EdgerEquals/knob-hardware/cad/README.md

# Parts library

These are the parametric CAD parts for Ed's hardware. Each part has its own folder with the build123d script, a STEP file, a DXF and a drawing PNG.
Dimensions marked [A] are assumed and need checking with calipers. Status is either "listing" (dimensions from listings) or "measured".

| Part | Folder | Version | Status | Notes |
|---|---|---|---|---|
| 1220 coreless planetary gearmotor, 1:144 | motors/1220-coreless-planetary | v0.1 (2026-10-31) | listing | Chosen for knob v1. Ø12 × 38 mm, plus a 5.5 mm D-shaft. Mounting holes TBC. |
| N30 planetary gearmotor | motors/n30-planetary | v0.1 (2026-10-31) | listing | Made from motor_gearbox.py in the 1220 folder by swapping parameters. |
| Knob main PCB | pcbs/knob-main-pcb | v0.9 (2026-10-31) | layout v5 | **Source is KiCad** (kicad/knob-main-pcb.kicad_pcb, made by kicad/make_board.py, KiCad 9.0.2; DRC clean). Plain Edge.Cuts outline 49.00 × 107.50 × 1.6, at x 0.75–49.75, y 10.5–118.0 from the panel top-left. H1 = footprints:Shaft_Hole_NPTH_5.2mm on the dial axis (v0.3: was 6.2; sized for the Ø5.0 brass tube + 0.1 per side [A]). v0.5: H2 is flipped to the back (B side), so the F682ZZ presses in from the PCB back with its flange on the back face; DRC clean, STEP re-exported. v0.4 added H2 = footprints:Bearing_F682ZZ_Press_NPTH_5.0mm (Ø5.0 NPTH press fit for the encoder bearing [A]) at (25.25, 71.9), 19.0 below the dial axis (25.25, 52.9). M1 = footprints:Motor_1220_Tabs at the motor position (39.25, 52.9): 14.0 mm right of the dial axis [A, motor offset TBC, gear/belt drive TBC]. The STEP comes from kicad-cli; knob_main_pcb.py only reads and draws it. | **v0.6:** H2 back on the FRONT (no flip): encoder bearing 1 goes in from the front through the base cradle floor into H2 (locating dowel); hole Ø5.0 NPTH unchanged; DRC 0; STEP re-exported. **v0.7:** H2 rotated 3.0° [A] about the dial axis (idler pinion clearance to the motor). **v0.8:** H1 = TubeRodClamp_Main_M1.6: NPTH Ø1.8 for the M1.6 rod, F.Cu ring Ø3.4–Ø6.4 net GND (brass tube soldered), B.Cu ring Ø2.4–Ø4.4 net VBUS_DATA (rod washer/nut). DRC 0, STEP re-exported. **v0.9:** motor M1 offset 14.0 → 11.0 (32T hub gear), H2 16.0 below the axis on the centre line (ENC_SET_ROT 0), U2 Omron_EE-SX1131 on B.Cu 20.20 below H2; DRC 0, STEP re-exported; sheet v0.9. |
| Knob stack (PCB + 1220 motor) | assemblies/knob-stack-v0.1 | v0.1 (2026-10-31) | superseded by v0.2 | Snapshot: motor on the dial axis, no shaft. The files are kept as drawn; if re-run, the script would pick up the v0.2 board. |
| Knob stack v0.2 (PCB + offset 1220 motor + 6 mm shaft) | assemblies/knob-stack-v0.2 | v0.2 (2026-10-31) | SUPERSEDED by v0.3 | knob_stack.py places everything from the KiCad positions. The shaft base flange sits on the PCB back and the shaft passes through H1; it stands 43.5 above the PCB front (45.0 − the 1.51 STEP board). The motor is on the front at M1: 38.0 mm body, 43.5 mm to its shaft tip. **Clash: the 49 × 49 flange covers the motor tab slots, and the tabs reach about 1 mm into the flange. Flange needs relief for motor tabs [check].** |
| Knob stack v0.3 (PCB + offset 1220 motor + brass 5×3 shaft) | assemblies/knob-stack-v0.3 | v0.3 (2026-10-31) | SUPERSEDED by v0.4 | Contains only the PCB, the 1220 motor at its 14.0 [A] offset (M1), and the brass tube with the printed 17.5 × 17.5 × 4.0 flange. The flange is bonded to the PCB back face. The tube passes through H1 (Ø5.2 NPTH) and runs forward, its back end flush with the flange back. Tube top is 43.49 above the PCB front (45.0 − the 1.51 STEP board). Motor is 38.0, 43.5 to its shaft tip. Flange to the nearest tab pad: 1.50. Pairwise clash check (tube/PCB, tube/motor, flange/PCB, flange/motor): none. Files: knob_stack.py, knob-stack-v0.3.{step,dxf}, knob-stack-v0.3-drawing.png |
| Knob stack v0.4 (all current parts) | assemblies/knob-stack-v0.4 | v0.4 (2026-10-31) | SUPERSEDED by v0.5 | Every part is imported from the library, with no new geometry. Parts: PCB v0.3 (KiCad STEP); 1220 motor at the 14.0 [A] offset; brass shaft v0.2 (57.31 tube plus the 17.5 × 4.0 flange); knob v0.1 (cap + hub, internal ring, bottom ring, pinion, bronze bush); screen holder v0.1; 0.71" GC9D01 TFT; screen adapter board. Key dimensions: 57.00 overall above the PCB front (glass top), knob OD 38.25 (gear tip Ø40.5), holder OD 22.32, motor offset 14.0. Pairwise interference: 16 parts, 120 pairs, 27 with overlapping bounding boxes checked. **Clashes (red on the sheet):** PCB/motor 4.24 mm³ (the motor rear boss Ø3 × 0.6 [A] goes into the PCB front); holder vs. TFT backing 10.20, glass 13.76 and tail 7.43 mm³ (COG ledge and folded tail go through the holder wall). **Notes:** knob OD ≥ the Ø35 bezel; the supplied 100 mm tail needs a short-tail variant. Files: knob_stack.py, knob-stack-v0.4.{step,dxf}, knob-stack-v0.4-drawing.png |
| Knob stack v0.5 (all current parts) | assemblies/knob-stack-v0.5 | v0.5 rev B (2026-10-31) | superseded by v0.6 | **Rev B:** the front view is now full section A-A, cut on the plane through the dial and motor axes (world XZ at the dial y), drawn front-up like the plan. Every cut part has its own hatch: PCB, motor, brass tube, flange, cap+skirt, 68T ring, 90T bottom ring, pinion, bush, encoder big gear (chord), holder, TFT backing, TFT glass, adapter board. The encoder pinion, shaft and bearings are off the plane. The cutting line A-A with arrows is on the side view, because the plane is parallel to the plan view. Same parts as v0.4, but with knob v0.2 (skirt round the motor, 90T bottom internal ring), PCB v0.4 (H2) and encoder take-off v0.1; all imported from the library. The back panel is a dashed line only, 25 [A] behind the PCB back. 57.00 overall above the PCB front; skirt OD 48.00 (ring band Ø49.25); holder OD 22.32; motor offset 14.0; skirt 2.0 above the PCB. Pairwise check: 21 parts, 210 pairs, 33 with overlapping bounding boxes. **Clashes (red):** PCB/motor 4.24 mm³ (motor rear boss Ø3 × 0.6 [A]); holder vs. TFT backing 10.20, glass 13.76 and tail 7.43 mm³. The skirt and the encoder parts clash with nothing. **Notes (red):** the skirt OD is over the 49 PCB width and the Ø35 bezel; the big gear is behind the PCB [A], passing under the shaft flange and the tube's wire exit; the 100 mm tail needs a short-tail variant. Files: knob_stack.py, knob-stack-v0.5.{step,dxf}, knob-stack-v0.5-drawing.png |
| Knob stack v0.6 (all current parts) | assemblies/knob-stack-v0.6 | v0.6 rev A (2026-10-31) | superseded by v0.7 | v0.5 plus bezel v0.1, with knob v0.3 (PTFE 10x8 liner instead of the bronze bush), encoder take-off v0.2 (bearing 1 from the PCB back) and PCB v0.5. Front view = full section A-A through the dial and motor axes, each cut part hatched differently (bezel and PTFE liner now in the cut); the A-A line is on the side view. The screen holder (unchanged) now sits on the bezel face at 47.30, 1.50 higher, so the holder, screen and adapter move up 1.50; overall 58.50 above the PCB front. 22 parts, 231 pairs, 42 with overlapping bounding boxes. **Clashes (red):** PCB/motor 4.24 mm³ (motor rear boss); holder vs. TFT backing 10.20, glass 13.76, tail 7.43 mm³. Bezel, liner and encoder parts clash with nothing. **Notes (red):** tube v0.2 now engages the holder socket only 4.50 of 6.0 (tube +1.50 = 58.81 if wanted; not changed); skirt OD over the board and bezel; big gear behind the PCB; 100 mm tail. Also a shaded isometric half-section (iso_section.py → knob-stack-v0.6-iso-section.png, knob-stack-v0.6-half-section.step; pyvista offscreen, near half removed, cut faces lighter, clashes red). Files: knob_stack.py, iso_section.py, knob-stack-v0.6.{step,dxf}, knob-stack-v0.6-drawing.png |
| Knob stack v0.7 (all current parts) | assemblies/knob-stack-v0.7 | v0.7 rev B (2026-10-31) | superseded by v0.8 | **Rev B (Ed: top-left must be a top view; the right view rotated 90°):** sheet in the new z-up layout. Top-left = TOP view looking down the dial axis (board outline, knob, gears, A-A cutting line with arrows); bottom-left = FRONT = section A-A (Z up, board at the bottom, shaft up); right = RIGHT SIDE view with Z up, so the PCB faces, knob top and shaft tip line up with the section. Notes moved beside the top view. v0.6 with bezel v0.1 → bezel knob v0.2 (Ø48 ring on the big knob, top flush with the glass, ±10° [A]); holder/screen/adapter 1.80 above the holder v0.1 frame (base 47.60). Overall 58.80 above the PCB front. Sheet: section A-A front view, plan and side views. 22 parts, 231 pairs, 50 bbox-overlapping. **Clashes (red):** PCB/motor 4.24 mm³; bezel knob vs TFT backing 13.76, glass 16.53, tail 5.24 mm³ (COG ledge and folded tail into the pocket wall; new); holder vs TFT backing 10.20, glass 13.76, tail 7.43 mm³. **Notes (red):** tube engagement 4.20 of 6.0; skirt OD; big gear behind the PCB; 100 mm tail. Isometric half-section: knob-stack-v0.7-iso-section.png + knob-stack-v0.7-half-section.step (the screen clashes lie in the removed half and are shown whole). Files: knob_stack.py, iso_section.py, knob-stack-v0.7.{step,dxf}, knob-stack-v0.7-drawing.png |
| Knob stack v0.8 (all current parts) | assemblies/knob-stack-v0.8 | v0.8 rev A (2026-10-31) | superseded | knob_stack.py (z-up sheet, section A-A through dial + motor axes, 21 parts, pairwise clash check: PCB/motor 4.24 and the known TFT ledge/tail clashes vs holder and control dial; no tube, cradle or gear clash), iso_section.py (iso half-section PNG + STEP), export_mobile.py (GLB + USDZ full and half-section, m, Y up, coloured per part, re-import checked). Parts: PCB v0.6, base cradle v0.3, brass tube v0.2 (now 4.0 proud of the PCB back, flagged), control dial v0.3, big knob v0.4, encoder v0.3, screen holder v0.2, TFT, adapter. |
| Knob stack v0.9 (all current parts) | assemblies/knob-stack-v0.9 | v0.9 rev A (2026-10-31) | superseded by v0.10 | 32 parts; section A-A through the dial + motor axes, pairwise clash check, iso half-section, GLB + USDZ (whole + half). Big knob v0.5 + 688ZZ, control dial v0.4 + magnet placeholder, screen holder v0.4, brass tube v0.4 + M1.6 rod/sleeve/nuts, base cradle v0.4 (3.5 plate), encoder v0.4 + 2 idler pinions on Ø1.5 pins, PCB v0.8, adapter v0.2. Clashes left: PCB/motor rear boss 4.24 and the known TFT ledge/tail vs holder and control dial. |
| Knob stack v0.10 (all current parts) | assemblies/knob-stack-v0.10 | v0.10 rev A (2026-10-31) | superseded by v0.11 | v0.9 with big knob v0.6 (raised rim removed; top face 52.50, 4.30 below the glass; knob height 50.5) and control dial v0.5 (4.0 lip out to the full Ø48 on top of the knob, 0.3 [A] running gap; magnet placeholder Ø39.4×Ø43.4×2.0 [A] in a pocket in the lip underside, facing the knob top 0.3 below). Bearing 688ZZ → MR128ZZ 8×12×3.5 [A] (40.10–43.60) on the unchanged Ø8.12 dial tube; knob hub Ø19.0 → Ø15.0, outer race on a Ø10.6 bottom lip, dial bears on the inner race through a Ø9.2 collar. 32 parts; clashes unchanged from v0.9 (PCB/motor rear boss 4.24, TFT ledge/tail vs holder and control dial); no knob/dial/bearing clash. Files: knob_stack.py, iso_section.py, export_mobile.py, knob-stack-v0.10.{step,dxf,glb,usdz}, -half-section.{step,glb,usdz}, -drawing.png, -iso-section.png |
| Knob stack v0.11 (all current parts) | assemblies/knob-stack-v0.11 | v0.11 rev A (2026-10-31) | Ed spec | Ed: motor in to the axis, top 68T ring removed, motor drives the knob from its bearing hub: 12T pinion on a 32T m0.5 external hub gear, motor offset 14.0 → 11.0 (ratio 32:12 = 2.667, was 68:12 = 5.667). Knob Ø48 → Ø42 (big knob v0.7), dial lip Ø42 + magnet Ø33.4–37.4 (control dial v0.6, tube extended down to 8.60), 12 × Ø1 ball thrust bearing on the cradle tube collar (bearings/dial-thrust-v0.1), bottom ring 78T, pinions at r 16.0 (encoder 90° from the motor; idlers 41°/150°, flagged), base cradle v0.5 (Ø37), 94T big gear + 119-window slotted rim through an Omron EE-SX1131 (U2, PCB back): 476 counts/gear turn, 2652/knob turn. PCB v0.9 (DRC 0). 34 parts; clashes unchanged (PCB/motor 4.24, TFT ledge/tail vs holder and dial). Ed: no GLB/USDZ any more; deliverable = knob-stack-v0.11-sections.png (A-A straight on + iso, colour). Also: knob_stack.py (sheet + STEP + DXF), iso_section.py (iso sheet, half STEP, sections PNG), encoder_closeup.py (section B-B through the sensor, stack behind the PCB). |
| ~~Fixed hollow shaft, 4 mm~~ | shafts/fixed-hollow-shaft-4mm | v0.1 (2026-10-31) | **SUPERSEDED** | Superseded (now fixed-shaft-brass-5x3); was replaced by fixed-hollow-shaft-6mm (Ed's two-piece FDM redesign). Kept for reference only: stainless tube, Ø4.0 OD × Ø2.0 bore, 45 mm long. |
| ~~Fixed hollow shaft 6 mm (two-piece: base + top)~~ | shafts/fixed-hollow-shaft-6mm | v0.1 (2026-10-31) | **SUPERSEDED** | Superseded by fixed-shaft-brass-5x3. The two-piece printed shaft is kept for reference only. |
| ~~Fixed hollow shaft 4 mm, one piece (printed, splined)~~ | shafts/fixed-hollow-shaft-4mm-onepiece | v0.1 (2026-10-31) | **SUPERSEDED** | Superseded by fixed-shaft-brass-5x3 before it was finished: a splined top isn't practical, so the shaft went to metal. Kept for reference only. |
| Fixed shaft: brass tube 5 × 3 | shafts/fixed-shaft-brass-5x3 | v0.1 (2026-10-31) | SUPERSEDED by v0.2 | Brass tube 5 OD × 3 ID stock, cut to length, knurl dial end only. 49.0 long: 45 [A] above the flange front face plus the 4.0 flange. The back end sits flush with the flange back. Top 8 mm [A]: straight knurl for the epoxy bond, or 2 opposed 0.3 flats [A]; drawn hatched, not modelled. 0.3 deburr at both bore ends [A]. Carries 4 × 36 AWG. The PCB hole must change to 5.2 mm (not yet done). Files: brass-tube-5x3.* |
| Fixed shaft: printed flange | shafts/fixed-shaft-brass-5x3 | v0.1 (2026-10-31) | SUPERSEDED by v0.2 | CF-ASA or PETG. Custom square: the 20.0 target [A] shrinks automatically to 17.5 × 17.5 so it stays ≥ 1.5 [A] from the motor tab pads (read from KiCad M1, motor 14.0 offset [A]). Actual clearance 1.50. 4.0 thick [A], Ø5.0 bore, centred on H1. The tube is epoxy-bonded in, and the flange is bonded to the PCB back. Files: shaft-flange-printed.* |
| Fixed shaft: brass + flange together | shafts/fixed-shaft-brass-5x3 | v0.1 (2026-10-31) | SUPERSEDED by v0.2 | Tube bonded into the flange. All three sheets come from fixed_shaft_brass.py. Files: fixed-shaft-brass-5x3-assembled.* |
| Knob cap + hub | knob/knob-v0.1 | v0.1 (2026-10-31) | SUPERSEDED by knob v0.2 (pinion, 68T ring, hub and bush still used from here) | Printed CF-ASA or PETG, one piece with both ring gears [A]. Cap Ø38.25 × 1.5 [A], top 45.5 above the PCB front. Hub Ø11 [A] × 6.0 with an Ø8.0 bore for a bronze bush 5x8x6 [A] that runs on the Ø5 brass tube. **Flag:** knob OD 38.25 (bottom-gear tip Ø40.5) is ≥ the Ø35 bezel. The tube flags are cleared since shaft v0.2: the tube top is at 51.8, so the bush is fully engaged (6.0 of 6.0) and the knurl zone starts at 45.8, above the bush. The bush is a bought part, modelled by build_bush() in knob_gears.py. Files: knob-cap-hub.* |
| Motor pinion | knob/knob-v0.1 | v0.1 (2026-10-31) | SUPERSEDED by knob v0.2 (pinion, 68T ring, hub and bush still used from here) | 12T, m 0.5, 20° involute (generated in knob_gears.py), backlash 0.10 [A]. Tip Ø7.0, pitch Ø6.0, root Ø4.75. D-bore Ø3.05 / flat 2.55 [A] for the 1220 3 mm D-shaft. Face 3.0 [A], front flush with the shaft tip (40.5–43.5 above the PCB front). **Flag:** 0.88 wall to the shaft; undercut below 17T, no profile shift. Files: motor-pinion.* |
| Internal ring gear | knob/knob-v0.1 | v0.1 (2026-10-31) | SUPERSEDED by knob v0.2 (pinion, 68T ring, hub and bush still used from here) | 68T internal, m 0.5, pitch Ø34.0, tip Ø33.0, root Ø35.25. The OD is Ø38.25, giving a 1.5 wall outside the root [A]. Band 40.0–44.0 above the PCB front (pinion ± 0.5 [A]). Centre distance (68 − 12) × 0.5 / 2 = 14.00, which equals the KiCad motor offset exactly. Files: internal-ring-gear.* |
| Bottom ring gear (encoder take-off) | knob/knob-v0.1 | v0.1 (2026-10-31) | SUPERSEDED by knob v0.2 (pinion, 68T ring, hub and bush still used from here) | 79T external, m 0.5 [A]. The tooth count is a parameter: by default, the smallest count whose root is ≥ the knob OD. Pitch Ø39.5, tip Ø40.5, root Ø38.25, bore Ø35.25. Face 1.5 [A] at the knob base (38.5 = motor front + 0.5 [A]). Encoder pinion TBC, not drawn. Files: bottom-ring-gear.* |
| Knob v0.1 together | knob/knob-v0.1 | v0.1 (2026-10-31) | SUPERSEDED by knob v0.2 (pinion, 68T ring, hub and bush still used from here) | Knob + pinion (at the 14.0 offset) + both rings, all from knob_gears.py. Knob height 7.0 (38.5–45.5 above the PCB front). Pairwise clash check (pinion vs. internal ring / cap+hub / bottom ring): none. Not in the assembly yet. Files: knob-v0.1-together.{step,dxf}, knob-v0.1-together-drawing.png |
| Knob v0.2 cap + skirt | knob/knob-v0.2 | v0.2 (2026-10-31) | superseded by knob v0.3 | The dial body now wraps around the outside of the offset motor and comes down to 2.0 above the PCB front [Ed]. Skirt ID Ø44.00 = 2 × (20.0 motor reach + 2.0 clearance [Ed]); OD Ø48.00 (2.0 wall [A]). The cap spans from the hub to the skirt at 44.0–45.5. The hub, bush bore, 68T ring, 12T pinion and bronze bush are unchanged and imported from knob v0.1. **Flag:** the skirt OD is over the 49 PCB width and the Ø35 bezel. Files: knob_v02.py, knob-cap-skirt.* |
| Knob v0.2 bottom internal ring (encoder) | knob/knob-v0.2 | v0.2 (2026-10-31) | superseded by knob v0.3 | 90T INTERNAL, m 0.5, 20° involute, replacing v0.1's external 79T. Tooth count = the smallest whose tip circle stays ≥ the skirt ID. Tip Ø44.00, pitch Ø45.00, root Ø46.25; band OD Ø49.25 (1.5 outside the root [A]), stepping out from the 48.0 skirt. Face 3.0 [A], 2.0–5.0 above the PCB front at the skirt's bottom inner edge. Driven part: encoder take-off v0.1 (its 14T pinion meshes inside; sheet notes updated, the stale 'TBC, not drawn' note is gone). Files: bottom-internal-ring.* |
| Knob v0.2 together | knob/knob-v0.2 | v0.2 (2026-10-31) | superseded by knob v0.3 | Cap/skirt + 68T ring + 90T bottom ring + 12T pinion + bush. Knob height 43.5 (2.0–45.5). No clash between the knob parts. Files: knob-v0.2-together.{step,dxf}, knob-v0.2-together-drawing.png |
| Control dial v0.1 (was "bezel", then "bezel knob") | control-dial/control-dial-v0.1 | v0.1 (2026-10-31) | superseded | Renamed CONTROL DIAL by Ed; folder moved from bezel-knob/bezel-knob-v0.1. Title re-rendered "superseded". |
| Control dial v0.2 (was "bezel knob v0.2") | control-dial/control-dial-v0.2 | v0.2 (2026-10-31) | superseded by control dial v0.3 | Folder moved from bezel-knob/bezel-knob-v0.2; geometry unchanged. |
| Knob v0.3 cap + skirt | knob/knob-v0.3 | v0.3 (2026-10-31) | superseded by knob v0.4 | v0.2 with the hub bore only changed: Ø8.0 → Ø10.0 for the PTFE 10x8x6 liner [S], hub OD 11 → 13 (1.5 wall kept [A]). The bronze bush is removed. Section A-A as the front view. Files: knob_v03.py, knob-cap-skirt.* |
| Knob v0.3 together | knob/knob-v0.3 | v0.3 (2026-10-31) | superseded by knob v0.4 | Cap/skirt + 68T ring + 90T bottom ring + 12T pinion + PTFE liner 10 × 8 × 6 [S] (pressed in the hub, turns with the knob, runs on the bezel journal). No clash between the knob parts. Files: knob-v0.3-together.{step,dxf}, knob-v0.3-together-drawing.png |
| Encoder take-off v0.1: bearings | encoder-takeoff/encoder-takeoff-v0.1 | v0.1 (2026-10-31) | superseded by encoder take-off v0.2 | 2 × F682ZZ flanged miniature ball bearing, 2 × 5 × 2.3, flange Ø6.1 × 0.6 [A] (envelope). Bearing 1 is pressed into PCB H2 (Ø5.0 NPTH [K]) with its flange on the front; bearing 2 sits in the back panel [A]. Files: encoder-bearing-f682zz.* |
| Encoder take-off v0.1: pinion | encoder-takeoff/encoder-takeoff-v0.1 | v0.1 (2026-10-31) | superseded by encoder take-off v0.2 | 14T [A], m 0.5, 20° involute, Ø2 bore [Ed], face 2.6 [A] at 2.2–4.8 above the PCB front, hub Ø3.5 on the bearing inner race. Meshes inside the dial's 90T bottom ring: (90 − 14) × 0.5 / 2 = 19.00 = the KiCad H2 offset. Placed below the dial axis, 90° from the motor [A]. Ratio 90:14 = 6.429. Files: encoder-pinion.* |
| Encoder take-off v0.1: shaft | encoder-takeoff/encoder-takeoff-v0.1 | v0.1 (2026-10-31) | superseded by encoder take-off v0.2 | Ø2 steel [Ed/A], 33.01 long: from the pinion top (4.8 above the PCB front) to the bottom of bearing 2. The back panel is 25 behind the PCB back [A] (unknown) and is drawn only as a dashed line. Files: encoder-shaft.* |
| Encoder take-off v0.1: big gear | encoder-takeoff/encoder-takeoff-v0.1 | v0.1 (2026-10-31) | superseded by encoder take-off v0.2 | 94T, m 0.5 [A], tip Ø48.0: the biggest that fits the 49.0 board width with a 0.5 margin [A]. Hub Ø5 × 2 [A]. It sits BEHIND the PCB [A] (only 2 mm under the skirt), with its top 6.01 behind the PCB front (board + 4 flange + 0.5). **Flag:** it passes under the shaft flange and the tube's wire exit. It drives the encoder (TBC, not drawn). Files: encoder-big-gear.* |
| Encoder take-off v0.1 together | encoder-takeoff/encoder-takeoff-v0.1 | v0.1 (2026-10-31) | superseded by encoder take-off v0.2 | encoder_takeoff.py: bearings, pinion, shaft and big gear; PCB faces and the back panel are dashed reference lines. No clash between these parts. Files: encoder-takeoff-together.{step,dxf}, encoder-takeoff-together-drawing.png |
| Encoder take-off v0.2 (all parts + together) | encoder-takeoff/encoder-takeoff-v0.2 | v0.2 (2026-10-31) | superseded by encoder take-off v0.3 | Ed: the PCB bearing comes in from the other way. Bearing 1 (F682ZZ 2 × 5 × 2.3, flange Ø6.1 × 0.6 [A]) now presses in from the PCB BACK with its flange on the back face (−2.11 to +0.19); KiCad H2 flipped to B (PCB v0.5). Only the pinion hub changes: it rests on the inner race at 0.19 (hub 2.0 long, was 1.6). Teeth 2.2–4.8, shaft 33.01, 94T big gear and bearing 2 are unchanged. Ratio 90:14 = 6.429. Files: encoder_takeoff_v02.py, encoder-{bearing-f682zz,pinion,shaft,big-gear,takeoff-together}.{step,dxf}, *-drawing.png |
| Fixed shaft v0.2: brass tube 5 × 3 + flange | shafts/fixed-shaft-brass-5x3-v0.2 | v0.2 (2026-10-31) | superseded (tube v0.4; flange replaced by the base cradle) | Brass tube 5 OD x 3 ID stock, cut to length, knurl dial end only. **Length derived** from the screen holder: the top ends at the holder socket's blind end, 51.8 above the PCB front (knob top 45.5 + 0.3 [A] + 6.0 socket [A]). That gives 53.31 above the flange front, 57.31 long (v0.1: 49.0). **Ed said shorten, but the derived length is longer [check].** Knurl zone = the 6.0 socket engagement. Flange unchanged: 17.5 × 17.5 × 4.0, 1.50 to the tab pads. Three sheets from fixed_shaft_brass_v02.py. Files: brass-tube-5x3.*, shaft-flange-printed.*, fixed-shaft-brass-5x3-assembled.* |
| 0.71" round TFT (GC9D01, centre-button screen) | displays/tft-0.71-round-gc9d01 | v0.1 (2026-10-31) | datasheet + [A] | 160x160 IPS, GC9D01N (the GC9A01 is the 1.28" 240x240 panel). Backing Ø20.12 [S] (the glass OD used for the holder), LCD Ø19.9 [S], 22.30 overall including the COG ledge [S], active Ø18 [S], 1.90 thick [S] (glass 1.1 / backing 0.8 [A]). Ledge width 12.0 [A]. Tail 14 pin, 7.50 wide, 0.30 thick, 2.5 stiffener, supplied 100 long [S], pitch 0.5 [A]; drawn folded behind. Source: Zhunyi spec Z07101-P14-G9DN-Y1 V1.0, mechanical drawing p.5, https://www.panelook.cn/upload/product/258253/202502242704.pdf; cross-checked with EastRising ER-TFT0.71-2 (buydisplay.com, 20.12 × 22.30 × 1.8) and SWICN LB071R-PF01 (1.86 thick, 10-pin ZIF 0.5 pitch). **Flag:** the 100 mm tail needs a short-tail variant. Files: tft_071_round.py, tft-0.71-round-gc9d01.* |
| Screen adapter board | pcbs/screen-adapter | v0.2 (2026-10-31) | Ed spec | **Source is KiCad** (kicad/screen-adapter.kicad_pcb, made by kicad/make_board.py; DRC clean, 0 violations). Round Ø15.5 [A] (≤ 18), 2 layers, 1.0 thick [A]. Placed, not routed: J1 FPC_14P_0.5mm_Top [A] at y +3.2; U1 QFN-20_3x3_P0.4_CH32V003 (CH32V003F4U6 [A]) at y −3.5; W1 WirePads_4x_0.7mm_Back (VCC GND D1 D2) on the back at the centre, over the Ø3.0 wire bore. The footprints are in the shared kicad/footprints.pretty. STEP = bare board (0.91 body); screen_adapter.py adds component envelopes [A] for drawings. Files: screen-adapter.step, screen_adapter.py, screen-adapter.dxf, screen-adapter-drawing.png | **v0.2:** W1 wire pads removed (data over power); C1 = TubeRodClamp_Adapter_M1.6: NPTH Ø1.8, B.Cu ring Ø3.2–Ø5.6 GND (tube top contact), F.Cu ring Ø2.4–Ø3.6 VBUS_DATA (thin nut). J1 moved to 3.7, U1 to 3.8 from the centre. DRC 0. kicad-cli drops the hole in the STEP for the circular outline, so screen_adapter.py cuts the NPTH holes from the KiCad data.
| Screen holder | holders/screen-holder-v0.1 | v0.1 (2026-10-31) | Ed spec | Printed CF-ASA or PETG cup, FIXED, epoxy-bonded on the knurled tube top. Socket Ø5.2 (0.1 glue gap per side [A]) × 6.0 [A]; Ø3.0 wire passage; 1.0 floor [A]; board pocket Ø15.9; screen pocket Ø20.32 × 1.90, glass flush with the rim [A]. OD 22.32 = 20.12 + 2 × 0.1 + 2 × 1.0 wall [A]. Spans 45.8–57.0 above the PCB front: bottom = knob top 45.5 + 0.3 running clearance [A]. Files: screen_holder.py, screen-holder.* |
| Screen stack together (holder + TFT + board + tube top) | holders/screen-holder-v0.1 | v0.1 (2026-10-31) | Ed spec | screen_stack_together.py; not in the main assembly yet. **Clash (red on the sheet):** the screen's COG ledge reaches 12.24 from the axis, and the folded tail also sits outside the 11.16 holder radius. Overlaps: ledge/backing 10.20 mm³, glass 13.76 mm³, tail 7.43 mm³; this needs a slot or a bigger OD. No other clash. Files: screen-stack-together.{step,dxf}, screen-stack-together-drawing.png |
| Control dial v0.3 | control-dial/control-dial-v0.3 | v0.3 (2026-10-31) | superseded | PETG, spring-centred Hall-sensed ±10° [A] (spring/magnet/Hall TBC, not drawn). Plain tube Ø5.12/Ø8.12 (1.5 wall) on the brass from 13.00 (above the reserved bearing zone over the base cradle boss) to the body 45.80–56.80, OD 48, top flush with the glass; 5.70 thick near the axis; bore Ø7.30 over the holder boss. |
| Big knob v0.4 (cap + skirt + tube, 68T, 90T, pinion) | knob/knob-v0.4 | v0.4 (2026-10-31) | superseded | No OD step: one Ø48 the whole height, 90T kept (local wall 0.875 outside the root, flagged red). Plain tube Ø8.24/Ø11.24 (1.5 wall) on the control-dial tube from 13.00 to the hub; motor clears the tube by 2.38. 8.0–13.0 above the PCB front reserved for future bearing [A] (not drawn). |
| Screen holder v0.2 | holders/screen-holder-v0.2 | v0.2 (2026-10-31) | superseded | Thinner: walls/floor 0.8 [A]; boss Ø7.0 on the tube top 51.80; socket engagement 5.70 (spec 6.0, flagged); glass top 56.80. |
| Base cradle v0.3 (was the shaft flange) | base-cradle/base-cradle-v0.3 | v0.3 (2026-10-31) | superseded | Printed CF-ASA/PETG [A], bonded to the PCB FRONT (nothing on the back now). Ø43.0 × 36.0 solid fill inside the skirt (0.5 [A] to skirt ID / 90T tips), Ø5.2 bonded tube bore 8.0 long, Ø12.2 bonded motor bore (tab pads inside, 2.16 margin), Ø12.24 clear bore round the dial tubes above 8.0, Ø9.0 encoder pinion pocket above a 1.0 [A] floor with a Ø5.0 press bore: encoder bearing 1 goes through it into PCB H2 = locating dowel. Base plate 3.0 [A] merges into the fill. |
| Encoder take-off v0.3 (pinion + together) | encoder-takeoff/encoder-takeoff-v0.3 | v0.3 (2026-10-31) | superseded | Bearing 1 pressed in from the FRONT: flange on the cradle floor (top 1.60), body 1.0 in the cradle + 0.70 in the PCB (dowel). Pinion hub 0.6 (was 2.0); teeth, shaft 33.01, 94T Ø48 big gear, bearing 2 and H2 position (90° from the motor, 19.0 along the board) unchanged. |
| Big knob v0.5 (body + 688ZZ + rings + pinion) | knob/knob-v0.5 | v0.5 (2026-10-31) | superseded by v0.6 | Big-knob tube removed. Short hub Ø19.0 houses a 688ZZ 8×16×5 [A] (38.60–43.60) whose inner race is pressed on the unchanged control-dial tube Ø8.12. Thick body (top 47.20 under the dial web, 52.50 under the lip), 2.0 [A] raised rim at the OD up to 56.80 round the dial lip + magnet. OD Ø48 no step, skirt, 68T, 90T, 12T pinion kept; height 54.8. |
| Big knob v0.6 (body + MR128ZZ + rings + pinion) | knob/knob-v0.6 | v0.6 (2026-10-31) | superseded by v0.7 | v0.5 with the raised rim removed: top face 52.50 (4.30 below the glass, under the Ø48 dial lip, 0.3 [A]); height 50.5 bottom ring to top. MR128ZZ 8×12×3.5 [A] at 40.10–43.60, inner race on the control-dial tube Ø8.12; hub Ø15.0 (1.5 wall [A]), 3.0 from the pinion tips, 1.6 above the motor front; outer race pressed in on a Ø10.6 × 0.5 bottom lip [A]. Files: knob_v06.py, knob-body / knob-v0.6-together .{step,dxf,png} |
| Big knob v0.7 (body + 32T hub gear + MR128ZZ + 78T ring + pinion) | knob/knob-v0.7 | v0.7 (2026-10-31) | Ed spec | 68T internal ring removed; 32T m0.5 external gear on the bearing hub (tip Ø17.0, root Ø14.75, 39.60–44.00; 1.375 root wall over the Ø12 bearing bore, flagged); 12T pinion at offset 11.0 [K]. 31T/10.75 rejected (1.125 wall), 30T/10.5 (motor 0.44 from the dial tube). OD Ø42.0 (skirt ID 38 = 2.0 to the motor), 78T bottom ring (0.875 wall, flagged). Height 50.5, top 52.50, MR128ZZ as v0.6. Files: knob_v07.py, knob-body / knob-v0.7-together .{step,dxf,png} |
| Control dial v0.4 + magnet placeholder | control-dial/control-dial-v0.4 | v0.4 (2026-10-31) | superseded by v0.5 | Tube Ø5.12/Ø8.12 from 13.00 unchanged [Ed]. Hub Ø11.30 (2.0 wall) round the holder boss, 1.5×45° gusset, 4.0 web under the screen cup, 4.0 lip (52.80–56.80) Ø39.4, flush with the glass. Brass runs inside the dial to 46.30 past the tube/hub junction; 688ZZ inner race directly under the hub (snap-off fix). Magnet [A] size TBC: Ø39.4 × Ø43.4 × 3.0 ring on the lip OD, 0.3 to the knob rim. |
| Control dial v0.5 + magnet placeholder | control-dial/control-dial-v0.5 | v0.5 (2026-10-31) | superseded by v0.6 | Lip 4.0 (52.80–56.80, flush with the glass) out to Ø48 = big knob OD [Ed], 0.3 [A] above the knob top. Magnet placeholder [A] (size TBC) Ø39.4×Ø43.4×2.0 in a pocket in the lip underside, 2.0 skin above. Hub face raised 0.3 with a Ø9.2 [A] collar onto the MR128ZZ inner race. Tube Ø5.12/Ø8.12 from 13.00 unchanged [Ed]; web, hub, gusset, fillet as v0.4. Files: control_dial_v05.py, control-dial .{step,dxf}, control-dial-drawing.png, magnet-placeholder.step |
| Control dial v0.6 + magnet placeholder | control-dial/control-dial-v0.6 | v0.6 (2026-10-31) | Ed spec | Lip 4.0 out to Ø42 = knob OD; magnet [A] Ø33.4–Ø37.4 × 2.0 in the lip underside. Tube Ø5.12/Ø8.12 unchanged but extended down from 13.00 to 8.60 onto the dial thrust bearing (groove race in its bottom face). Files: control_dial_v06.py, control-dial .{step,dxf}, control-dial-drawing.png, magnet-placeholder.step |
| Dial thrust bearing (ball carrier + 12 balls) | bearings/dial-thrust-v0.1 | v0.1 (2026-10-31) | Ed spec | 12 × Ø1.0 steel balls [Ed] on PCD Ø6.80 [A] between the cradle tube collar (8.00) and the dial tube bottom (8.60); grooves R0.55 × 0.25 [A] in both faces (0.11 from the tube OD, flagged); printed carrier Ø5.30 × Ø8.60 × 0.40 [A], 12 × Ø1.10 pockets, web 0.66. Option: thin steel washers [A]. Files: dial_thrust_v01.py, thrust-carrier(.step/.dxf/-drawing.png), thrust-carrier-with-balls(...) |
| Screen holder v0.3 | holders/screen-holder-v0.3 | v0.3 (2026-10-31) | superseded by v0.4 | Boss 0.3 longer: socket 6.00. |
| Screen holder v0.4 | holders/screen-holder-v0.4 | v0.4 (2026-10-31) | Ed spec | Brass tube now runs through the floor to the adapter board (tube top 52.60 = board seat; the rod clamps the board on the tube). Socket Ø5.2 through, 6.00 on the tube (boss 46.60). Glass 56.80 unchanged. |
| Fixed shaft v0.3: brass tube | shafts/fixed-shaft-brass-5x3-v0.3 | v0.3 (2026-10-31) | superseded by v0.4 | 53.31, flush with the PCB back. |
| Fixed shaft v0.4: brass tube (GND) | shafts/fixed-shaft-brass-5x3-v0.4 | v0.4 (2026-10-31) | Ed spec | 52.60 long; bottom soldered on the PCB F.Cu GND ring (no longer through the board), top bears on the adapter B.Cu GND ring. |
| Centre rod M1.6 + sleeve + nuts/washer (VBUS_DATA) | shafts/rod-m1.6-v0.1 | v0.1 (2026-10-31) | Ed spec | M1.6 rod [A] 58.21 (−3.61 to 54.60), sleeve Ø1.7/Ø2.6 × 52.6 [A] (PTFE or 3/32" 2:1 heatshrink; 0.70 radial room, 0.20 to the bore). Top DIN 439 thin nut s3.2×1.0 on the adapter (0.30 under the screen); bottom DIN 125 washer + DIN 934 nut under the PCB. |
| Base cradle v0.4 | base-cradle/base-cradle-v0.4 | v0.4 (2026-10-31) | superseded by v0.5 | 3.5 [A] plate Ø43.0 on the PCB front (was the 36 solid). Tube collar Ø9.2 to 8.0 (7.4 bonded above a Ø7.0×0.6 counterbore over the solder ring), motor collar Ø15.0 to 12.0 [A], encoder bearing seat (1.0 floor, Ø5.0, dowel into H2), 2 idler pockets (1.7 floor, Ø1.5 pin holes). |
| Base cradle v0.5 | base-cradle/base-cradle-v0.5 | v0.5 (2026-10-31) | Ed spec | Plate Ø37.0 × 3.5; motor collar Ø15 (at 11.0) merged with the Ø9.2 tube collar (2.3 web between bores); thrust groove race on the collar top (8.0); Ø9.12 clearance + window round the dial tube 8.0–12.0; encoder pocket at 16.0 on the centre line, idler pockets/pins at 41° and 150°. Files: base_cradle_v05.py, base-cradle.{step,dxf}, base-cradle-drawing.png |
| Encoder take-off v0.4 (idler pinion + pin, together) | encoder-takeoff/encoder-takeoff-v0.4 | v0.4 (2026-10-31) | superseded by v0.5 | 3 × 14T pinions 120° apart in the 90T ring; set rotated 3.0° [A] (encoder 273°, idlers 33°/153°, motor 0°) so the nearest idler clears the motor by 0.53. Idlers: plain Ø1.6 bore on Ø1.5 steel pins [A] (5.4 long, Ø3.5 head), pin engagement 1.7 [check]. Big gear now 90T Ø46.0 (was 94T) to stay on the board [check]. |
| Encoder take-off v0.5 (sensor, big gear + slotted rim, idler, together) | encoder-takeoff/encoder-takeoff-v0.5 | v0.5 (2026-10-31) | Ed spec | 78T ring, three 14T pinions at r 16.0: encoder 270° (90° from the motor), idlers 41° (min 40.73° to clear the motor) and 150°, gaps 131/109/120° (flagged; the alternative was rotating the whole set 11° and dropping the big gear to 81T). Big gear 94T Ø48 on the centre line + slotted rim r 19.60–20.80, 119 windows pitch 1.0667 (0.8 channel spacing = 3/4 pitch, quadrature), resin print flagged. Encoder Omron EE-SX1131 [Ed] modelled from the datasheet (5 × 4 × 4, slot 2.0 × 2.8, axis 1.0 from the open face; tabs [A]). Behind-PCB stack: PCB back −1.51, sensor to −5.51, rim top −3.31, gear −6.01/−8.01, hub −10.01, bearing 2 −25.91/−28.21 (shaft end); back panel 25 [A], minimum 9.6. Files: encoder_takeoff_v05.py, encoder-sensor-ee-sx1131.*, encoder-big-gear-slotted-rim.*, idler-pinion-pin.*, encoder-takeoff-together.* |
| Shared footprints: tube/rod clamp | kicad/footprints.pretty (make_rodclamp_footprints.py) | v0.1 (2026-10-31) | Ed spec | TubeRodClamp_Main_M1.6 and TubeRodClamp_Adapter_M1.6: NPTH Ø1.8 + custom SMD ring pads (sizes in the board rows). |
| Footprint: Omron EE-SX1131 | kicad/footprints.pretty (make_eesx1131_footprint.py) | v0.1 (2026-10-31) | datasheet | 6 SMD pads 2.0 × 1.0 at ±2.5, pitch 1.4 (datasheet recommended pattern), pads 1–6 = A, NC, K, C, E1, E2 [A]; slot along Y; placed on B.Cu as U2. |

KiCad footprint library: kicad/footprints.pretty (Motor_1220_Tabs and Shaft_Hole_NPTH_5.2mm (current; the 6.2 file is kept for v0.2), plus FPC_14P_0.5mm_Top, QFN-20_3x3_P0.4_CH32V003 and WirePads_4x_0.7mm_Back for the screen adapter, Bearing_F682ZZ_Press_NPTH_5.0mm for the encoder bearing; generated by kicad/make_footprints.py from the motor parameters). Shared drawing code: tools/sheet.py (set_front_section() swaps the front view for a hatched section; cut_line() draws an A-A cutting line with arrows).
Sheet layout (tools/sheet.py): DEFAULT is now layout "z-up" (Ed, assembly v0.7 rev B): every elevation has the dial axis up the sheet; TOP view (down the dial axis) above the front, RIGHT SIDE (x = Y, y = Z) to its right, strict third angle. All existing part scripts pass layout="panel" explicitly and render as before (not re-rendered). Earlier convention (Ed 2026-10-31): plan views are drawn front-up (toward the panel = up the sheet; shaft tip at top). Set PLAN_FRONT_UP = False for a strict third-angle plan.
