EdgerEquals/knob-hardware/cad/knob-param/knobparam/electronics/kicad/knob-main-pcb/fab/README.txt

knob-main-pcb v0.11 PCBWay pack, generated 2026-11-01 17:33 AWST by fab_export.py
READY TO QUOTE

{
  "board": "knob-main-pcb",
  "rev": "v0.11",
  "erc_messages": 0,
  "erc_errors": 0,
  "erc_warnings": 0,
  "drc_violations": 0,
  "drc_unconnected": 0,
  "drc_parity": 0,
  "bom_rows": 10,
  "cpl_parts": 22,
  "gerber_files": 14,
  "bom_rows_without_lcsc": []
}

Board: 2 layers, FR-4; thickness per the .kicad_pcb (main 1.6 mm, adapter 1.0 mm); HASL or ENIG; green mask, white silk [A].
Hand-fit parts (excluded from BOM/CPL): main H1 rod pad, M1 1220 motor, M2 716 motor leads, J10 MCU-link pads; adapter C1 rod clamp.
