EdgerEquals/knob-hardware/cad/knob-param/knobparam/electronics/kicad/screen-adapter/fab/README.txt

screen-adapter v0.4 PCBWay pack, generated 2026-11-01 17:22 AWST by fab_export.py
NOT READY TO ORDER (see below)

{
  "board": "screen-adapter",
  "rev": "v0.4",
  "erc_messages": 1,
  "erc_errors": 0,
  "erc_warnings": 1,
  "drc_violations": 0,
  "drc_unconnected": 3,
  "drc_parity": 0,
  "bom_rows": 3,
  "cpl_parts": 3,
  "gerber_files": 14,
  "bom_rows_without_lcsc": [
    "J1"
  ]
}

Board: 2 layers, FR-4; thickness per the .kicad_pcb (main 1.6 mm, adapter 1.0 mm); HASL or ENIG; green mask, white silk [A].
Hand-fit parts (excluded from BOM/CPL): main H1 rod pad, M1 1220 motor, M2 716 motor leads, J10 MCU-link pads; adapter C1 rod clamp.
