EdgerEquals/knob-hardware/docs/design-notes.md

# Knob module: design notes (current: CAD v0.16b, 1 Nov 2026)

A short summary of the current design. The parametric model in `cad/knob-param/` is the source of truth for
dimensions. Values marked [A] are assumptions that still need checking with calipers or on a prototype.
Renders: `cad/assemblies/knob-stack-v0.16b/` (clean section + iso, plan view, `check.json`); v0.16 kept in
`cad/assemblies/knob-stack-v0.16/`. Top-screen joystick stack: `cad/assemblies/joystick-v0.4/` (v0.3 kept beside it; see
`docs/top-screen-joystick.md`).

## v0.16b changes (Ed, 1 Nov 2026)
- **Relative knob-vs-dial sensor removed** (duplicate of the encoder + Hall row): no ring magnet in the knob, no
  TMAG5273 board or pocket in the dial. The code is kept behind `rel_sensor` (False).
- **Middle Hall-row sensor (H3) is now a 3D TMAG5273A2** (SOT-23-6), the other four stay TMAG5253. Pitch 2.5 kept.
- **Hall magnets alternate N/S/N/S/N** (`hv_pol`, face down toward the sensors).
- The SOT-23-6 is 1.45 tall against 0.4 for the X2SON, so the magnet bar went up 0.15 (faces at z 1.75):
  0.30 air gap over the TMAG5273, 1.35 over the TMAG5253s.
- Fields: TMAG5253 peak |Bz| 45.7 mT (57% of ±80; was 57.6). TMAG5273 at a 1.10 element gap: |Bz| ≤ 83.6,
  |Bx|,|By| ≤ 29.0 mT. That saturates the ±80 mT A1, so the **A2 (±133 mT)** is specified (63%).
  Angle noise is still 0.002° rms worst case.

## Product
- A standalone motorised-knob MIDI + CV controller in Eurorack, **10HP** (50.5 mm), one knob unit in the upper
  half of the 3U panel. It grows into a node of a larger system later (rear bus + clock connector reserved).
- Panel, top to bottom: the top screen on its joystick carrier, then the dial (bezel/control dial around the big
  motorised knob, a round screen in the centre), then a clear layered optical panel with a 2.0" 320×240 IPS TFT
  mounted on the main PCB behind it (air gap, not bonded), then three stereo jacks and a USB-C in one row.
- Jacks (Thonkiconn stereo): J1 tip dial CV out / ring bezel CV out; J2 tip CV in (the motor follows it) / ring
  gate out (button); J3 tip motor-voice audio in / ring motor-texture audio out. No jack switches role.
- USB-C carries MIDI and PD power (9–15 V negotiated). Dual input with the Eurorack bus (the bus has priority
  when racked), ±12 V generated for CV on USB power, and USB ground isolation away from the audio path.
- Optical panel: a laminate (AR glass, etched mask, phosphor zones) edge-lit by recessed 365 nm UV LEDs, driven
  by linear constant-current (no PWM). The screens show an *analogy* of the parameter being changed.

## Motor, feel and sensing
- **Main motor:** a 1220 coreless planetary (N30 as a parameter swap), offset from the dial axis and soldered to
  the main PCB by its tabs. Its 19T pinion drives the 24T knob hub gear (m0.5, ratio 1.263).
  The design is motor-agnostic: the encoder reads the dial, not the motor, and boot calibration learns
  backlash and speed as ratios.
- **Electronic clutch (no mechanical slip clutch):** the motor assists the direction the hand moves, using
  the encoder plus gearbox backlash, so the hand can lead. Current sensing plus a thermal probe drop it to
  freewheel on a sustained stall, and the screen says why.
- **Motor voice:** a switchable mode in which audio is modulated onto the motor drive and recorded back through
  back-EMF sensing and a contact mic. A bypassable filter keeps the normal mode quiet.
- **Feel motor (v0.16):** a 716 coreless, axial and inverted (shaft down) inside the base cradle at 102°,
  between the bottom-ring idlers at 54° and 150°. It has its own 22T pinion into the 75T bottom internal ring
  (ratio 3.41). It is held by an **open saddle clamp**: an inboard seat (2 bands + spine onto a cradle rib) and an
  outboard strap (2 × 1.2 mm C-bands, ears + M1 screw). Most of the can stays open for airflow.
- **Position encoder:** a 14T pinion in the bottom ring drives a shaft (2 × F682ZZ) through the PCB to a plain
  disc with a vertical slotted rim, read by an Omron **EE-SX1321** on the PCB back (main PCB v0.11, 1 Nov 2026; it
  replaces the discontinued EE-SX1131). The old big-gear rim teeth were removed in v0.16 because nothing meshed with them.
  - EE-SX1321 (datasheet): body 5.1 × 4 × 4, slot 2.0 ±0.2 wide and 2.8 deep, optical axis 1.0 below the open face, two
    0.3 × 1.0 detector apertures 0.8 apart along the slot. Pins: 1 anode, 2 + 3 cathode, 4 E2, 5 E1, 6 collector
    (common). Net map: 1 ENC_LED (220R to 3V3, IF ≈ 10 mA), 2/3 GND, 6 +3V3, 5 ENC_A, 4 ENC_B (10k loads to GND).
  - Fit: the 1.2 rim sits in the 2.0 slot with 0.4 a side (0.3 at the slot's −0.2 tolerance), its tip 0.6 short of the
    slot floor; 119 windows at 1.067 pitch put the 0.8 aperture spacing at 3/4 period (quadrature). The disc face
    clears the sensor's open face by 0.30. The model uses the 1321 body (`under_pcb` `sens.body_x` 5.1).

## Stack (centre)
- **Fixed centre:** a brass 5×3 stock tube on the dial axis, knurled at the dial end. A printed square flange
  is bonded to the PCB. An M1.6 rod with a sleeve and nuts down the middle is the **centre bolt**: it clamps the
  stack (adapter board → tube → PCB).
- **Rod VBUS pad (v0.16):** the bottom nut clamps straight onto an enlarged B.Cu pad, Ø11.48 sized from the
  clearances in the model. There is no washer. In KiCad (main PCB v0.11, H1 B.Cu ring).
- **Dial-centre link:** one PTFE wire down the tube carries power and data (single-wire, LIN/1-Wire style),
  with the brass tube as the ground return. A CH32V003 on the adapter board behind the centre screen splits
  them. No slip ring, no wireless.
- **Adapter cup removed (v0.16):** the centre bolt clamps the adapter board directly. The board doubles as the
  dial's up-stop with 0.3 mm of free lift. The 45° ball race carries the knob's up-load into the dial. The race
  and hub did not move.

## Knob size (v0.16)
- The knob grows only as much as it has to: it must clear the AMOLED FPC/COF bend and leave a printable lip wall
  of **0.8 mm (2 × 0.4 nozzle lines)** all round.
  - Minimum Ø40.841, rounded up to **Ø40.85**.
  - The bottom ring goes 73T → **75T**.
- The screen sits 0.515 mm off-centre to balance the walls.
  - Lip wall: 0.805 far side, 0.805 outside the bend pocket, 1.84 near side.
  - The lip is a **closed ring**. The bend sits in a blind pocket that is open to the top.

## Screen carrier cartridge (v0.16)
- The centre screen and carrier lift out as one cartridge.
- Location: a Ø1 locating pin at 270°.
- Hold-down: a Ø2×1 N52 magnet in the dial at 90° (r 15) pulls on a Ø2×0.5 steel disc in the carrier.
- Removal: a suction cup.
- v0.16b: with the dial TMAG5273 gone, the nearest 3D sensor is H3 on the PCB, about 50 mm away. The stray field
  there is 0.004 mT, which is negligible.

## Control dial: Hall arm, detents, centring (v0.16)
- **Travel:** ±5°, latching. Overtravel of 0.5° runs onto magnet cushions, so the hard stop is at ±5.5°.
- **Hall vernier:** the arm comes straight off the dial hub through a wide cradle window.
  - 5 magnets (N/S/N/S/N) over 4 TMAG5253 + 1 TMAG5273A2 (middle, H3) on the PCB at **2.5 mm pitch**, r 6.6–16.6.
  - Peak field 45.7 mT against ±80 mT at the TMAG5253s; 83.6 mT against ±133 mT at the TMAG5273A2 (v0.16b).
- **Fan:** the arm widens into a sector toward the perimeter (r 13.85–17.25, ±38°). This spreads the detents.
- **Detents:** two top-loaded spring-ball detents at ±26.8° from the arm (r 15.55). Each is a Ø1.5 ball,
  a 1.4×3 spring (0.8 preload) and an M2×2 grub screw (±0.6 adjustment). They sit in bosses bridged over the fan
  and latch into dimples in the arm at 0 / ±5°.
- **Ball track:** Ø1 balls (2 per detent) in grooves in both the cradle plate and the underside of the arm.
  They take the detent press-down load.
- **Centring:** two tangential **non-magnetic extension springs** on a lever at 276°, on the side away from the
  Hall window, hooked to posts on the cradle. The old Ø10 centring magnet is gone.
- **Cushions:** 3 × Ø1.5×0.5 N52 magnets, set to repel, give a soft end before the flush hard stop. Stray field
  at the nearest Hall sensor is ≤ 1.67 mT (2.1% of range).

## Relative knob-vs-dial sensor (v0.16, REMOVED in v0.16b)
- A diametric N52 ring magnet, Ø21/Ø19×0.5 (0.24 g), sits flush in the underside of the **main knob** web.
- A TMAG5273 3D Hall sensor faces down on a 4×6×0.6 board that **turns with the control dial**. The board sits
  in a generous pocket through the dial web at r 10 so it is easy to assemble.
- The sensor reads the relative angle of the knob against the dial.
  - At the nominal 1.50 mm element gap the field is 34 mT (42% of ±80 mT).
  - With the dial lifted to its stop (1.20 mm gap) it is 48 mT (60%).
- The board needs its signals carried over the screen service strap. The screen-adapter board no longer
  carries U3.

## Check status (v0.16b)
- 54/54 gap checks PASS (the two dial-TMAG5273 rows are replaced by the TMAG5273 air-gap and field rows).
- The contract check passes.
- No known clashes: the PCB / motor proxy clash (4.24 mm³) is gone now that the proxy carries the KiCad M1 Ø3.2 relief
  (`electronics/kicad/knob-main-pcb/pcb_proxy.json`). `build.py` and `build.py --full` both give 54/54 PASS.

## Open items
- **KiCad (1 Nov 2026):** main PCB v0.11 and screen adapter v0.4 match v0.16b (Hall row, rod pad, 716 lead pads +
  DRV8837, joystick J2/holes/slot/keep-out; U3 removed from the adapter). Main PCB v0.11 is **READY TO QUOTE**: U2 is
  now the EE-SX1321 (LCSC C469128) and J2 the FG FG-PM2.54-2-03P-H8.5 (LCSC C42391433); routed, ERC 0 / DRC 0, every
  BOM line has an LCSC part. Still open: the MCU section (J10 is a placeholder test-pad field with an assumed pin-out),
  the 1220 driver, and the adapter's display-tail wiring / VCC regulator (adapter is placed, not routed).
- TMAG5273 Hall-element height (0.65 above the PCB) is assumed. Check it against the TI drawing.
- The ±5.5° travel was an interface change (from ±10°) and needs confirming.
- Inside the closed lip, about 0.9 mm of the bend pocket shows at −X.
- Spring sourcing: the detent springs and the extension springs must be non-magnetic (stainless 316 or
  phosphor bronze).
- Motor depth and the final feel come from tests with the real motors.

## Top-screen joystick v0.1 (1 Nov 2026)
See `docs/top-screen-joystick.md` and `cad/joystick-param/`. The carrier centre is board (25.25, 21.1) and knob frame (0, 31.8).
The carrier slid toward the knob clears the knob OD (Ø40.85) by 0.675. The main PCB v0.11 carries the J2 socket (FG FG-PM2.54-2-03P-H8.5),
the spring/pin holes, the FPC slot and the base keep-out (listed in that doc).
