EdgerEquals/knob-hardware/cad/base-cradle/base-cradle-v0.5/base-cradle-drawing.png

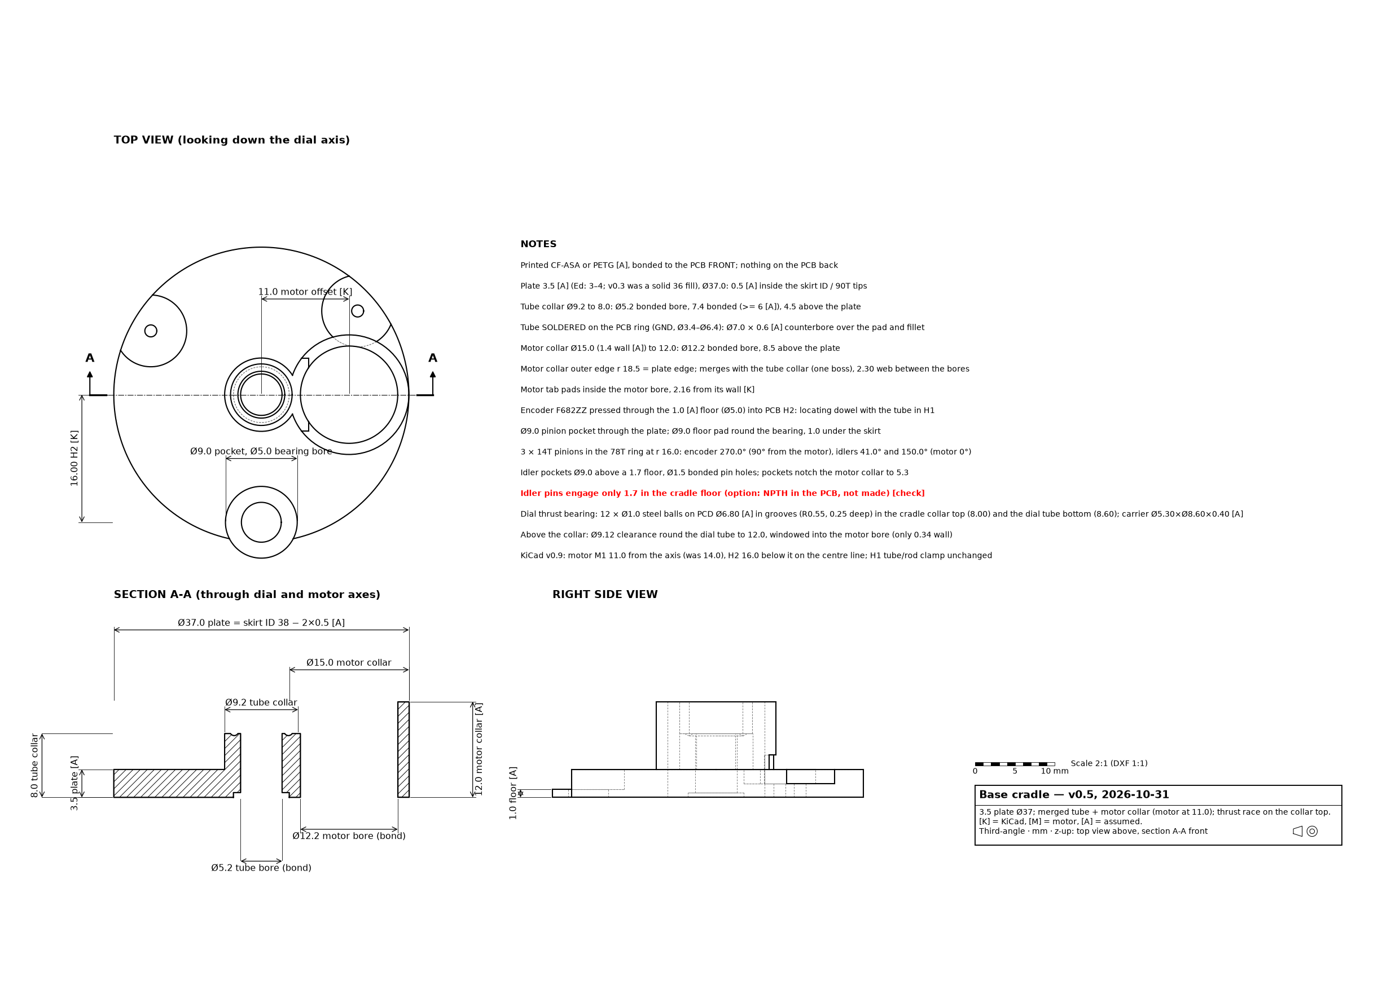
cad/base-cradle/base-cradle-v0.5/base-cradle-drawing.png
