EdgerEquals/knob-hardware/cad/bearings/dial-thrust-v0.1/thrust-carrier-with-balls-drawing.png

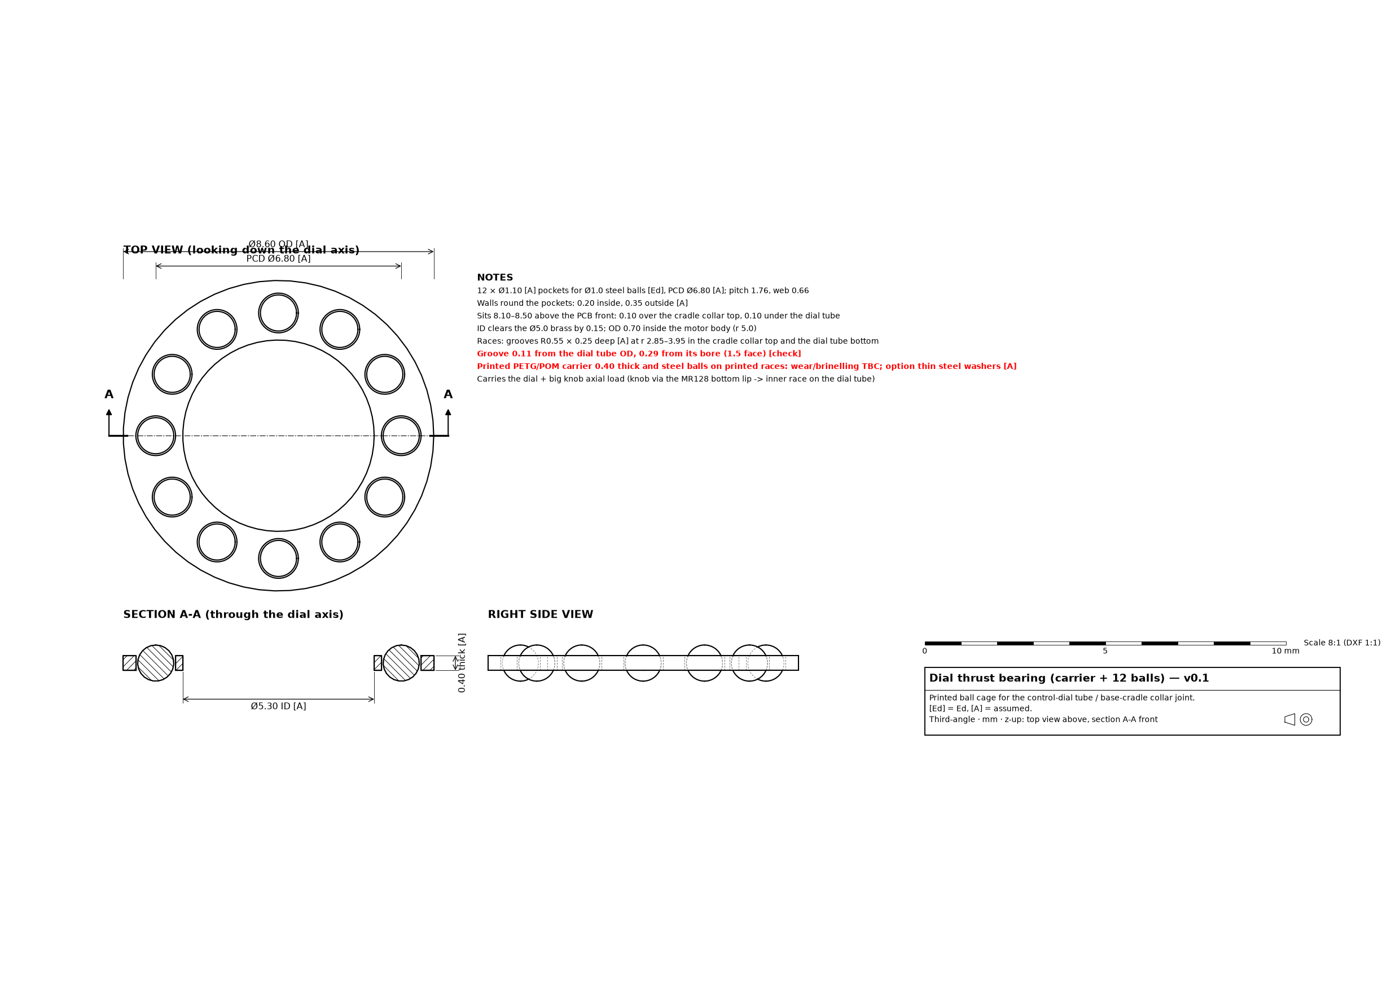
cad/bearings/dial-thrust-v0.1/thrust-carrier-with-balls-drawing.png
