EdgerEquals/knob-hardware/cad/control-dial/control-dial-v0.6/control-dial-drawing.png

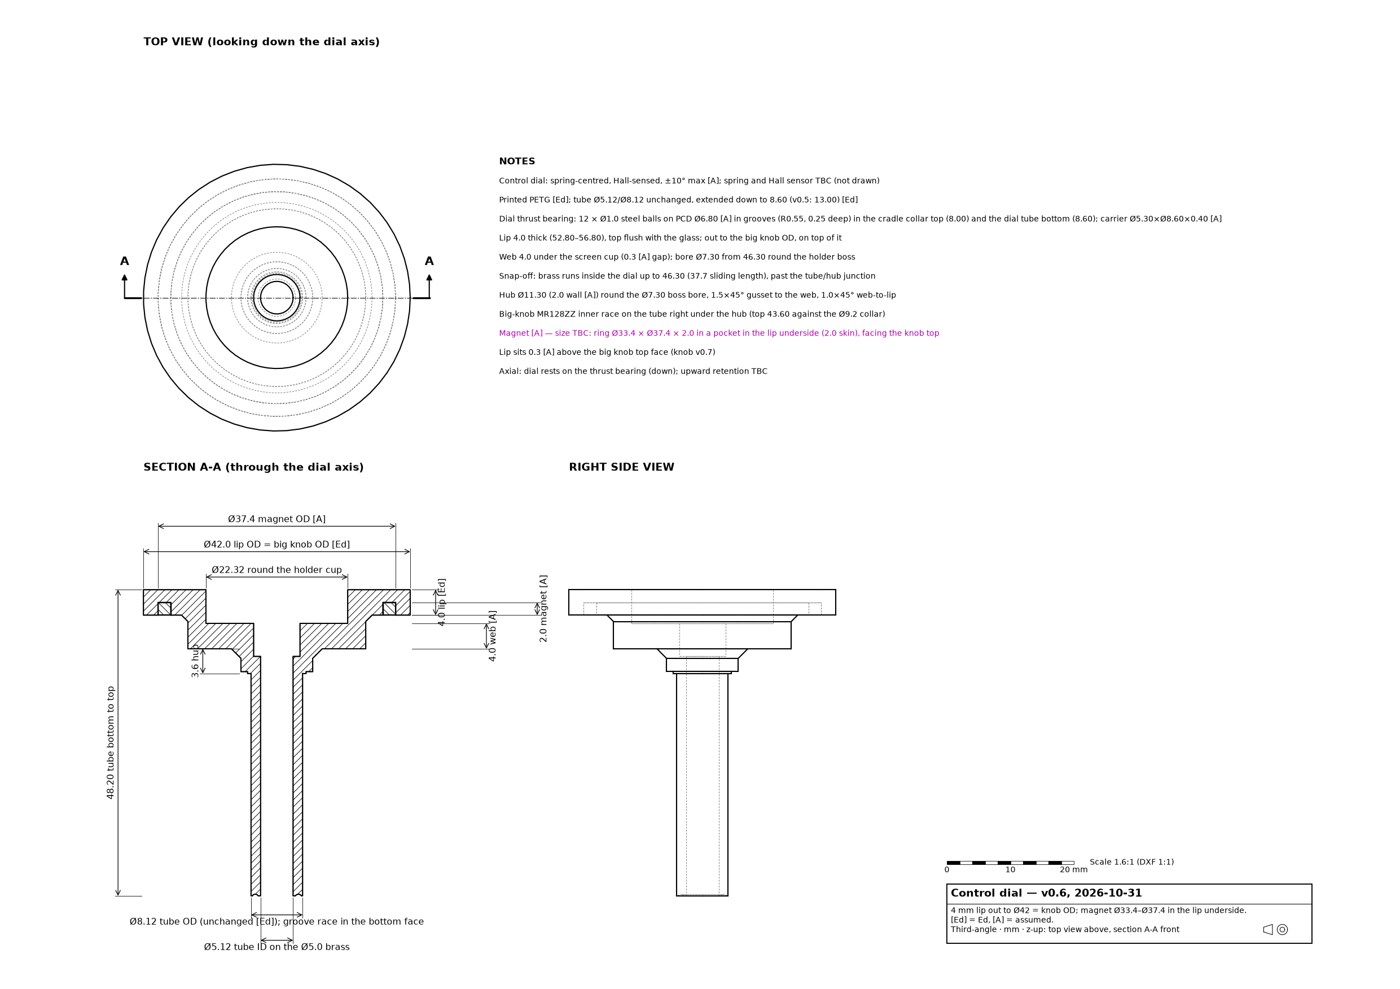
cad/control-dial/control-dial-v0.6/control-dial-drawing.png
