EdgerEquals/knob-hardware/cad/displays/tft-0.71-round-gc9d01/tft-0.71-round-gc9d01-drawing.png

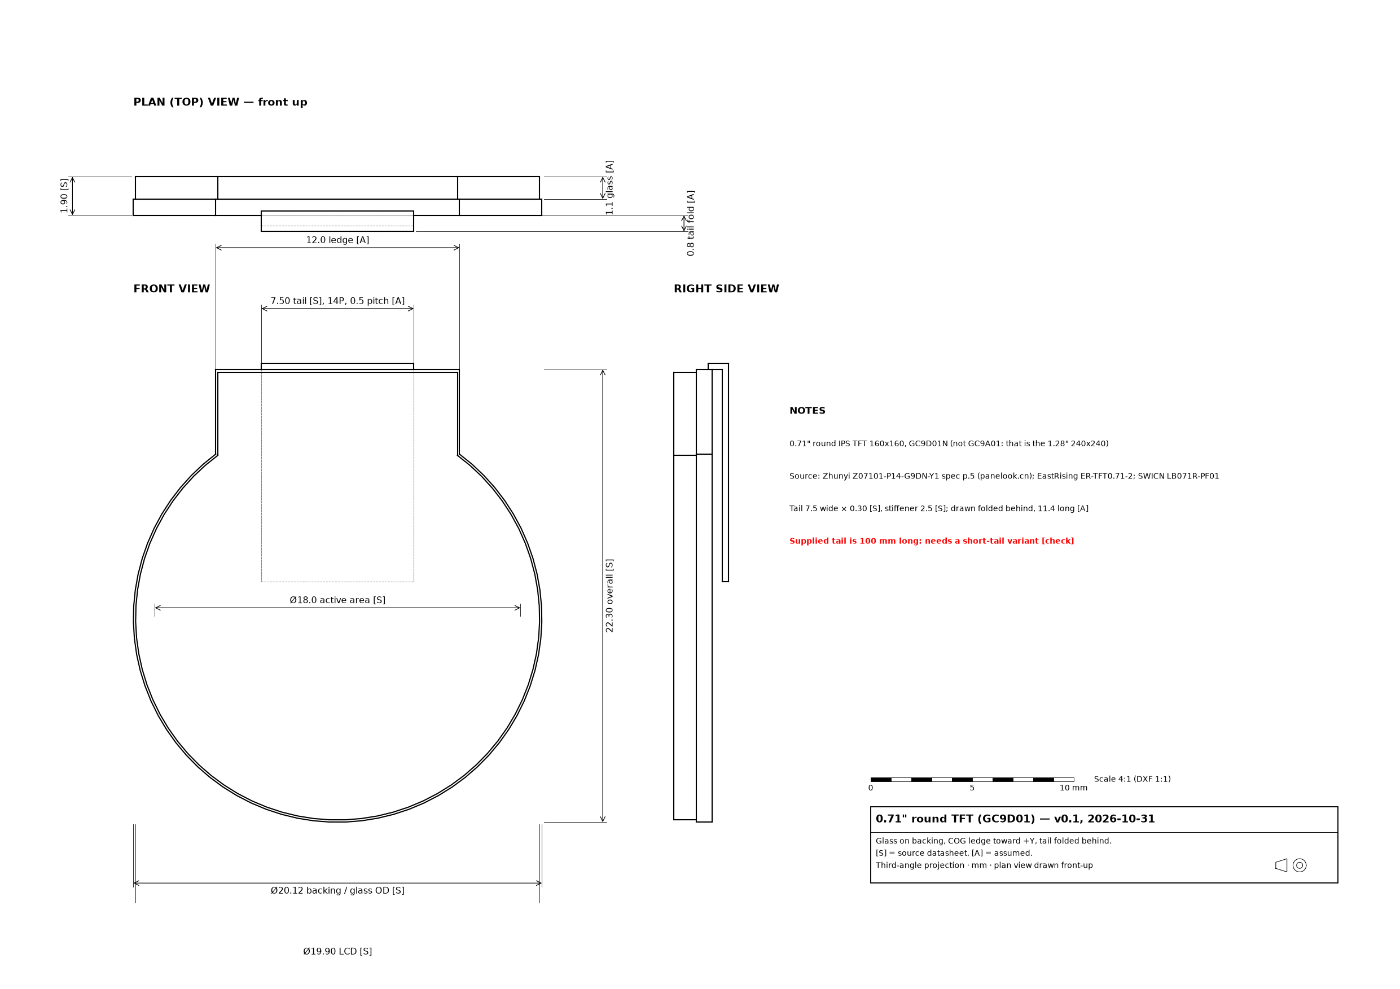
cad/displays/tft-0.71-round-gc9d01/tft-0.71-round-gc9d01-drawing.png
