EdgerEquals/knob-hardware/cad/encoder-takeoff/encoder-takeoff-v0.5/encoder-big-gear-slotted-rim-drawing.png

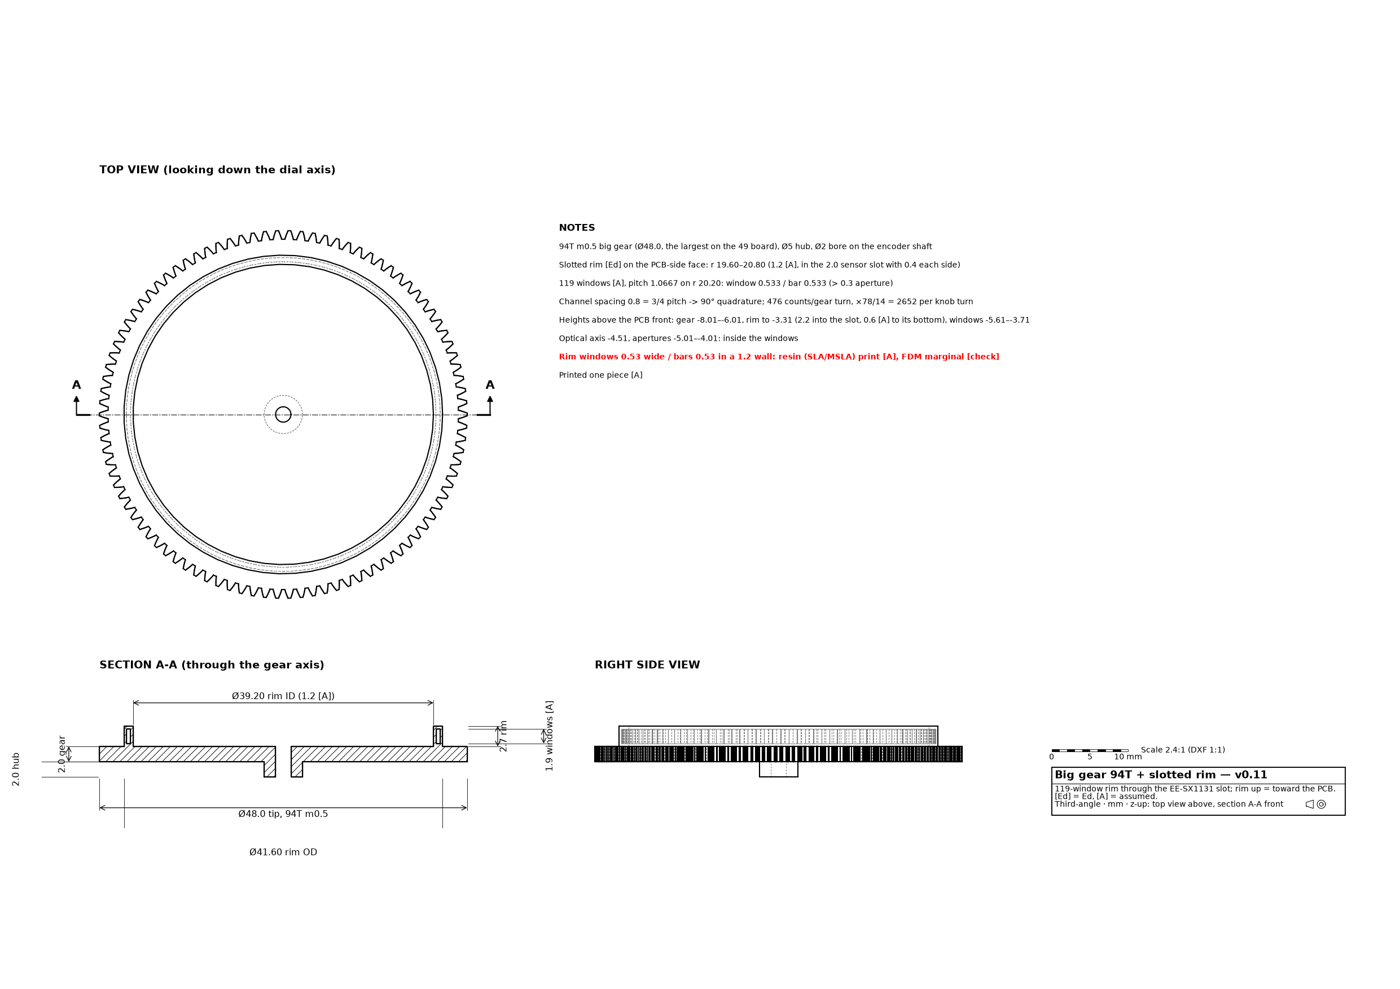
cad/encoder-takeoff/encoder-takeoff-v0.5/encoder-big-gear-slotted-rim-drawing.png
