EdgerEquals/knob-hardware/cad/encoder-takeoff/encoder-takeoff-v0.5/encoder-sensor-ee-sx1131-drawing.png

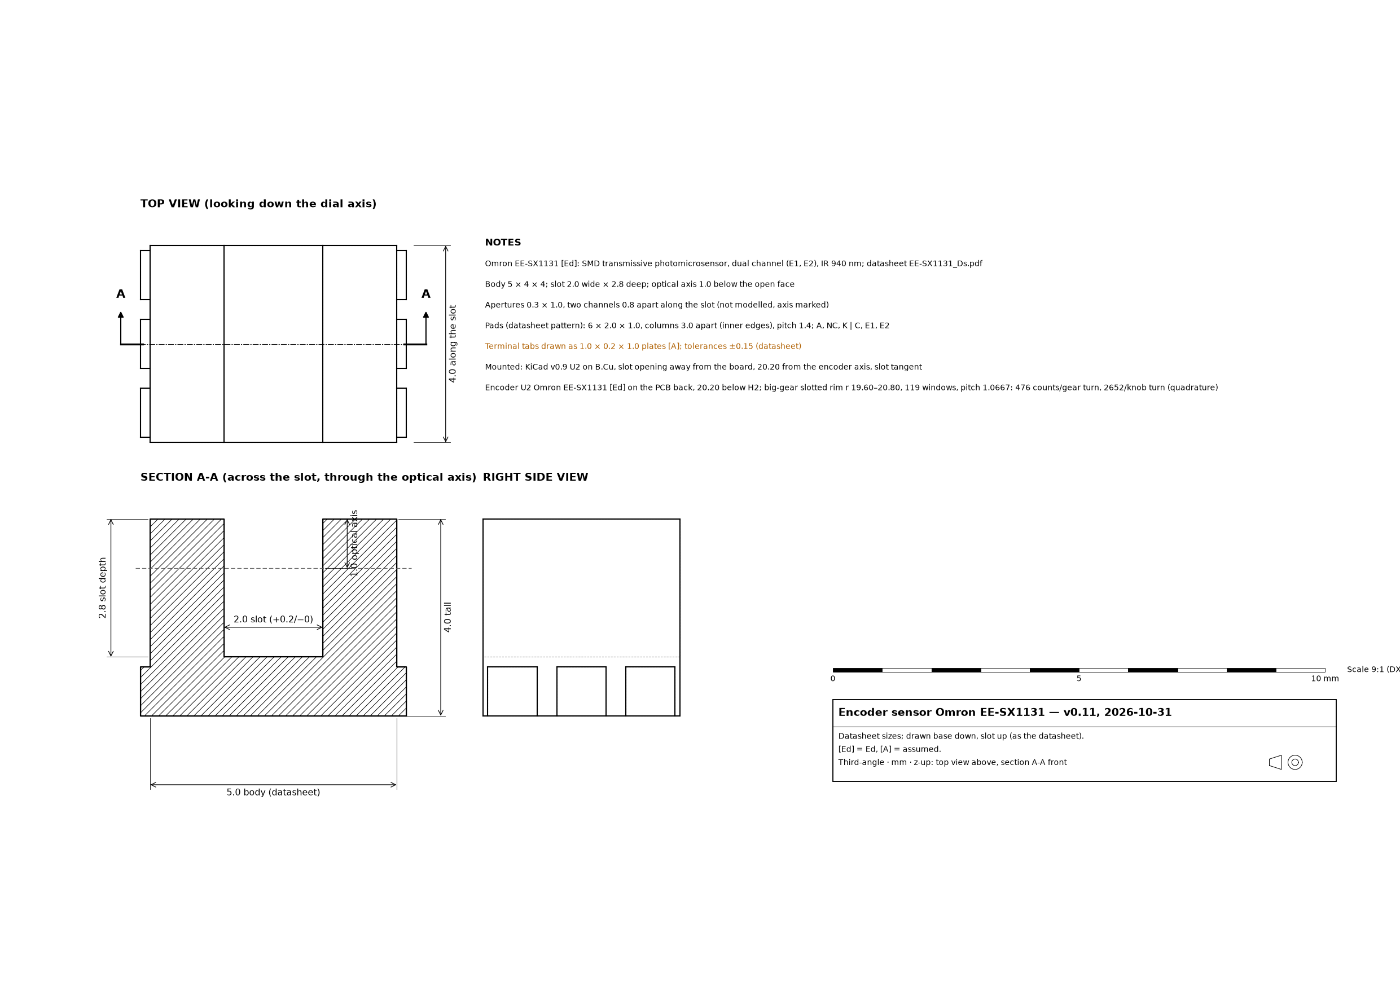
cad/encoder-takeoff/encoder-takeoff-v0.5/encoder-sensor-ee-sx1131-drawing.png
