EdgerEquals/knob-hardware/cad/encoder-takeoff/encoder-takeoff-v0.5/encoder-takeoff-together-drawing.png

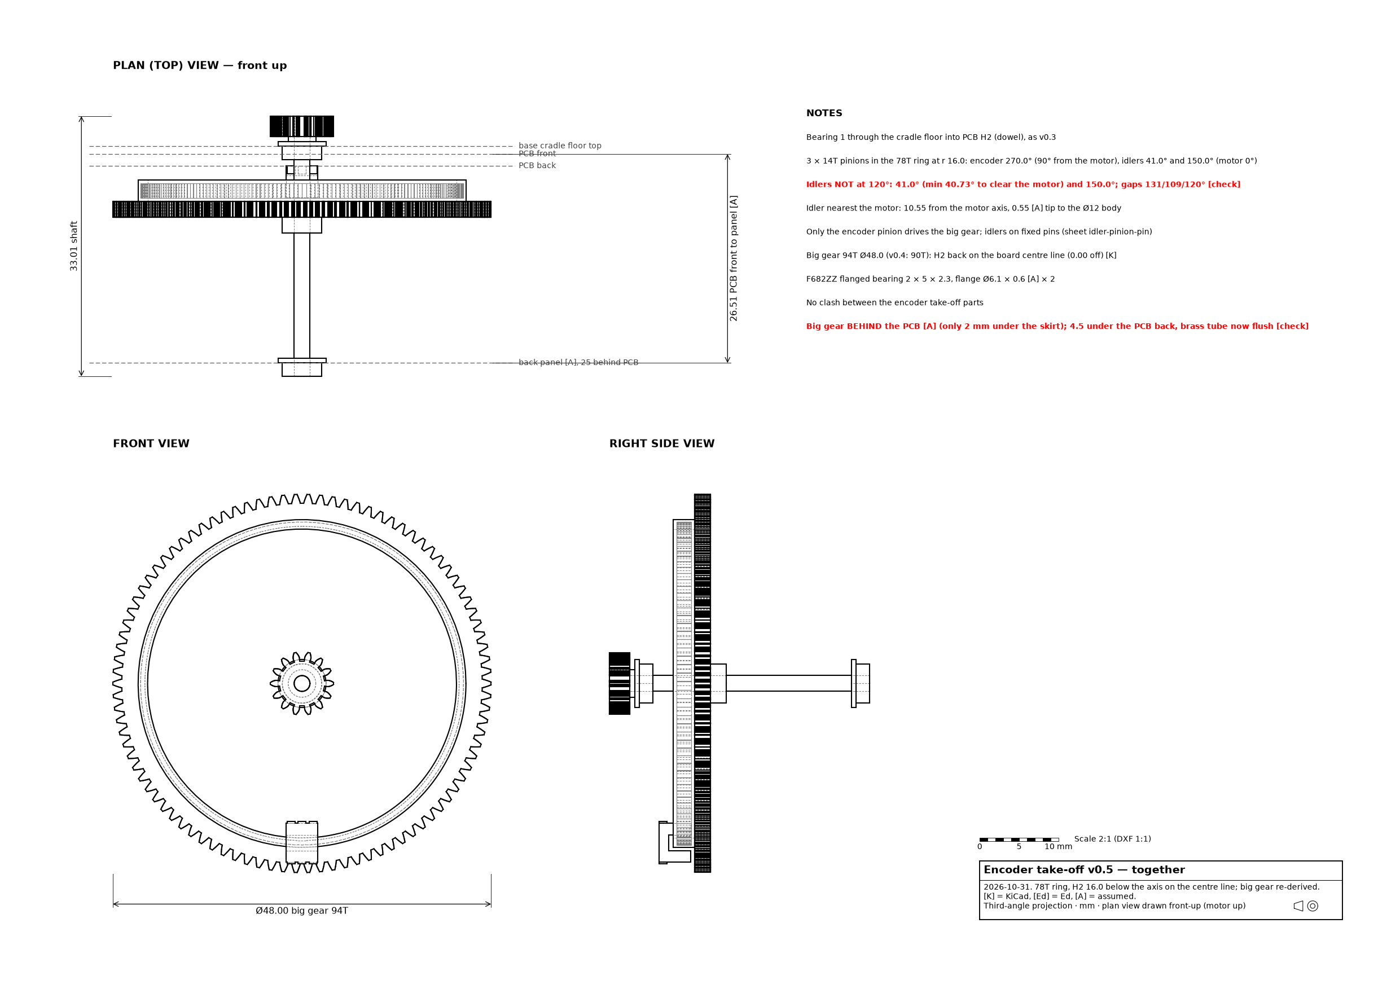
cad/encoder-takeoff/encoder-takeoff-v0.5/encoder-takeoff-together-drawing.png
