EdgerEquals/knob-hardware/cad/encoder-takeoff/encoder-takeoff-v0.5/idler-pinion-pin-drawing.png

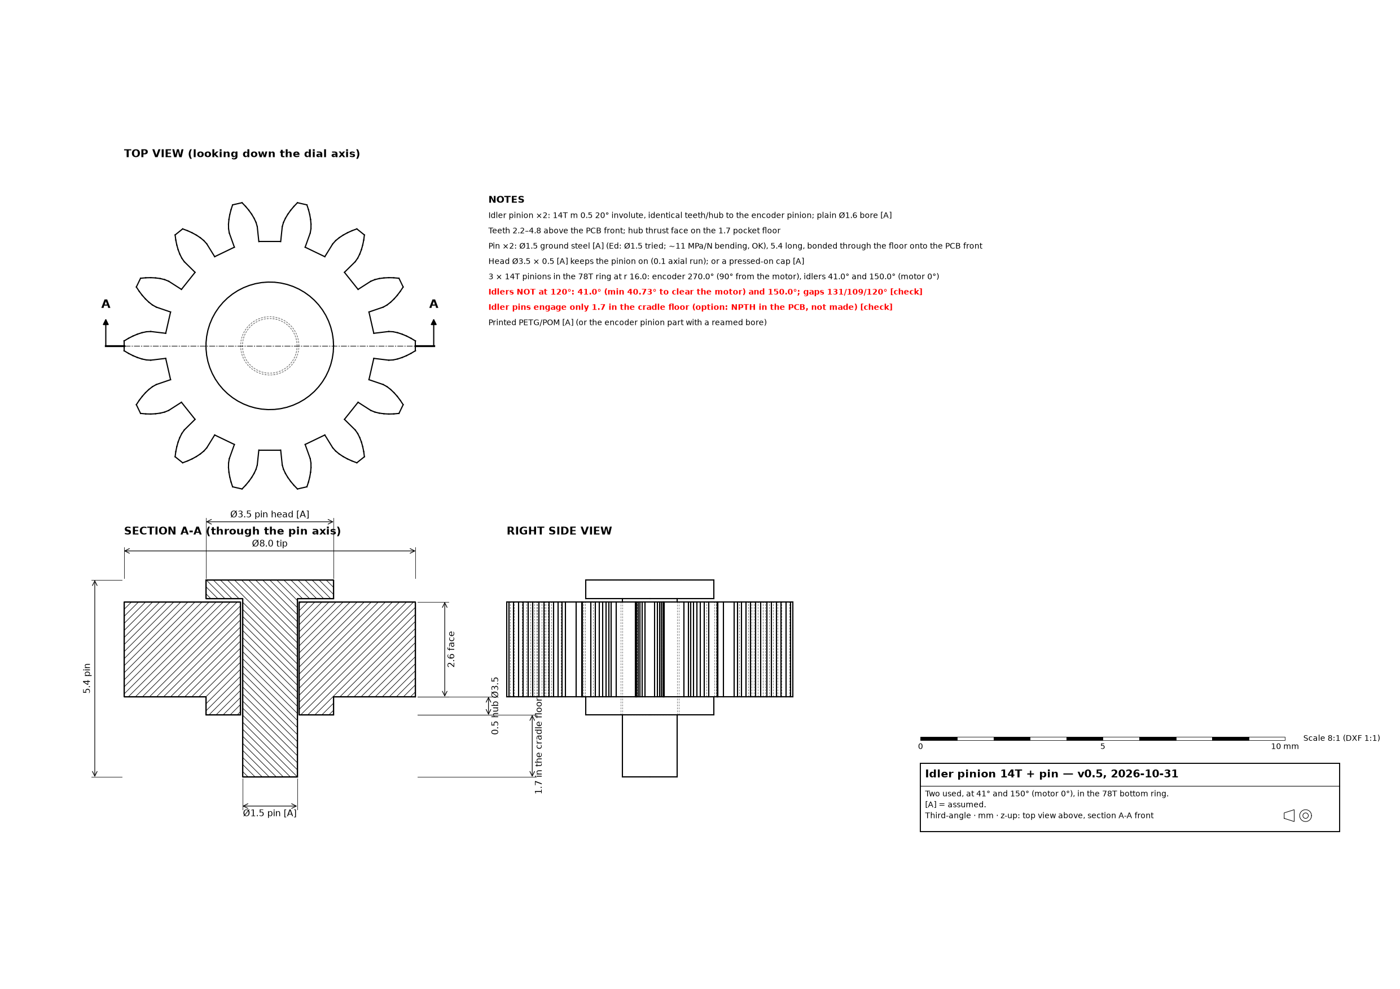
cad/encoder-takeoff/encoder-takeoff-v0.5/idler-pinion-pin-drawing.png
