EdgerEquals/knob-hardware/cad/holders/screen-holder-v0.4/screen-holder-drawing.png

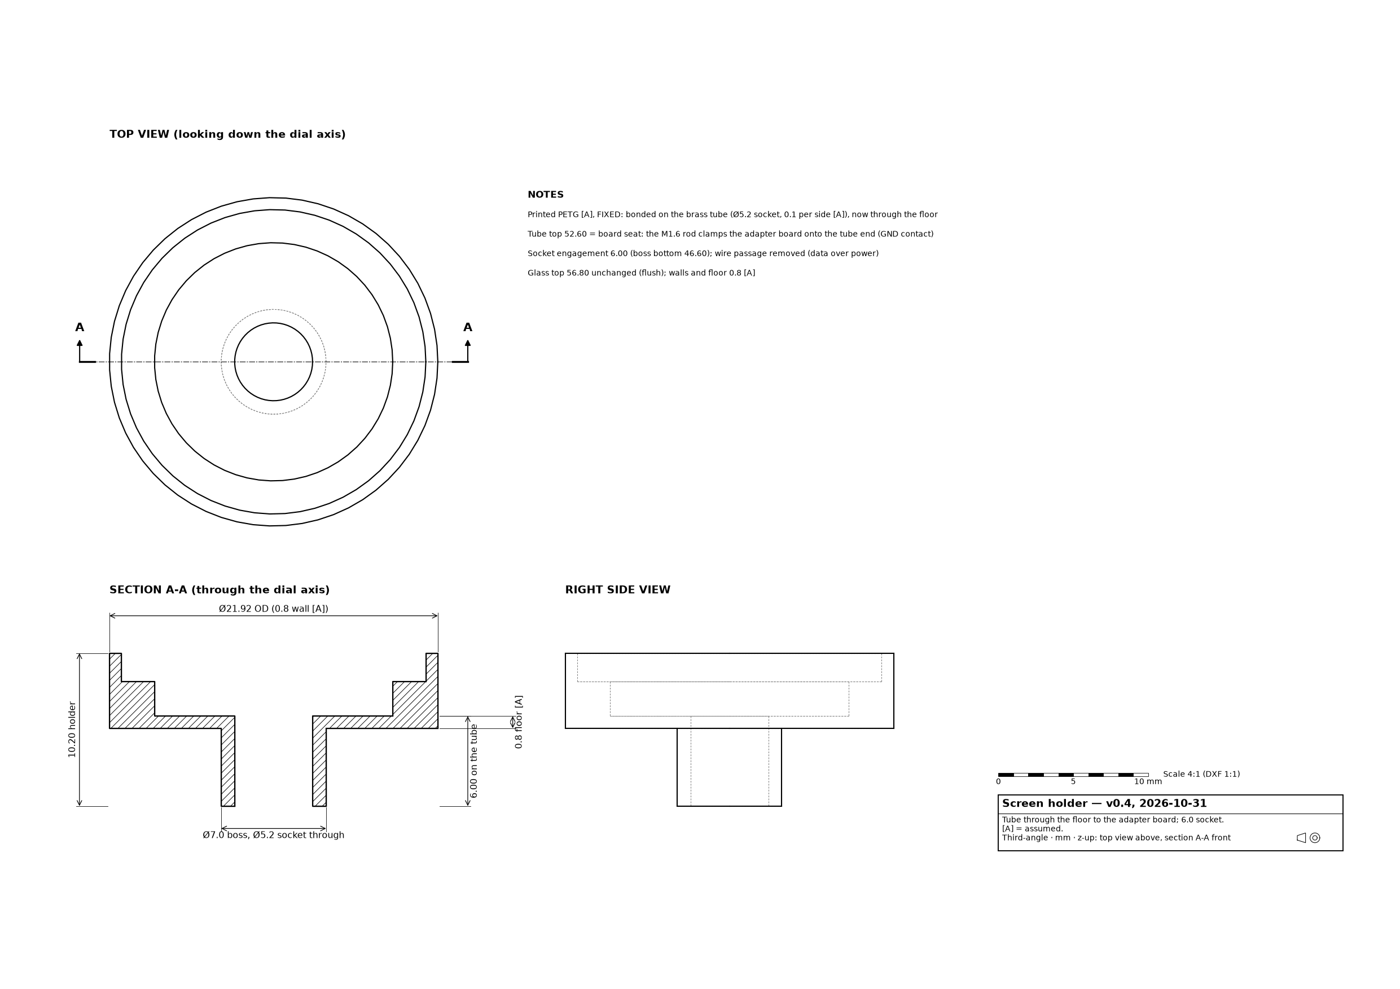
cad/holders/screen-holder-v0.4/screen-holder-drawing.png
