EdgerEquals/knob-hardware/cad/knob-param/knobparam/electronics/kicad/knob-main-pcb/knob-main-pcb-drawing.png

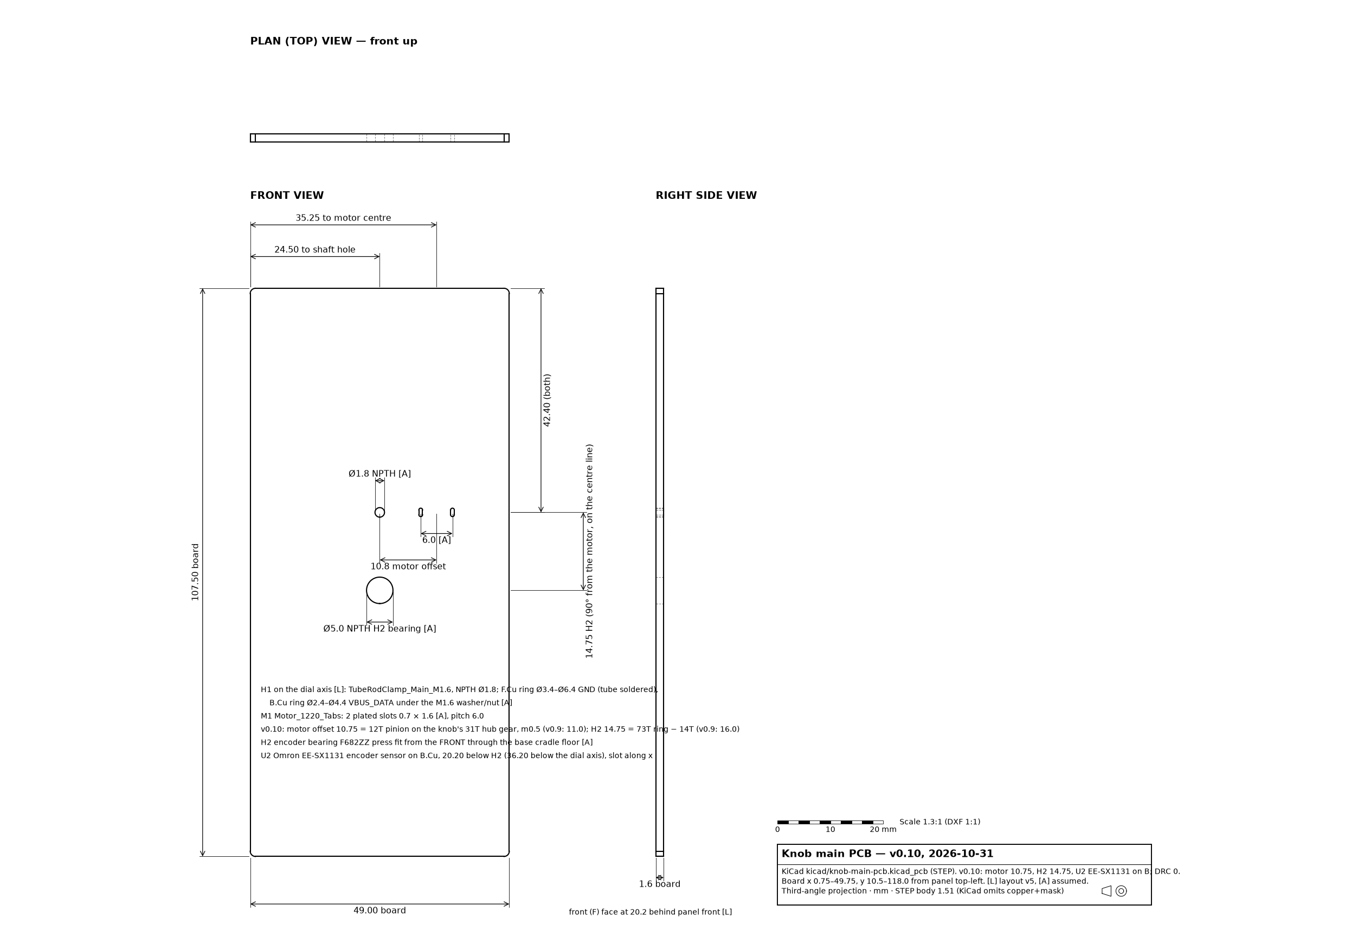
cad/knob-param/knobparam/electronics/kicad/knob-main-pcb/knob-main-pcb-drawing.png
