EdgerEquals/knob-hardware/cad/knob-param/knobparam/electronics/kicad/screen-adapter/screen-adapter-drawing.png

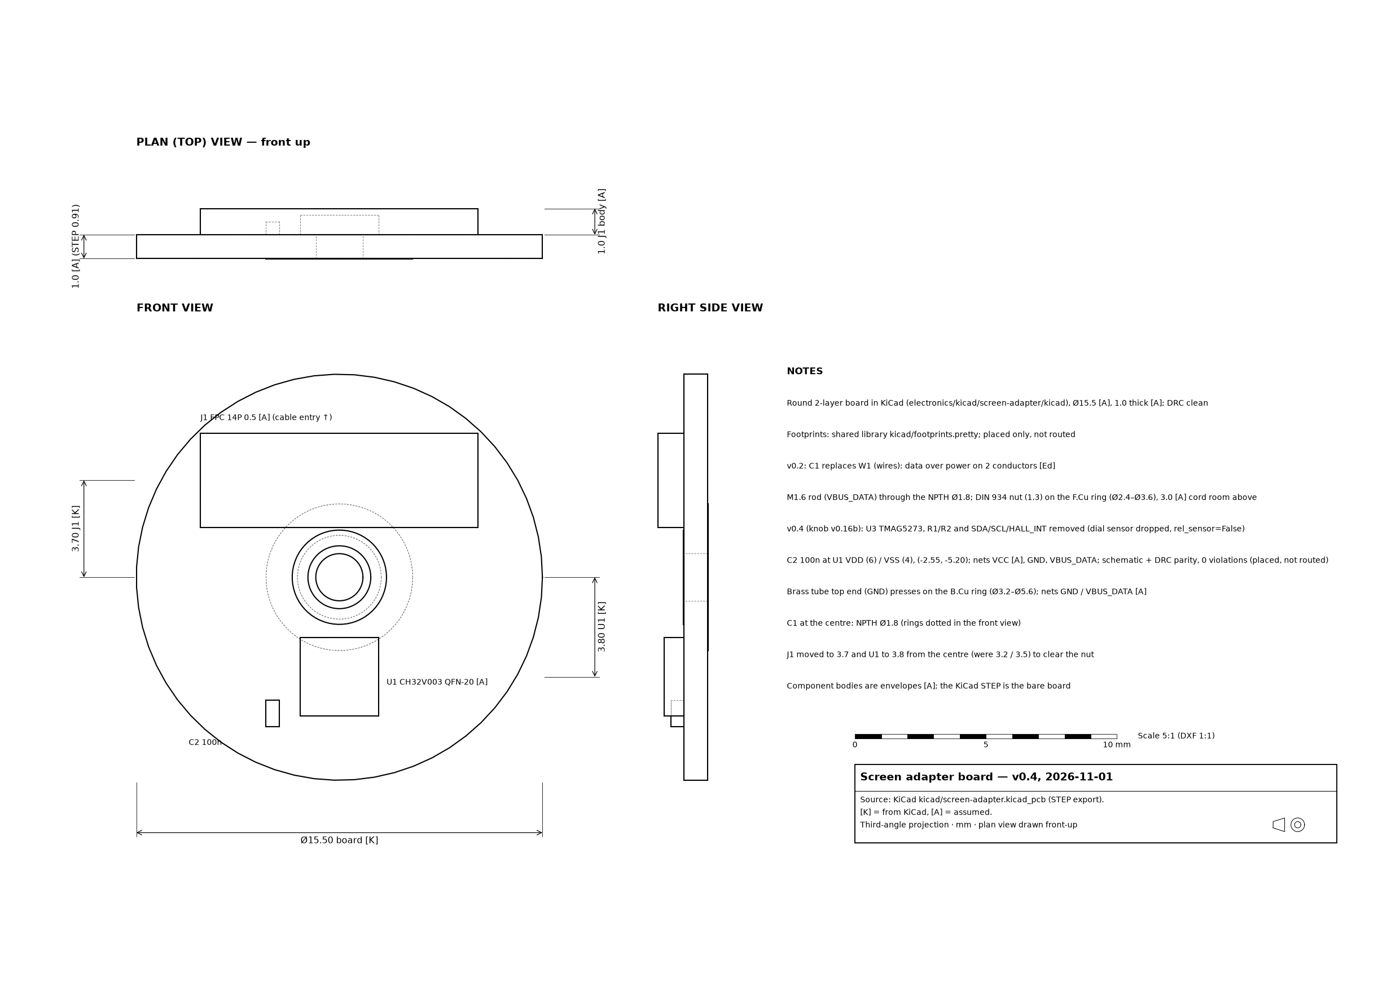
cad/knob-param/knobparam/electronics/kicad/screen-adapter/screen-adapter-drawing.png
