EdgerEquals/knob-hardware/cad/knob/knob-v0.7/knob-body-drawing.png

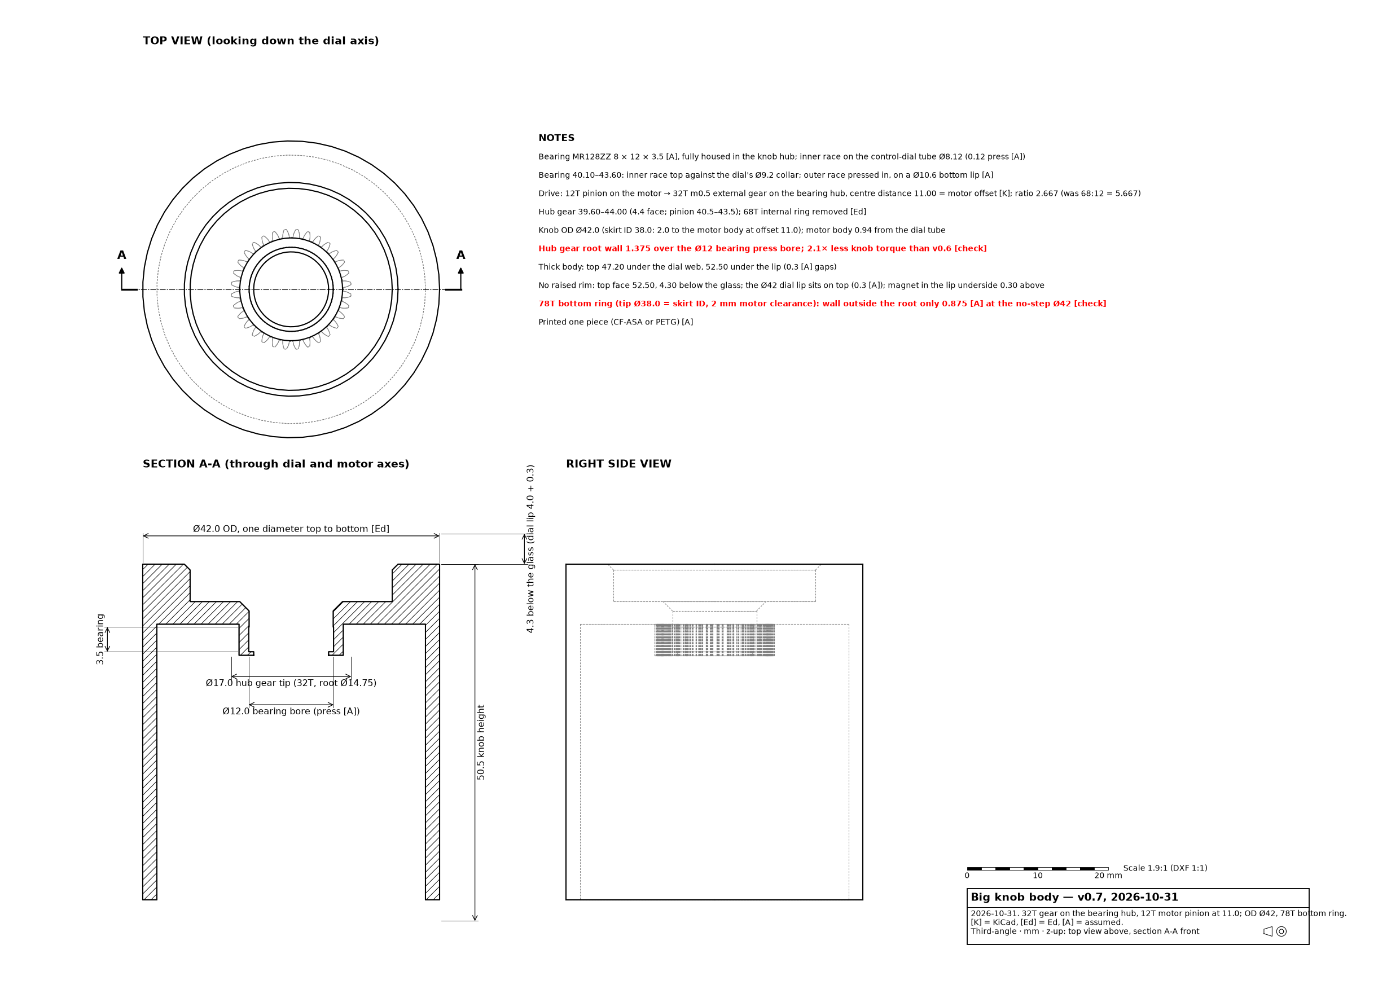
cad/knob/knob-v0.7/knob-body-drawing.png
