EdgerEquals/knob-hardware/cad/knob/knob-v0.7/knob-v0.7-together-drawing.png

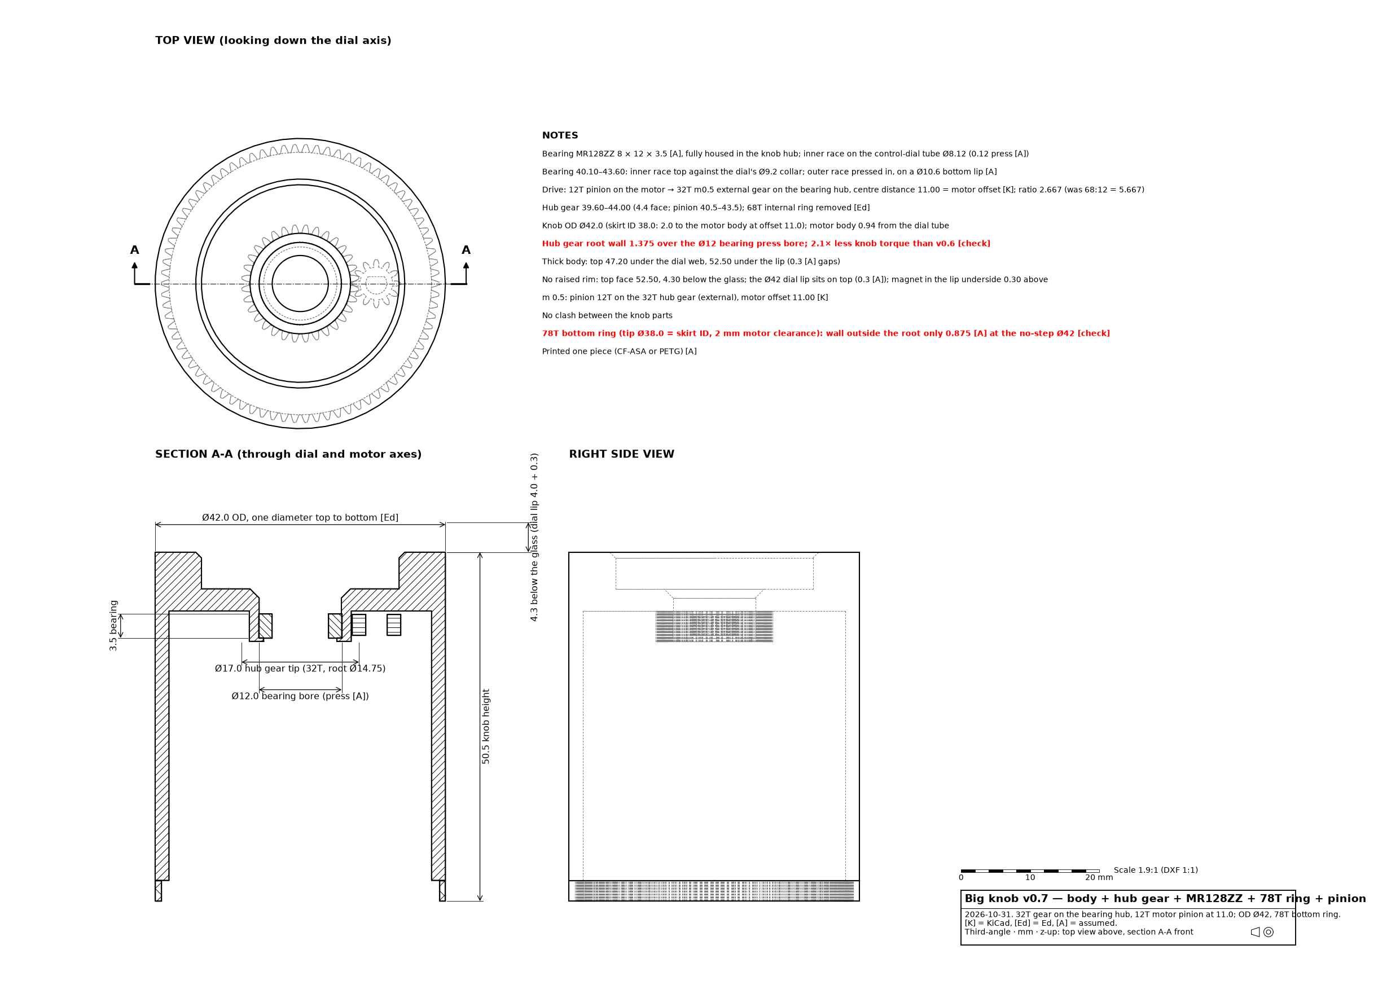
cad/knob/knob-v0.7/knob-v0.7-together-drawing.png
