EdgerEquals/knob-hardware/cad/motors/1220-coreless-planetary/motor-1220-drawing.png

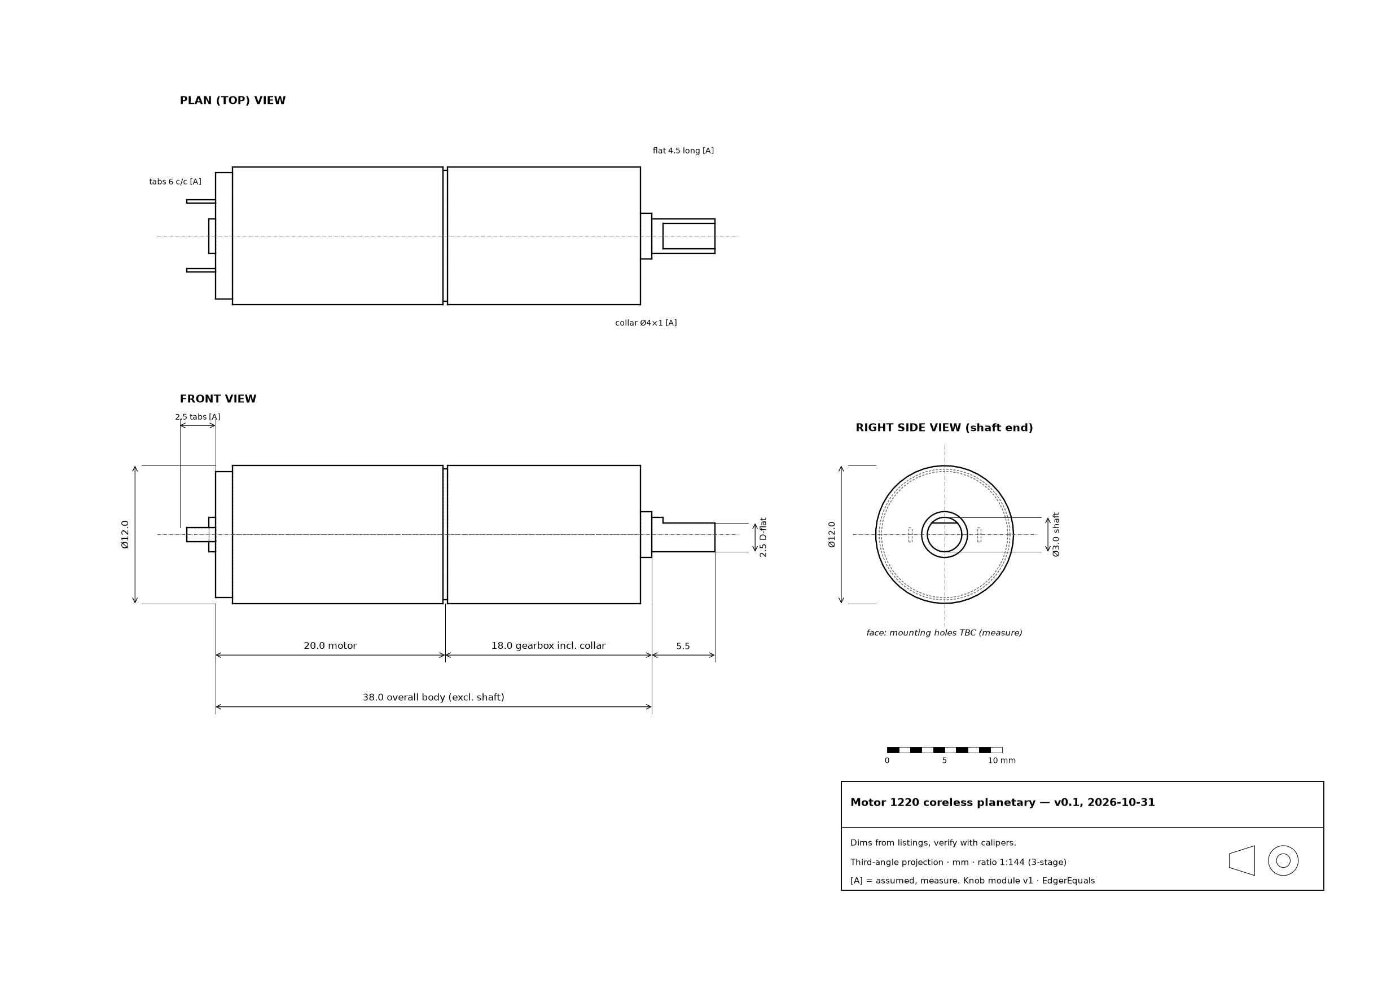
cad/motors/1220-coreless-planetary/motor-1220-drawing.png
