EdgerEquals/knob-hardware/cad/shafts/fixed-hollow-shaft-4mm-onepiece/fixed-hollow-shaft-4mm-onepiece-drawing.png

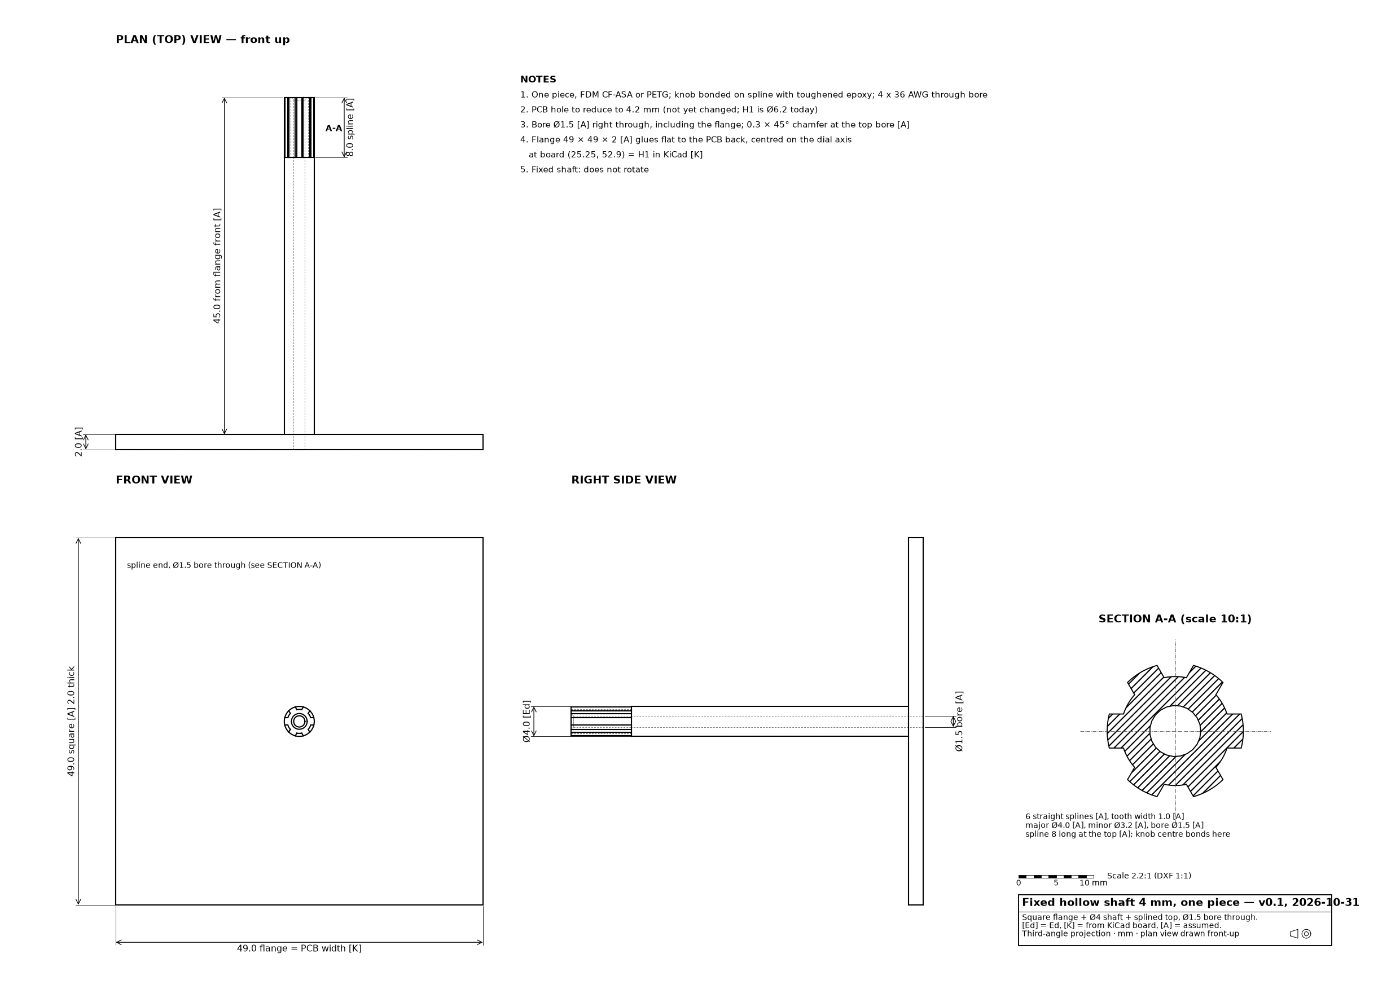
cad/shafts/fixed-hollow-shaft-4mm-onepiece/fixed-hollow-shaft-4mm-onepiece-drawing.png
