EdgerEquals/knob-hardware/cad/shafts/fixed-hollow-shaft-4mm/fixed-hollow-shaft-4mm-drawing.png

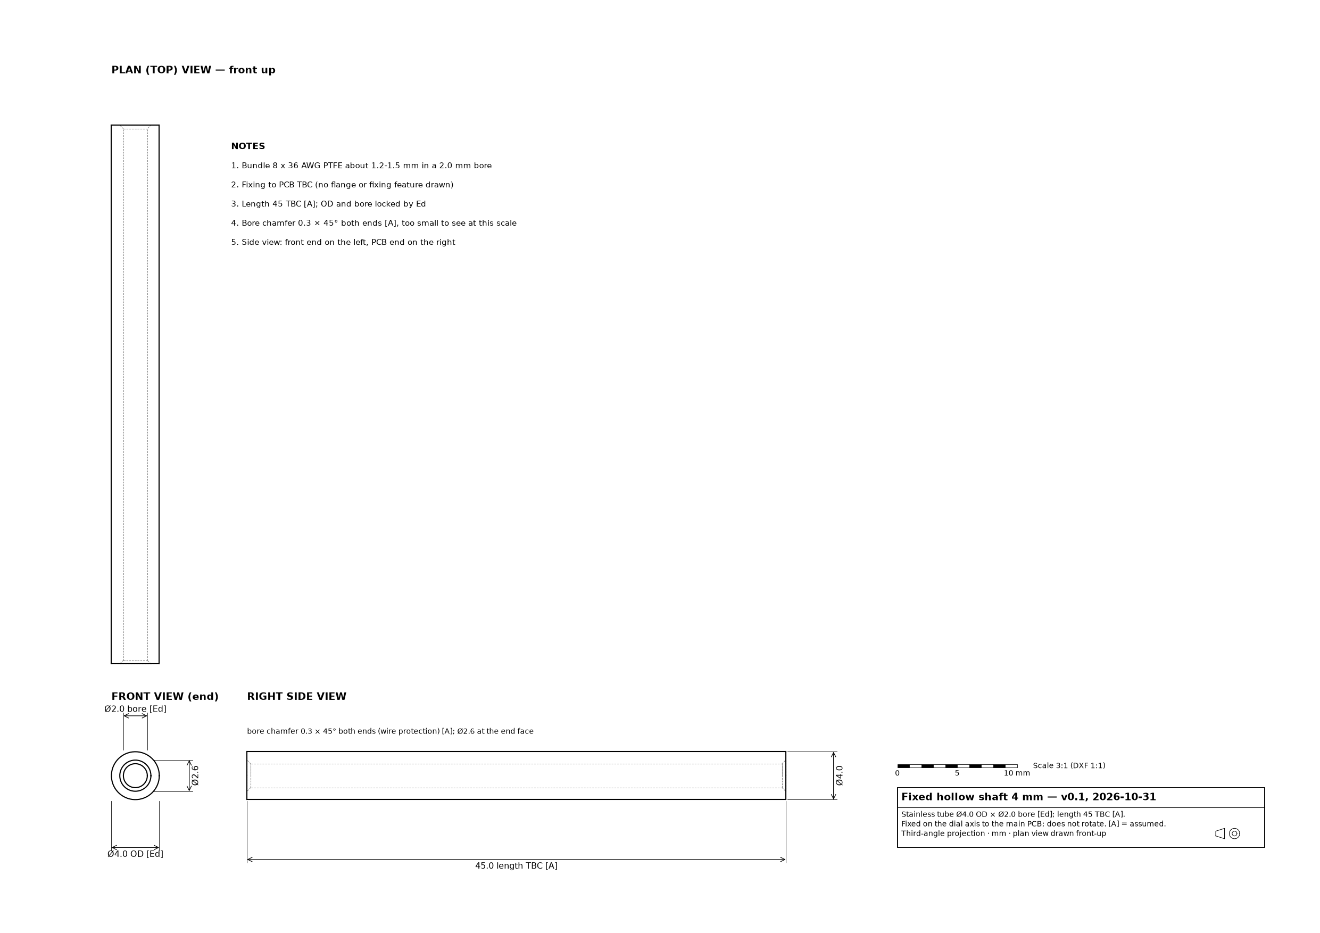
cad/shafts/fixed-hollow-shaft-4mm/fixed-hollow-shaft-4mm-drawing.png
