EdgerEquals/knob-hardware/cad/shafts/fixed-hollow-shaft-6mm/shaft-base-drawing.png

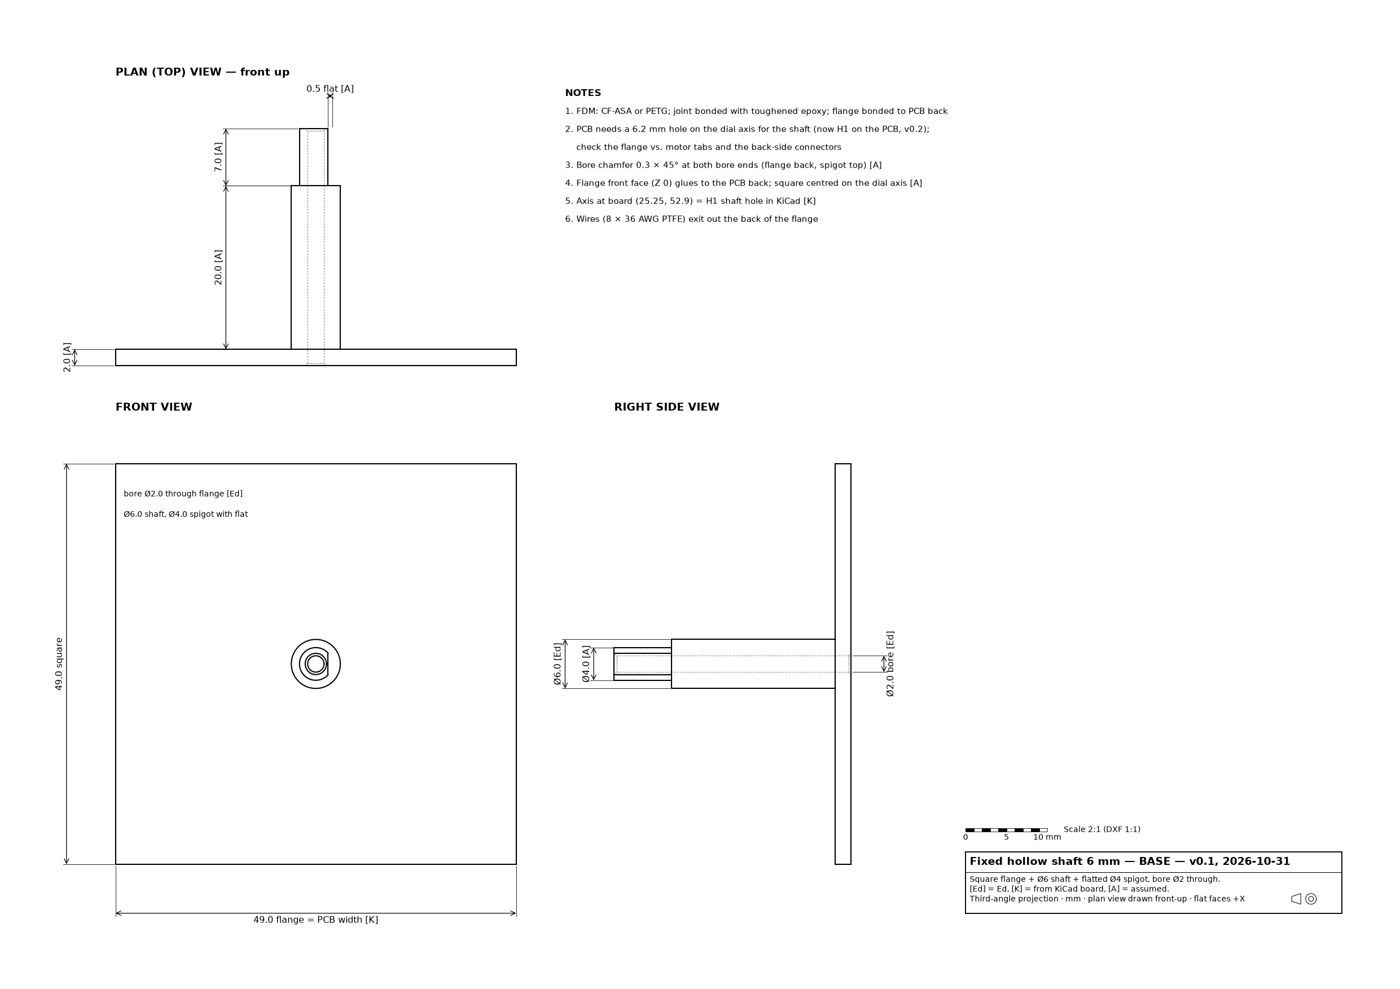
cad/shafts/fixed-hollow-shaft-6mm/shaft-base-drawing.png
