EdgerEquals/knob-hardware/cad/shafts/fixed-hollow-shaft-6mm/shaft-top-drawing.png

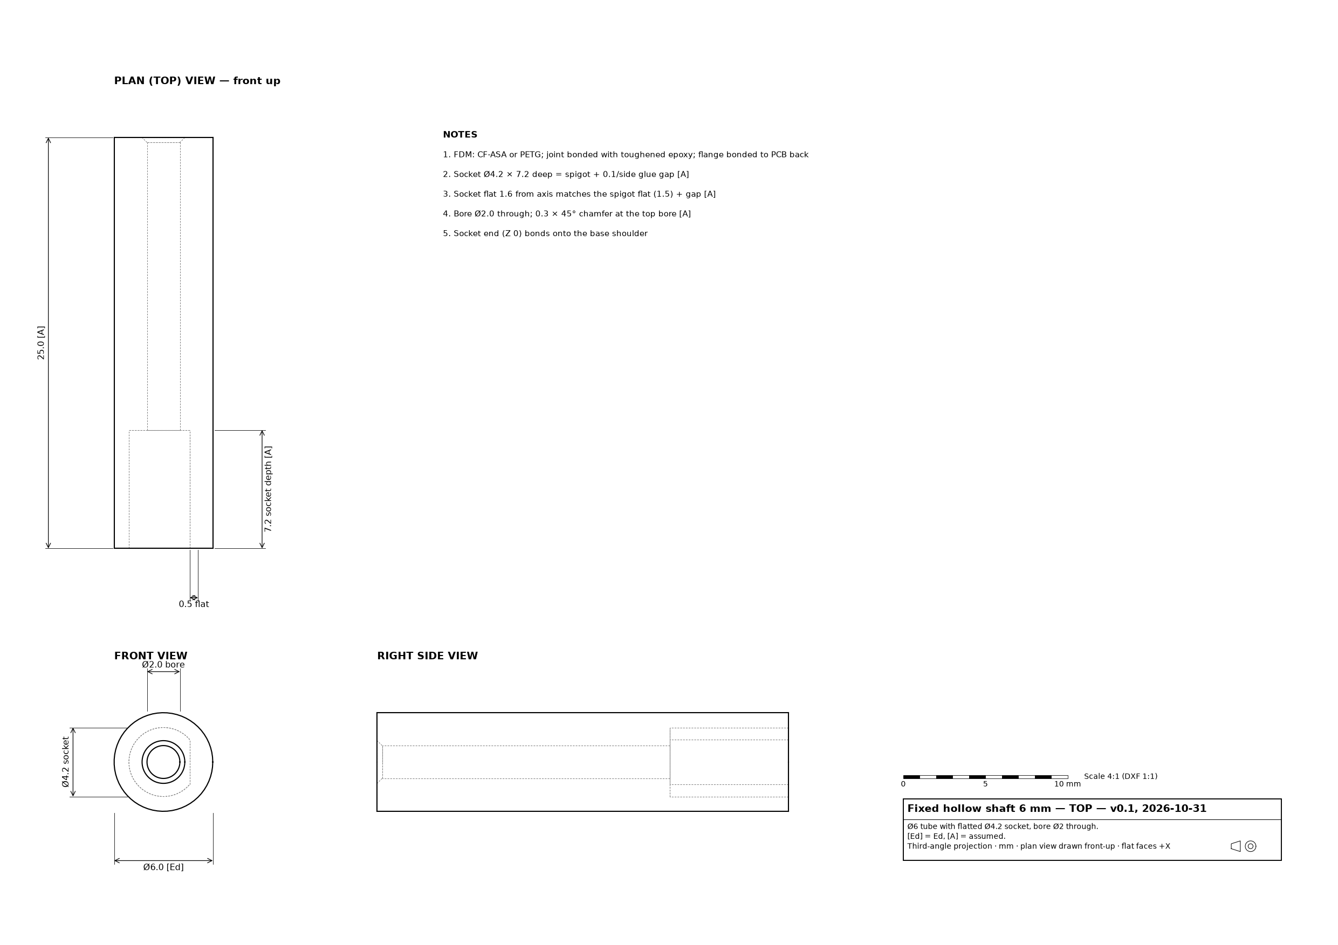
cad/shafts/fixed-hollow-shaft-6mm/shaft-top-drawing.png
