EdgerEquals/knob-hardware/cad/shafts/fixed-shaft-brass-5x3-v0.4/brass-tube-5x3-drawing.png

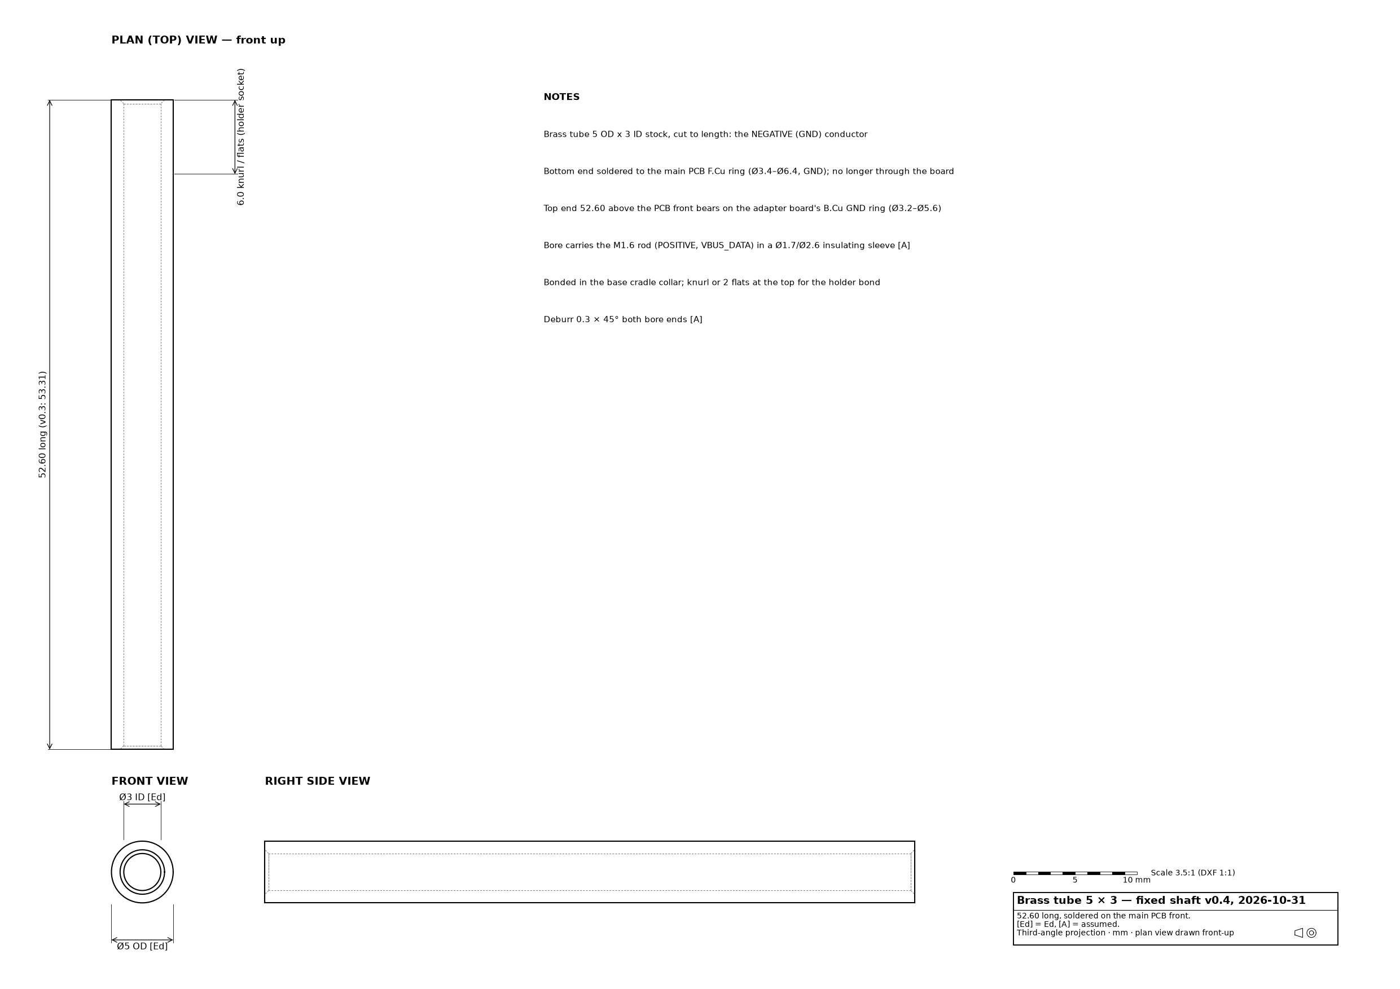
cad/shafts/fixed-shaft-brass-5x3-v0.4/brass-tube-5x3-drawing.png
