EdgerEquals/knob-hardware/cad/shafts/rod-m1.6-v0.1/rod-m1.6-hardware-drawing.png

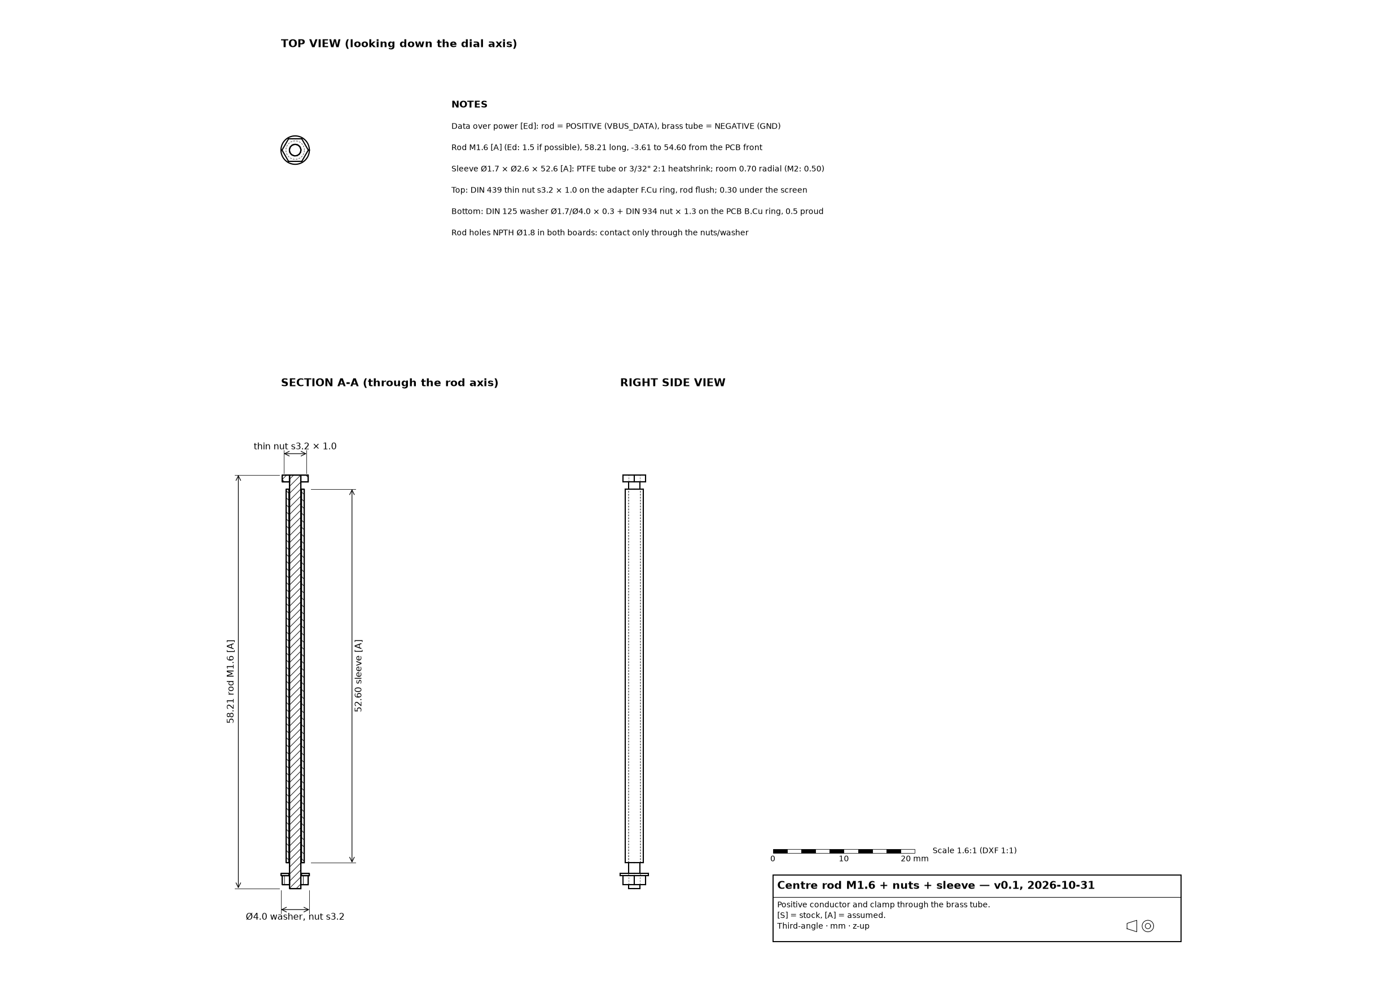
cad/shafts/rod-m1.6-v0.1/rod-m1.6-hardware-drawing.png
