EdgerEquals/knob-hardware/cad/knob-param/knobparam/electronics/kicad/knob-main-pcb/fab/knob-main-pcb-v0.11-bom.csv

Item | Designator | Qty | Value | Footprint | Manufacturer | MPN | LCSC
1 | C11,C12,C13,C14,C15,C20,C21 | 7 | 100n | C_0402 | Samsung | CL05B104KO5NNNC | C1525
2 | C22 | 1 | 10u | C_0603 | Samsung | CL10A106KP8NNNC | C19702
3 | J2 | 1 | 2x3 2.54 female socket 8.5 mm | PinSocket_2x03_P2.54_Vertical_8.5mm | FG (Shenzhen Fugang) | FG-PM2.54-2-03P-H8.5 | C42391433
4 | R20,R21 | 2 | 4k7 | R_0402 | UNI-ROYAL | 0402WGF4701TCE | C25900
5 | R22,R31,R32 | 3 | 10k | R_0402 | YAGEO | RC0402FR-0710KL | C60490
6 | R30 | 1 | 220R | R_0402 | UNI-ROYAL | 0402WGF2200TCE | C25091
7 | U2 | 1 | EE-SX1321 | Omron_EE-SX1321 | Omron | EE-SX1321 | C469128
8 | U11,U12,U14,U15 | 4 | TMAG5253BA3IQDMRR | X2SON-4_TMAG5253 | TI | TMAG5253BA3IQDMRR | C22401868
9 | U13 | 1 | TMAG5273A2QDBVR | SOT-23-6_TMAG5273_Tight | TI | TMAG5273A2QDBVR | C3715882
10 | U20 | 1 | DRV8837DSGR | WSON-8_2x2_DRV8837 | TI | DRV8837DSGR | C39159
