EdgerEquals/knob-hardware/cad/knob-param/knobparam/electronics/kicad/screen-adapter/fab/screen-adapter-v0.4-bom.csv

Item | Designator | Qty | Value | Footprint | Manufacturer | MPN | LCSC
1 | C2 | 1 | 100n | C_0402 | Samsung | CL05B104KO5NNNC | C1525
2 | J1 | 1 | Z07101-P14 (FPC 14P 0.5) | FPC_14P_0.5mm_Top | Zhunyi | Z07101-P14
3 | U1 | 1 | CH32V003F4U6 | QFN-20_3x3_P0.4_CH32V003 | WCH | CH32V003F4U6 | C5299908
