EdgerEquals/knob-hardware/cad/knob-param/knobparam/electronics/kicad/knob-main-pcb/knob-main-pcb.step

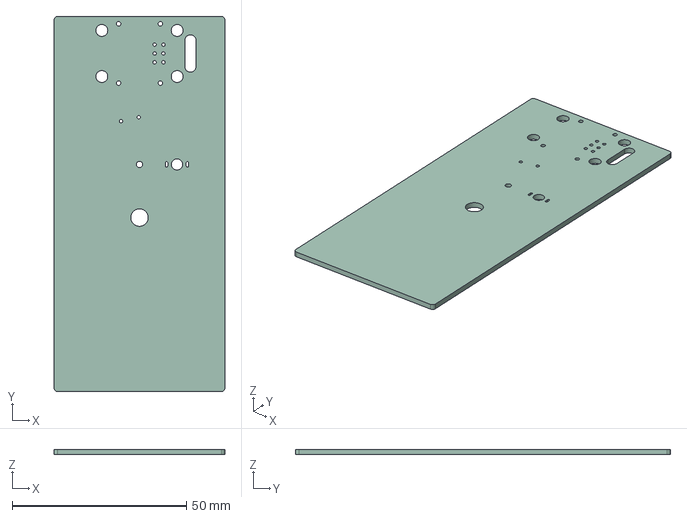
[picture p22: CAD file, 2026-11-01]
cad/knob-param/knobparam/electronics/kicad/knob-main-pcb/knob-main-pcb.step
49.0 x 107.5 x 1.51 mm
