EdgerEquals/knob-hardware/cad/shafts/fixed-hollow-shaft-6mm/shaft-6mm-assembled.step

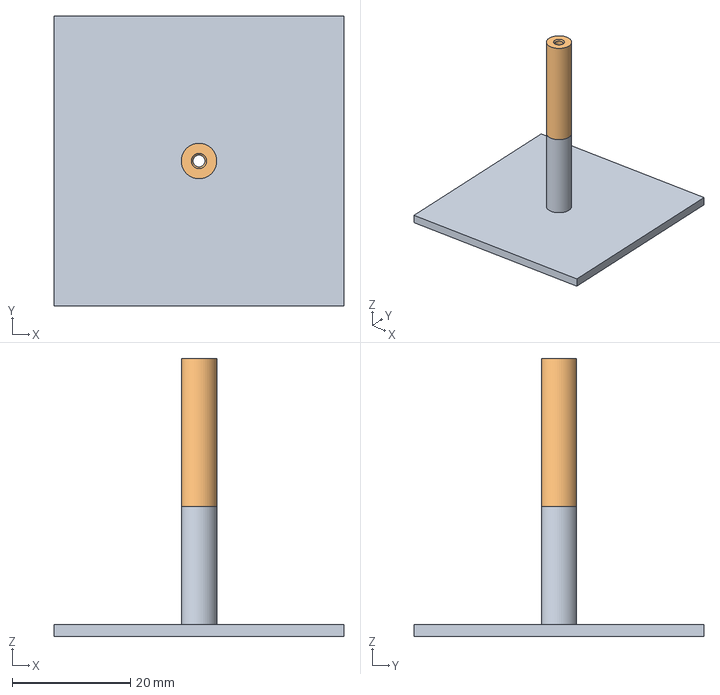
[picture p23: CAD file, 2026-10-31]
cad/shafts/fixed-hollow-shaft-6mm/shaft-6mm-assembled.step
49.0 x 49.0 x 47.0 mm
