EdgerEquals/knob-hardware/cad/base-cradle/base-cradle-v0.5/base-cradle.step

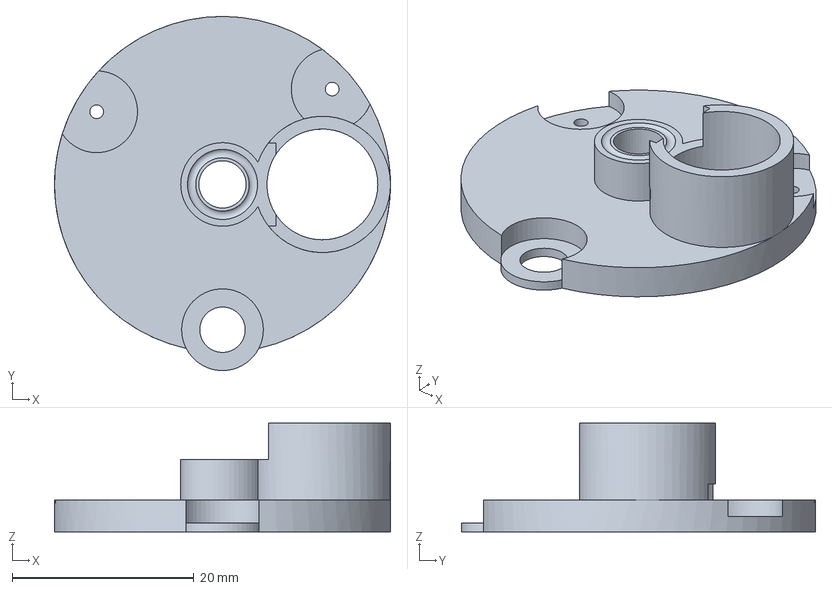
[picture p24: CAD file, 2026-10-31]
cad/base-cradle/base-cradle-v0.5/base-cradle.step
37.0 x 39.0 x 12.0 mm
