EdgerEquals/knob-hardware/cad/bearings/dial-thrust-v0.1/thrust-carrier.step

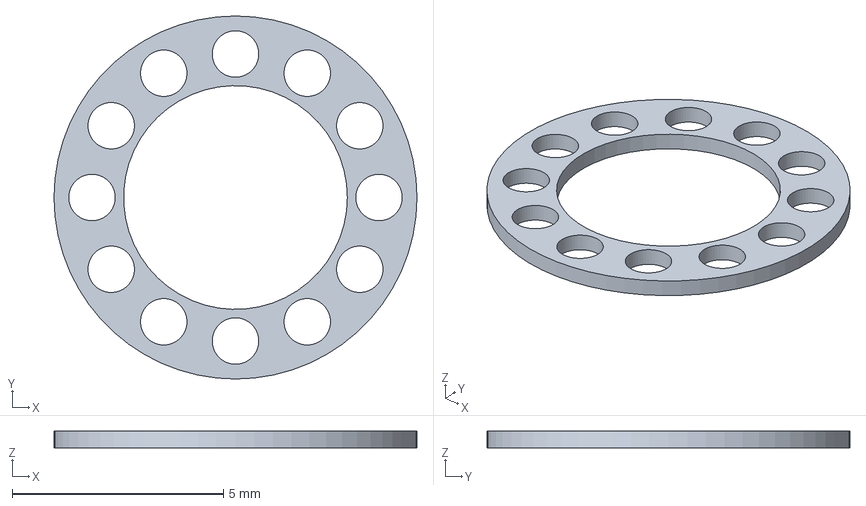
[picture p25: CAD file, 2026-10-31]
cad/bearings/dial-thrust-v0.1/thrust-carrier.step
8.60 x 8.60 x 0.4 mm
