EdgerEquals/knob-hardware/cad/control-dial/control-dial-v0.6/control-dial.step

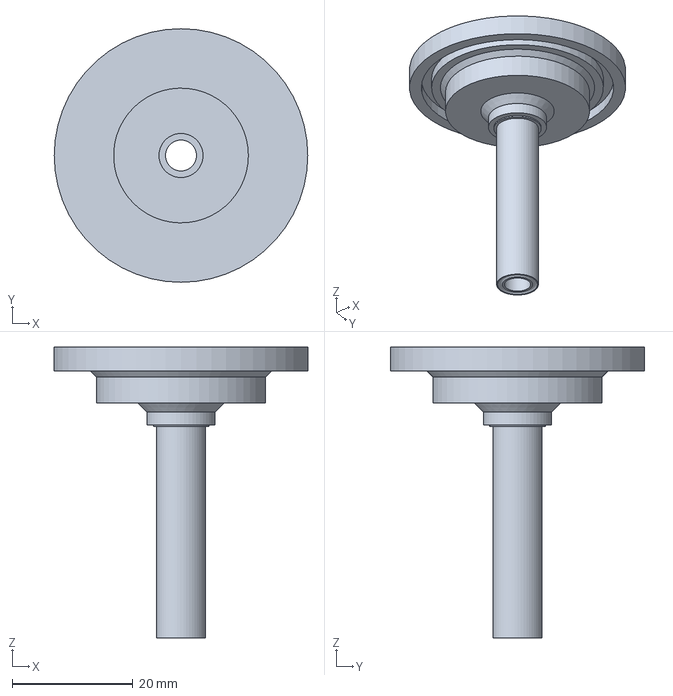
[picture p26: CAD file, 2026-10-31]
cad/control-dial/control-dial-v0.6/control-dial.step
42.0 x 42.0 x 48.2 mm
