EdgerEquals/knob-hardware/cad/displays/tft-0.71-round-gc9d01/tft-0.71-round-gc9d01.step

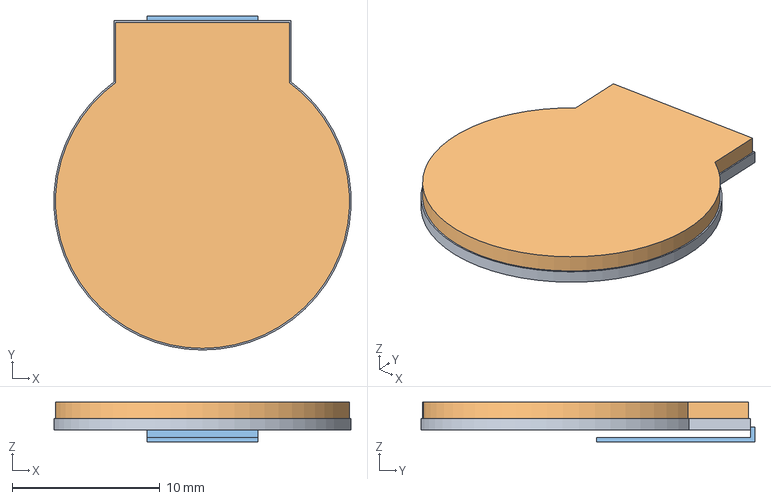
[picture p27: CAD file, 2026-10-31]
cad/displays/tft-0.71-round-gc9d01/tft-0.71-round-gc9d01.step
20.1 x 22.6 x 2.70 mm
