EdgerEquals/knob-hardware/cad/encoder-takeoff/encoder-takeoff-v0.5/encoder-big-gear-slotted-rim.step

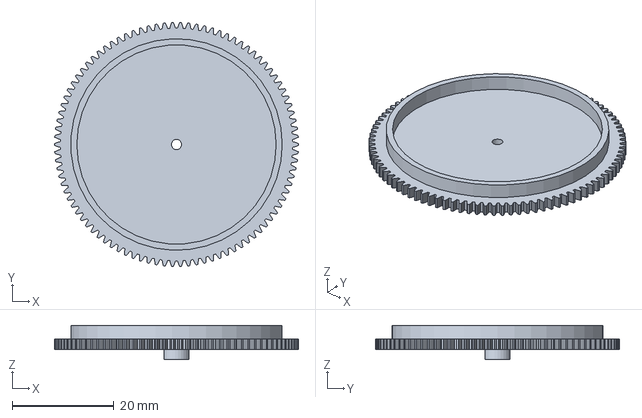
[picture p28: CAD file, 2026-10-31]
cad/encoder-takeoff/encoder-takeoff-v0.5/encoder-big-gear-slotted-rim.step
48.0 x 48.0 x 6.70 mm
