EdgerEquals/knob-hardware/cad/holders/screen-holder-v0.4/screen-holder.step

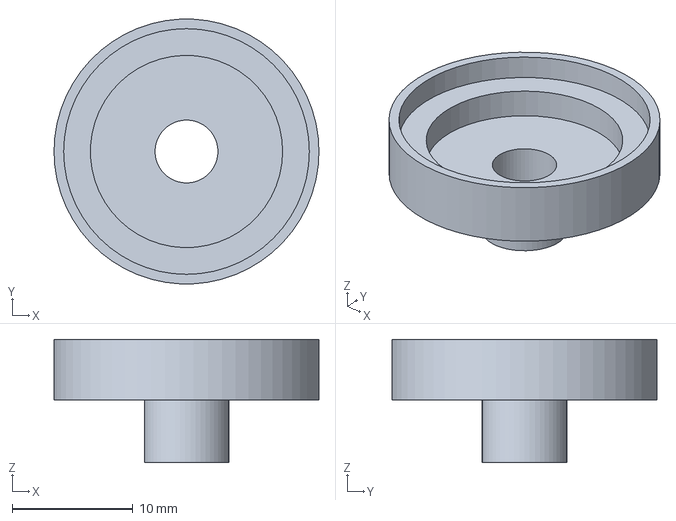
[picture p29: CAD file, 2026-10-31]
cad/holders/screen-holder-v0.4/screen-holder.step
21.9 x 21.9 x 10.2 mm
