EdgerEquals/knob-hardware/cad/knob-param/knobparam/electronics/kicad/joystick-daughterboard/joystick-daughterboard.step

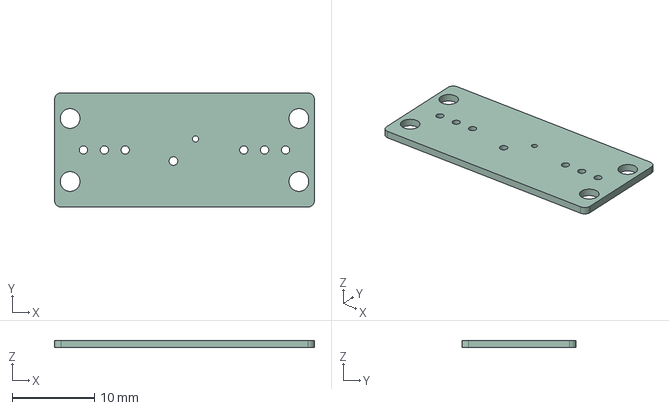
[picture p30: CAD file, 2026-11-01]
cad/knob-param/knobparam/electronics/kicad/joystick-daughterboard/joystick-daughterboard.step
31.6 x 13.9 x 0.91 mm
