EdgerEquals/knob-hardware/cad/knob-param/knobparam/electronics/kicad/screen-adapter/screen-adapter-with-envelopes.step

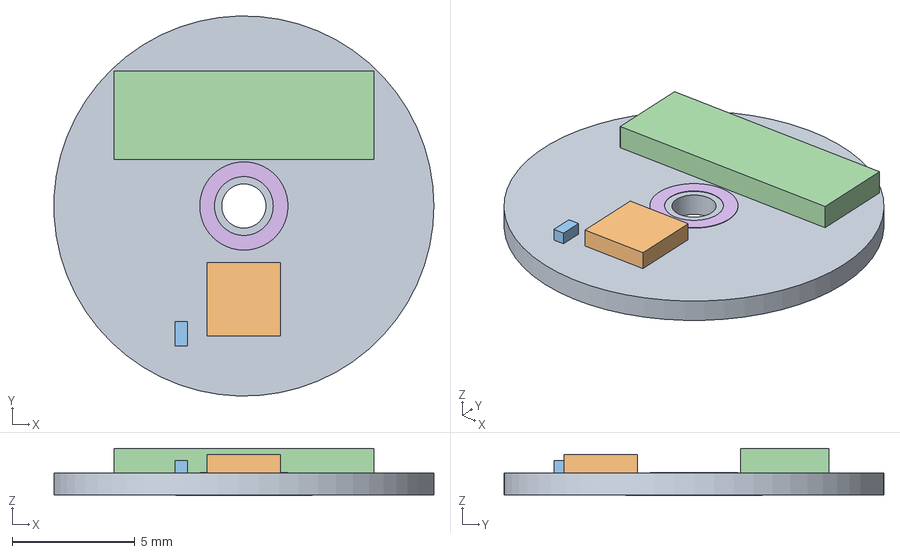
[picture p31: CAD file, 2026-11-01]
cad/knob-param/knobparam/electronics/kicad/screen-adapter/screen-adapter-with-envelopes.step
15.5 x 15.5 x 1.93 mm
screen-adapter_1
