EdgerEquals/knob-hardware/cad/knob/knob-v0.7/knob-v0.7-together.step

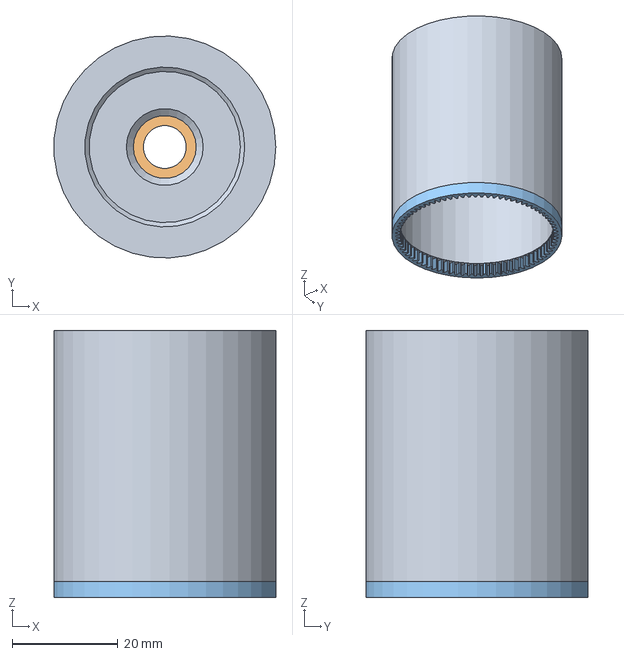
[picture p32: CAD file, 2026-10-31]
cad/knob/knob-v0.7/knob-v0.7-together.step
41.9 x 42.0 x 50.5 mm
