EdgerEquals/knob-hardware/cad/motors/1220-coreless-planetary/motor-1220.step

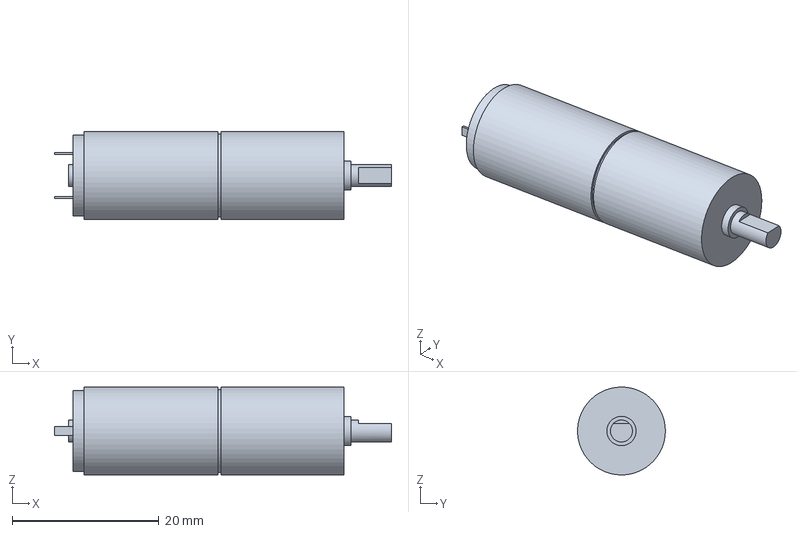
[picture p33: CAD file, 2026-10-31]
cad/motors/1220-coreless-planetary/motor-1220.step
46.0 x 12.0 x 12.0 mm
