EdgerEquals/knob-hardware/cad/motors/n30-planetary/motor-n30.step

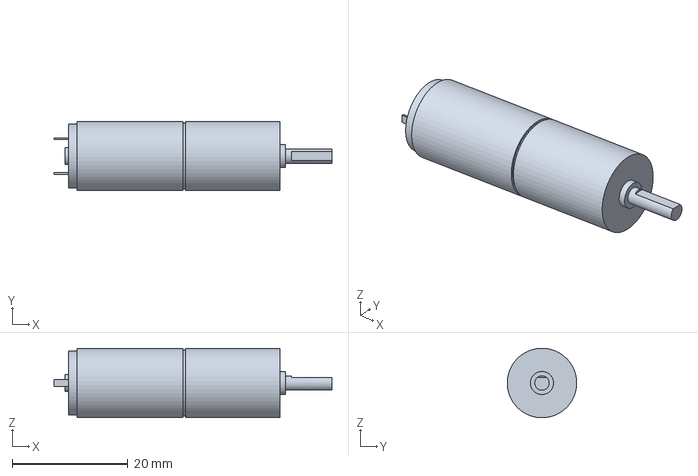
[picture p34: CAD file, 2026-10-31]
cad/motors/n30-planetary/motor-n30.step
48.0 x 12.0 x 12.0 mm
