EdgerEquals/knob-hardware/cad/shafts/fixed-hollow-shaft-4mm-onepiece/fixed-hollow-shaft-4mm-onepiece.step

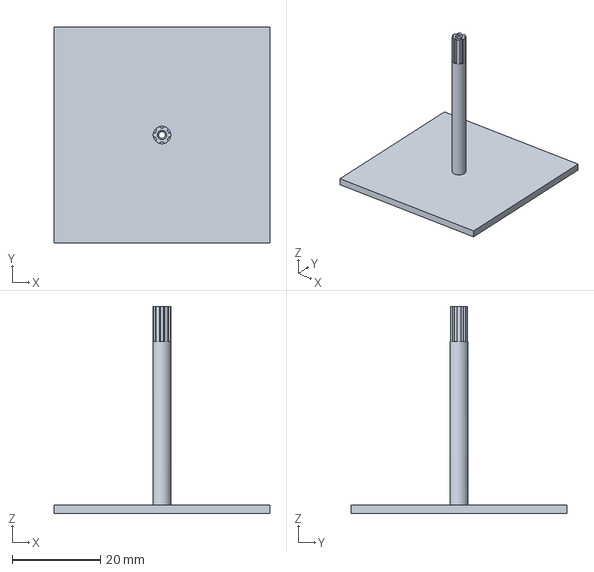
[picture p35: CAD file, 2026-10-31]
cad/shafts/fixed-hollow-shaft-4mm-onepiece/fixed-hollow-shaft-4mm-onepiece.step
49.0 x 49.0 x 47.0 mm
