EdgerEquals/knob-hardware/cad/shafts/fixed-hollow-shaft-4mm/fixed-hollow-shaft-4mm.step

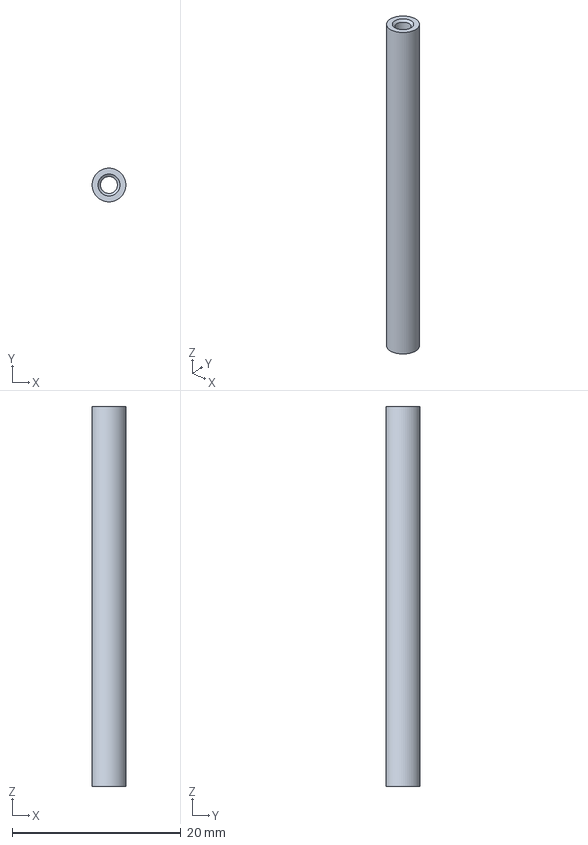
[picture p36: CAD file, 2026-10-31]
cad/shafts/fixed-hollow-shaft-4mm/fixed-hollow-shaft-4mm.step
4.00 x 4.00 x 45.0 mm
