EdgerEquals/knob-hardware/cad/shafts/fixed-hollow-shaft-6mm/shaft-base.step

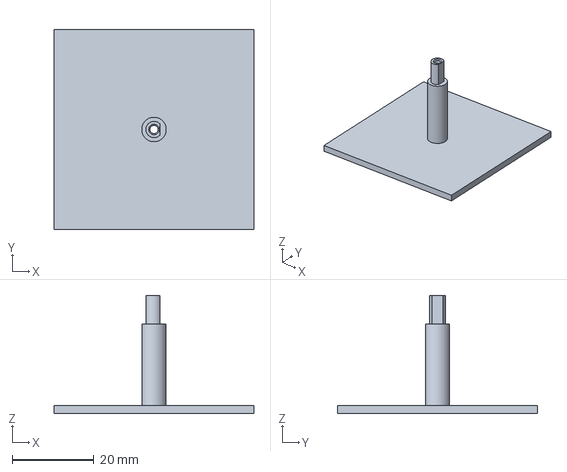
[picture p37: CAD file, 2026-10-31]
cad/shafts/fixed-hollow-shaft-6mm/shaft-base.step
49.0 x 49.0 x 29.0 mm
