EdgerEquals/knob-hardware/cad/shafts/fixed-shaft-brass-5x3-v0.4/brass-tube-5x3.step

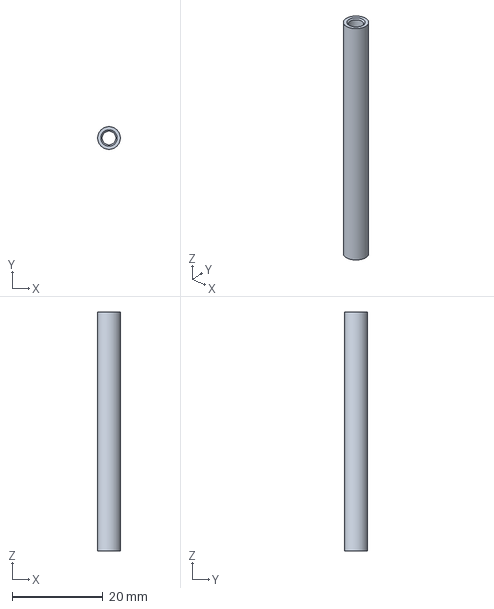
[picture p38: CAD file, 2026-10-31]
cad/shafts/fixed-shaft-brass-5x3-v0.4/brass-tube-5x3.step
5.00 x 5.00 x 52.6 mm
