EdgerEquals/knob-hardware/cad/shafts/rod-m1.6-v0.1/rod-m1.6-hardware.step

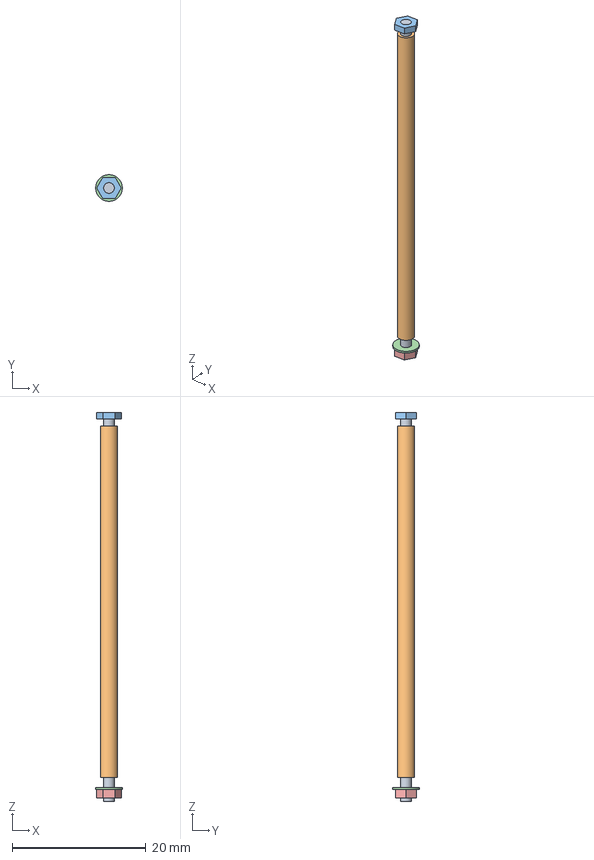
[picture p39: CAD file, 2026-10-31]
cad/shafts/rod-m1.6-v0.1/rod-m1.6-hardware.step
4.00 x 4.00 x 58.2 mm
