EdgerEquals/knob-hardware/cad/bearings/dial-thrust-v0.1/thrust-carrier-with-balls.step

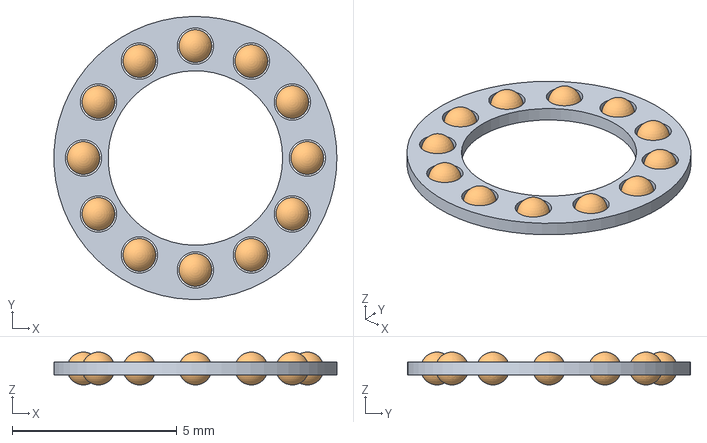
[picture p40: CAD file, 2026-10-31]
cad/bearings/dial-thrust-v0.1/thrust-carrier-with-balls.step
8.59 x 8.60 x 1.00 mm
