EdgerEquals/knob-hardware/cad/control-dial/control-dial-v0.6/magnet-placeholder.step

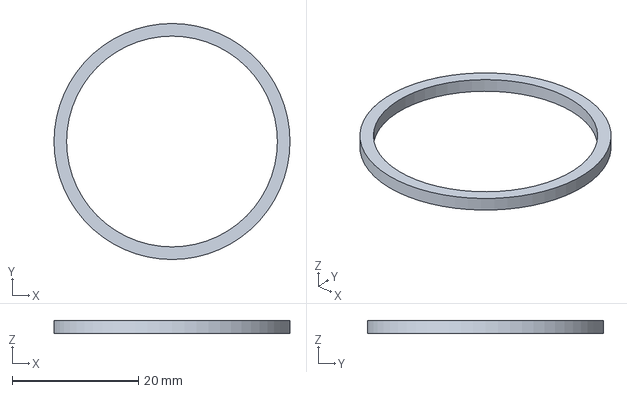
[picture p41: CAD file, 2026-10-31]
cad/control-dial/control-dial-v0.6/magnet-placeholder.step
37.4 x 37.4 x 2.00 mm
