EdgerEquals/knob-hardware/cad/encoder-takeoff/encoder-takeoff-v0.5/encoder-sensor-ee-sx1131.step

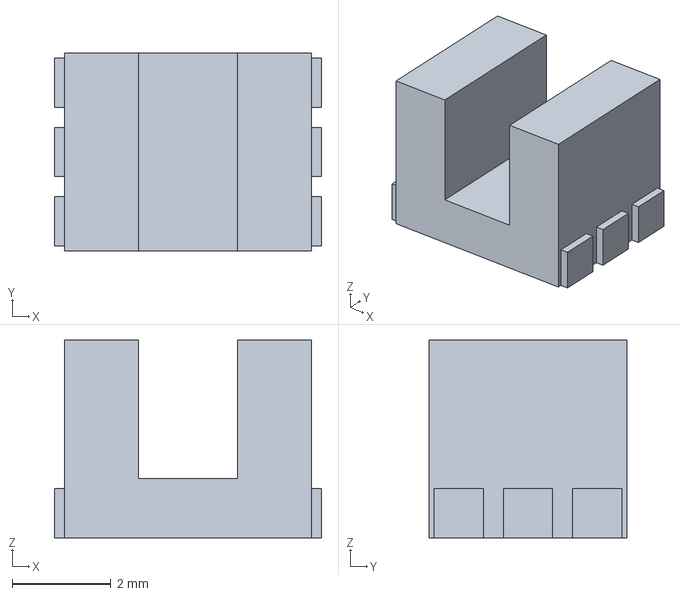
[picture p42: CAD file, 2026-10-31]
cad/encoder-takeoff/encoder-takeoff-v0.5/encoder-sensor-ee-sx1131.step
5.40 x 4.00 x 4.00 mm
