EdgerEquals/knob-hardware/cad/knob-param/knobparam/electronics/kicad/screen-adapter/screen-adapter.step

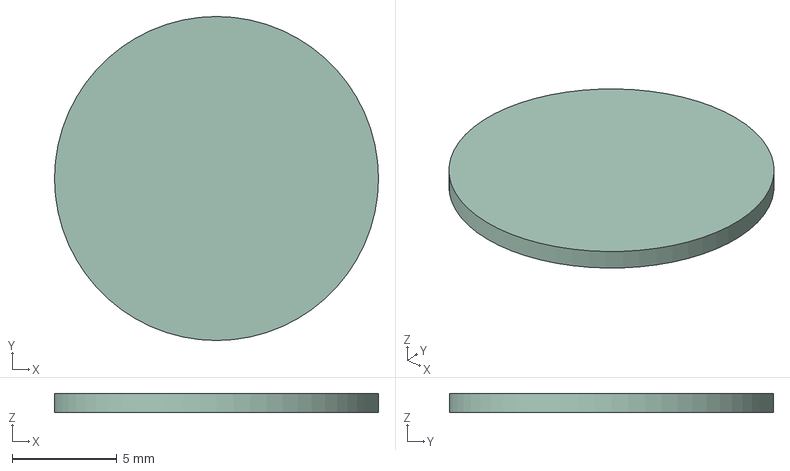
[picture p43: CAD file, 2026-11-01]
cad/knob-param/knobparam/electronics/kicad/screen-adapter/screen-adapter.step
15.5 x 15.5 x 0.91 mm
