EdgerEquals/knob-hardware/cad/knob/knob-v0.7/knob-body.step

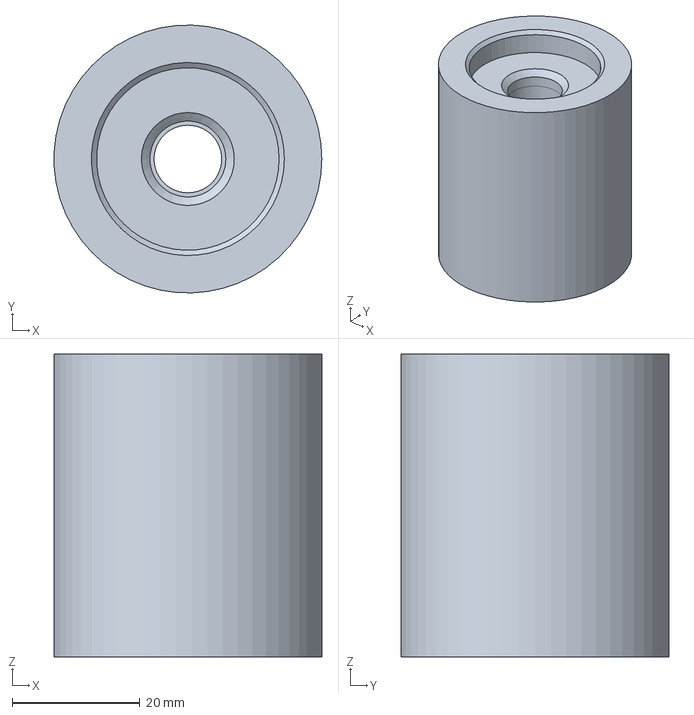
[picture p44: CAD file, 2026-10-31]
cad/knob/knob-v0.7/knob-body.step
42.0 x 42.0 x 47.5 mm
