EdgerEquals/knob-hardware/cad/shafts/fixed-hollow-shaft-6mm/shaft-top.step

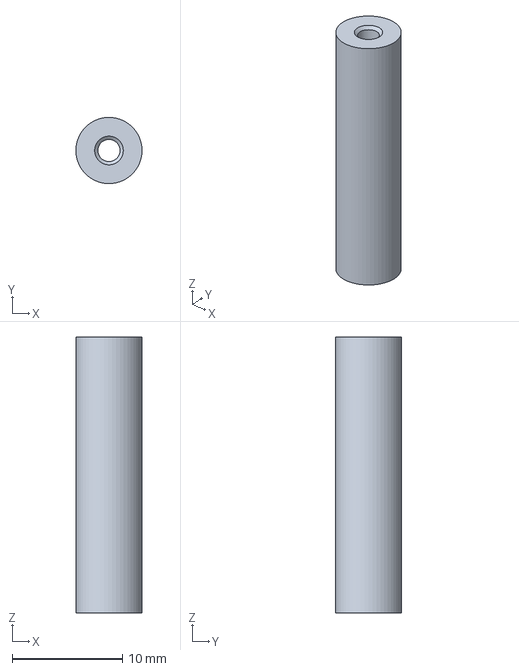
[picture p45: CAD file, 2026-10-31]
cad/shafts/fixed-hollow-shaft-6mm/shaft-top.step
5.99 x 6.00 x 25.0 mm
