EdgerEquals/knob-hardware/cad/encoder-takeoff/encoder-takeoff-v0.5/encoder-takeoff-together.step

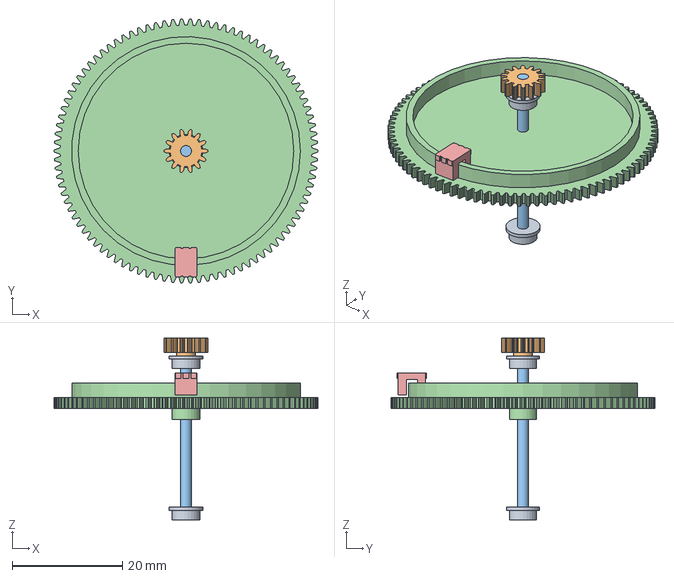
[picture p46: CAD file, 2026-10-31]
cad/encoder-takeoff/encoder-takeoff-v0.5/encoder-takeoff-together.step
48.0 x 48.0 x 33.0 mm
