EdgerEquals/knob-hardware/cad/encoder-takeoff/encoder-takeoff-v0.5/idler-pinion-pin.dxf

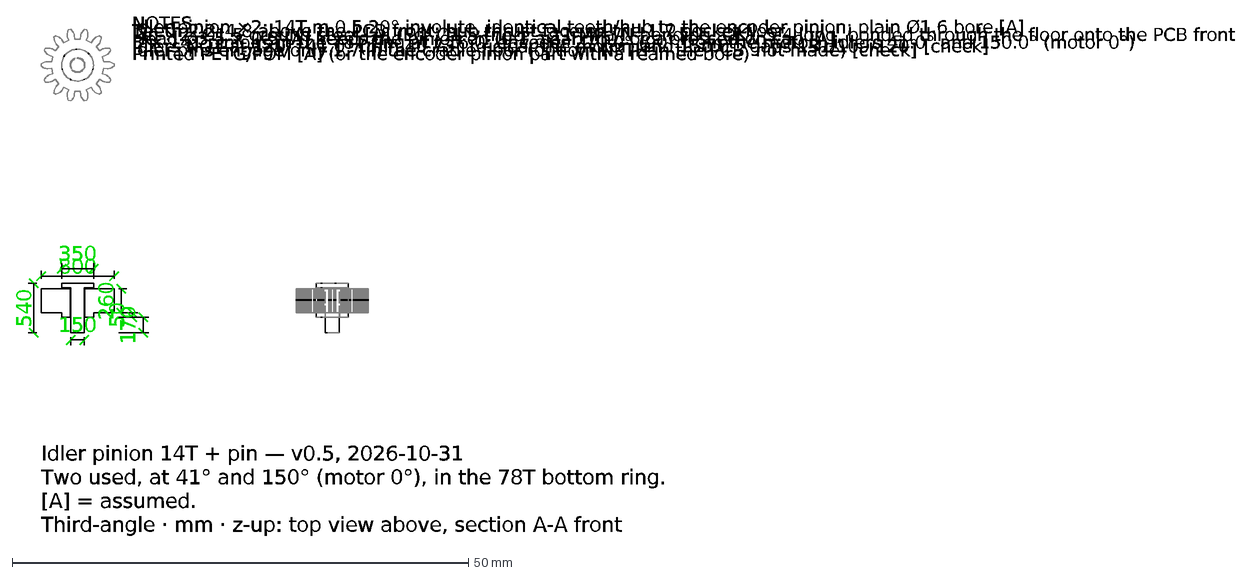
[picture p47: CAD file, 2026-10-31]
cad/encoder-takeoff/encoder-takeoff-v0.5/idler-pinion-pin.dxf
800
350
150
540
260
50
170
NOTES
Idler pinion ×2: 14T m 0.5 20° involute, identical teeth/hub to the encoder pinion; plain Ø1.6 bore [A]
Teeth 2.2–4.8 above the PCB front; hub thrust face on the 1.7 pocket floor
Pin ×2: Ø1.5 ground steel [A] (Ed: Ø1.5 tried; ~11 MPa/N bending, OK), 5.4 long, bonded through the floor onto the PCB front
Head Ø3.5 × 0.5 [A] keeps the pinion on (0.1 axial run); or a pressed-on cap [A]
3 × 14T pinions in the 78T ring at r 16.0: encoder 270.0° (90° from the motor), idlers 41.0° and 150.0° (motor 0°)
Idlers NOT at 120°: 41.0° (min 40.73° to clear the motor) and 150.0°; gaps 131/109/120° [check]
Idler pins engage only 1.7 in the cradle floor (option: NPTH in the PCB, not made) [check]
Printed PETG/POM [A] (or the encoder pinion part with a reamed bore)
Idler pinion 14T + pin — v0.5, 2026-10-31
Two used, at 41° and 150° (motor 0°), in the 78T bottom ring.
[A] = assumed.
Third-angle · mm · z-up: top view above, section A-A front
