EdgerEquals/knob-hardware/(list of files, cad)

Other CAD files:
cad/assemblies/knob-stack-v0.1/knob-stack-v0.1.dxf
cad/assemblies/knob-stack-v0.1/knob-stack-v0.1.step
cad/assemblies/knob-stack-v0.10/knob-stack-v0.10-half-section.step
cad/assemblies/knob-stack-v0.10/knob-stack-v0.10.dxf
cad/assemblies/knob-stack-v0.10/knob-stack-v0.10.step
cad/assemblies/knob-stack-v0.11/knob-stack-v0.11-encoder-closeup.dxf
cad/assemblies/knob-stack-v0.11/knob-stack-v0.11-half-section.step
cad/assemblies/knob-stack-v0.11/knob-stack-v0.11.dxf
cad/assemblies/knob-stack-v0.11/knob-stack-v0.11.step
cad/assemblies/knob-stack-v0.2/knob-stack-v0.2.dxf
cad/assemblies/knob-stack-v0.2/knob-stack-v0.2.step
cad/assemblies/knob-stack-v0.3/knob-stack-v0.3.dxf
cad/assemblies/knob-stack-v0.3/knob-stack-v0.3.step
cad/assemblies/knob-stack-v0.4/knob-stack-v0.4.dxf
cad/assemblies/knob-stack-v0.4/knob-stack-v0.4.step
cad/assemblies/knob-stack-v0.5/knob-stack-v0.5.dxf
cad/assemblies/knob-stack-v0.5/knob-stack-v0.5.step
cad/assemblies/knob-stack-v0.6/knob-stack-v0.6-half-section.step
cad/assemblies/knob-stack-v0.6/knob-stack-v0.6.dxf
cad/assemblies/knob-stack-v0.6/knob-stack-v0.6.step
cad/assemblies/knob-stack-v0.7/knob-stack-v0.7-half-section.step
cad/assemblies/knob-stack-v0.7/knob-stack-v0.7.dxf
cad/assemblies/knob-stack-v0.7/knob-stack-v0.7.step
cad/assemblies/knob-stack-v0.8/knob-stack-v0.8-half-section.step
cad/assemblies/knob-stack-v0.8/knob-stack-v0.8.dxf
cad/assemblies/knob-stack-v0.8/knob-stack-v0.8.step
cad/assemblies/knob-stack-v0.9/knob-stack-v0.9-half-section.step
cad/assemblies/knob-stack-v0.9/knob-stack-v0.9.dxf
cad/assemblies/knob-stack-v0.9/knob-stack-v0.9.step
cad/base-cradle/base-cradle-v0.3/base-cradle.dxf
cad/base-cradle/base-cradle-v0.3/base-cradle.step
cad/base-cradle/base-cradle-v0.4/base-cradle.dxf
cad/base-cradle/base-cradle-v0.4/base-cradle.step
cad/base-cradle/base-cradle-v0.5/base-cradle.dxf
cad/bearings/dial-thrust-v0.1/thrust-carrier-with-balls.dxf
cad/bearings/dial-thrust-v0.1/thrust-carrier.dxf
cad/bezel-knob/bezel-knob-v0.1/bezel.dxf
cad/bezel-knob/bezel-knob-v0.1/bezel.step
cad/bezel-knob/bezel-knob-v0.2/bezel-knob.dxf
cad/bezel-knob/bezel-knob-v0.2/bezel-knob.step
cad/control-dial/control-dial-v0.1/bezel.dxf
cad/control-dial/control-dial-v0.1/bezel.step
cad/control-dial/control-dial-v0.2/bezel-knob.dxf
cad/control-dial/control-dial-v0.2/bezel-knob.step
cad/control-dial/control-dial-v0.3/control-dial.dxf
cad/control-dial/control-dial-v0.3/control-dial.step
cad/control-dial/control-dial-v0.4/control-dial.dxf
cad/control-dial/control-dial-v0.4/control-dial.step
cad/control-dial/control-dial-v0.4/magnet-placeholder.step
cad/control-dial/control-dial-v0.5/control-dial.dxf
cad/control-dial/control-dial-v0.5/control-dial.step
cad/control-dial/control-dial-v0.5/magnet-placeholder.step
cad/control-dial/control-dial-v0.6/control-dial.dxf
cad/displays/tft-0.71-round-gc9d01/tft-0.71-round-gc9d01.dxf
cad/encoder-takeoff/encoder-takeoff-v0.1/encoder-bearing-f682zz.dxf
cad/encoder-takeoff/encoder-takeoff-v0.1/encoder-bearing-f682zz.step
cad/encoder-takeoff/encoder-takeoff-v0.1/encoder-big-gear.dxf
cad/encoder-takeoff/encoder-takeoff-v0.1/encoder-big-gear.step
cad/encoder-takeoff/encoder-takeoff-v0.1/encoder-pinion.dxf
cad/encoder-takeoff/encoder-takeoff-v0.1/encoder-pinion.step
cad/encoder-takeoff/encoder-takeoff-v0.1/encoder-shaft.dxf
cad/encoder-takeoff/encoder-takeoff-v0.1/encoder-shaft.step
cad/encoder-takeoff/encoder-takeoff-v0.1/encoder-takeoff-together.dxf
cad/encoder-takeoff/encoder-takeoff-v0.1/encoder-takeoff-together.step
cad/encoder-takeoff/encoder-takeoff-v0.2/encoder-bearing-f682zz.dxf
cad/encoder-takeoff/encoder-takeoff-v0.2/encoder-bearing-f682zz.step
cad/encoder-takeoff/encoder-takeoff-v0.2/encoder-big-gear.dxf
cad/encoder-takeoff/encoder-takeoff-v0.2/encoder-big-gear.step
cad/encoder-takeoff/encoder-takeoff-v0.2/encoder-pinion.dxf
cad/encoder-takeoff/encoder-takeoff-v0.2/encoder-pinion.step
cad/encoder-takeoff/encoder-takeoff-v0.2/encoder-shaft.dxf
cad/encoder-takeoff/encoder-takeoff-v0.2/encoder-shaft.step
cad/encoder-takeoff/encoder-takeoff-v0.2/encoder-takeoff-together.dxf
cad/encoder-takeoff/encoder-takeoff-v0.2/encoder-takeoff-together.step
cad/encoder-takeoff/encoder-takeoff-v0.3/encoder-pinion.dxf
cad/encoder-takeoff/encoder-takeoff-v0.3/encoder-pinion.step
cad/encoder-takeoff/encoder-takeoff-v0.3/encoder-takeoff-together.dxf
cad/encoder-takeoff/encoder-takeoff-v0.3/encoder-takeoff-together.step
cad/encoder-takeoff/encoder-takeoff-v0.4/encoder-takeoff-together.dxf
cad/encoder-takeoff/encoder-takeoff-v0.4/encoder-takeoff-together.step
cad/encoder-takeoff/encoder-takeoff-v0.4/idler-pinion-pin.dxf
cad/encoder-takeoff/encoder-takeoff-v0.5/encoder-big-gear-slotted-rim.dxf
cad/encoder-takeoff/encoder-takeoff-v0.5/encoder-sensor-ee-sx1131.dxf
cad/encoder-takeoff/encoder-takeoff-v0.5/encoder-takeoff-together.dxf
cad/holders/screen-holder-v0.1/screen-holder.dxf
cad/holders/screen-holder-v0.1/screen-holder.step
cad/holders/screen-holder-v0.1/screen-stack-together.dxf
cad/holders/screen-holder-v0.1/screen-stack-together.step
cad/holders/screen-holder-v0.2/screen-holder.dxf
cad/holders/screen-holder-v0.2/screen-holder.step
cad/holders/screen-holder-v0.3/screen-holder.dxf
cad/holders/screen-holder-v0.3/screen-holder.step
cad/holders/screen-holder-v0.4/screen-holder.dxf
cad/knob-param/knobparam/electronics/kicad/knob-main-pcb/knob-main-pcb.dxf
cad/knob-param/knobparam/electronics/kicad/screen-adapter/screen-adapter.dxf
cad/knob/knob-v0.1/bottom-ring-gear.dxf
cad/knob/knob-v0.1/bottom-ring-gear.step
cad/knob/knob-v0.1/internal-ring-gear.dxf
cad/knob/knob-v0.1/internal-ring-gear.step
cad/knob/knob-v0.1/knob-cap-hub.dxf
cad/knob/knob-v0.1/knob-cap-hub.step
cad/knob/knob-v0.1/knob-v0.1-together.dxf
cad/knob/knob-v0.1/knob-v0.1-together.step
cad/knob/knob-v0.1/motor-pinion.dxf
cad/knob/knob-v0.1/motor-pinion.step
cad/knob/knob-v0.2/bottom-internal-ring.dxf
cad/knob/knob-v0.2/bottom-internal-ring.step
cad/knob/knob-v0.2/knob-cap-skirt.dxf
cad/knob/knob-v0.2/knob-cap-skirt.step
cad/knob/knob-v0.2/knob-v0.2-together.dxf
cad/knob/knob-v0.2/knob-v0.2-together.step
cad/knob/knob-v0.3/knob-cap-skirt.dxf
cad/knob/knob-v0.3/knob-cap-skirt.step
cad/knob/knob-v0.3/knob-v0.3-together.dxf
cad/knob/knob-v0.3/knob-v0.3-together.step
cad/knob/knob-v0.4/bottom-internal-ring.dxf
cad/knob/knob-v0.4/bottom-internal-ring.step
cad/knob/knob-v0.4/knob-cap-skirt-tube.dxf
cad/knob/knob-v0.4/knob-cap-skirt-tube.step
cad/knob/knob-v0.4/knob-v0.4-together.dxf
cad/knob/knob-v0.4/knob-v0.4-together.step
cad/knob/knob-v0.5/knob-body.dxf
cad/knob/knob-v0.5/knob-body.step
cad/knob/knob-v0.5/knob-v0.5-together.dxf
cad/knob/knob-v0.5/knob-v0.5-together.step
cad/knob/knob-v0.6/knob-body.dxf
cad/knob/knob-v0.6/knob-body.step
cad/knob/knob-v0.6/knob-v0.6-together.dxf
cad/knob/knob-v0.6/knob-v0.6-together.step
cad/knob/knob-v0.7/knob-body.dxf
cad/knob/knob-v0.7/knob-v0.7-together.dxf
cad/motors/1220-coreless-planetary/motor-1220.dxf
cad/motors/n30-planetary/motor-n30.dxf
cad/pcbs/knob-main-pcb/knob-main-pcb.dxf
cad/pcbs/knob-main-pcb/knob-main-pcb.step
cad/pcbs/screen-adapter/screen-adapter-with-envelopes.step
cad/pcbs/screen-adapter/screen-adapter.dxf
cad/pcbs/screen-adapter/screen-adapter.step
cad/shafts/fixed-hollow-shaft-4mm-onepiece/fixed-hollow-shaft-4mm-onepiece.dxf
cad/shafts/fixed-hollow-shaft-4mm/fixed-hollow-shaft-4mm.dxf
cad/shafts/fixed-hollow-shaft-6mm/shaft-6mm-assembled.dxf
cad/shafts/fixed-hollow-shaft-6mm/shaft-base.dxf
cad/shafts/fixed-hollow-shaft-6mm/shaft-top.dxf
cad/shafts/fixed-shaft-brass-5x3-v0.2/brass-tube-5x3.dxf
cad/shafts/fixed-shaft-brass-5x3-v0.2/brass-tube-5x3.step
cad/shafts/fixed-shaft-brass-5x3-v0.2/fixed-shaft-brass-5x3-assembled.dxf
cad/shafts/fixed-shaft-brass-5x3-v0.2/fixed-shaft-brass-5x3-assembled.step
cad/shafts/fixed-shaft-brass-5x3-v0.2/shaft-flange-printed.dxf
cad/shafts/fixed-shaft-brass-5x3-v0.2/shaft-flange-printed.step
cad/shafts/fixed-shaft-brass-5x3-v0.3/brass-tube-5x3.dxf
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
