EdgerEquals/knob-hardware/cad/assemblies/joystick-v0.4/joystick-v0.4-plan.png

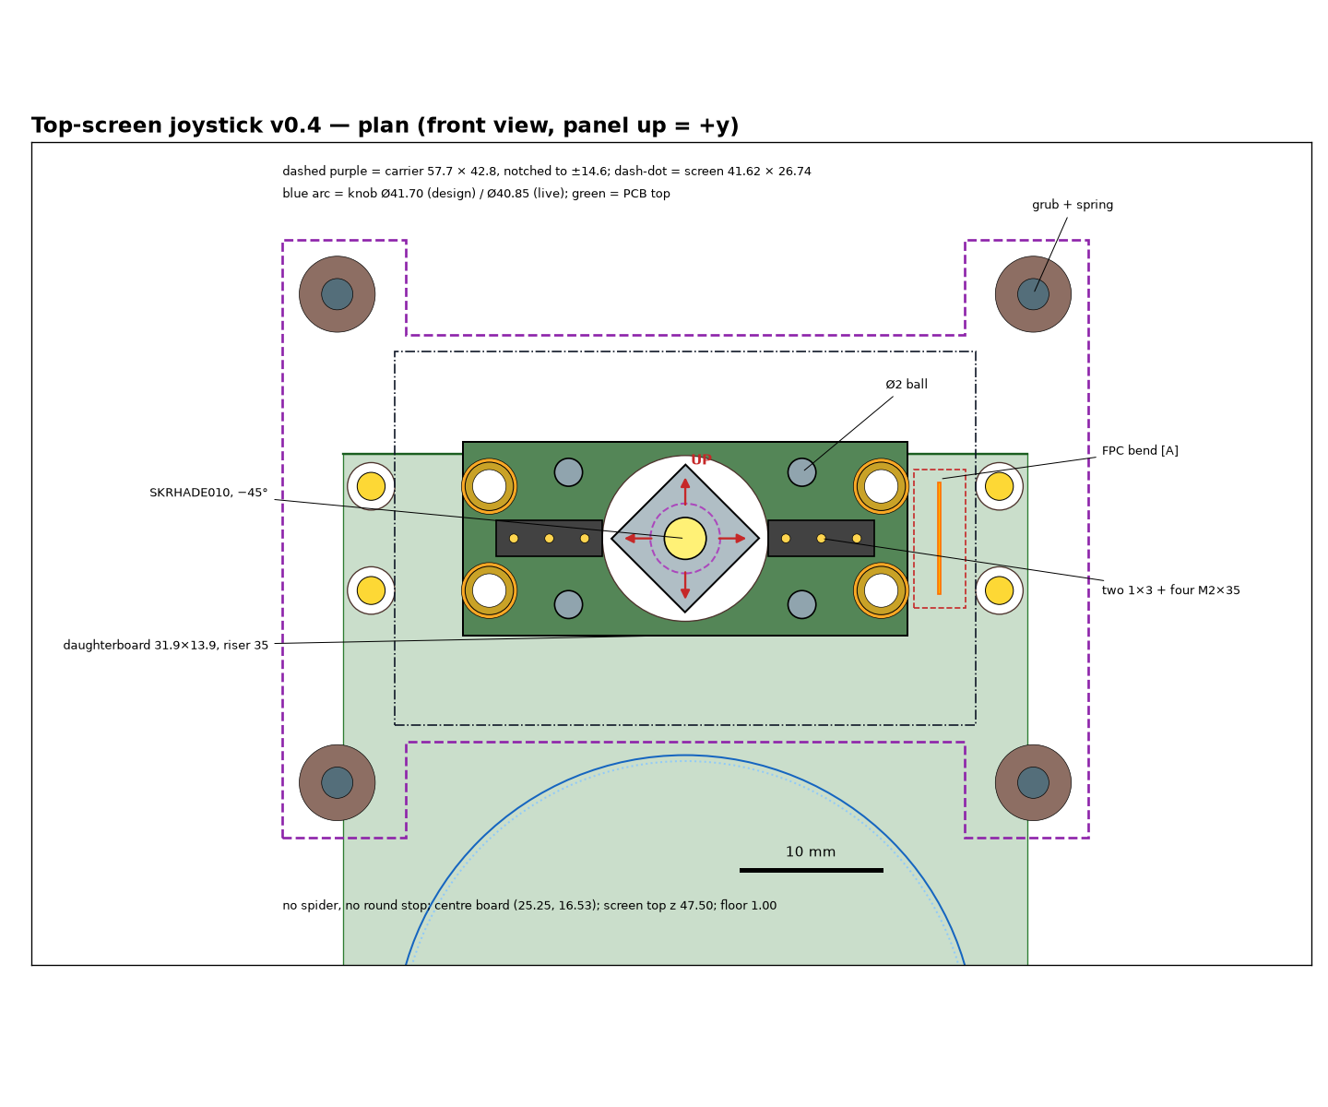
cad/assemblies/joystick-v0.4/joystick-v0.4-plan.png
