EdgerEquals/knob-hardware/cad/assemblies/joystick-v0.4/joystick-v0.4-preview.png

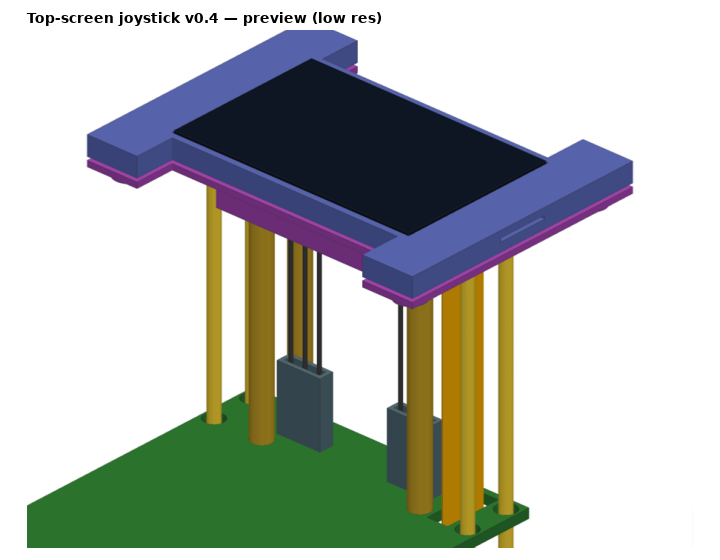
cad/assemblies/joystick-v0.4/joystick-v0.4-preview.png
