EdgerEquals/knob-hardware/cad/assemblies/joystick-v0.4/joystick-v0.4.png

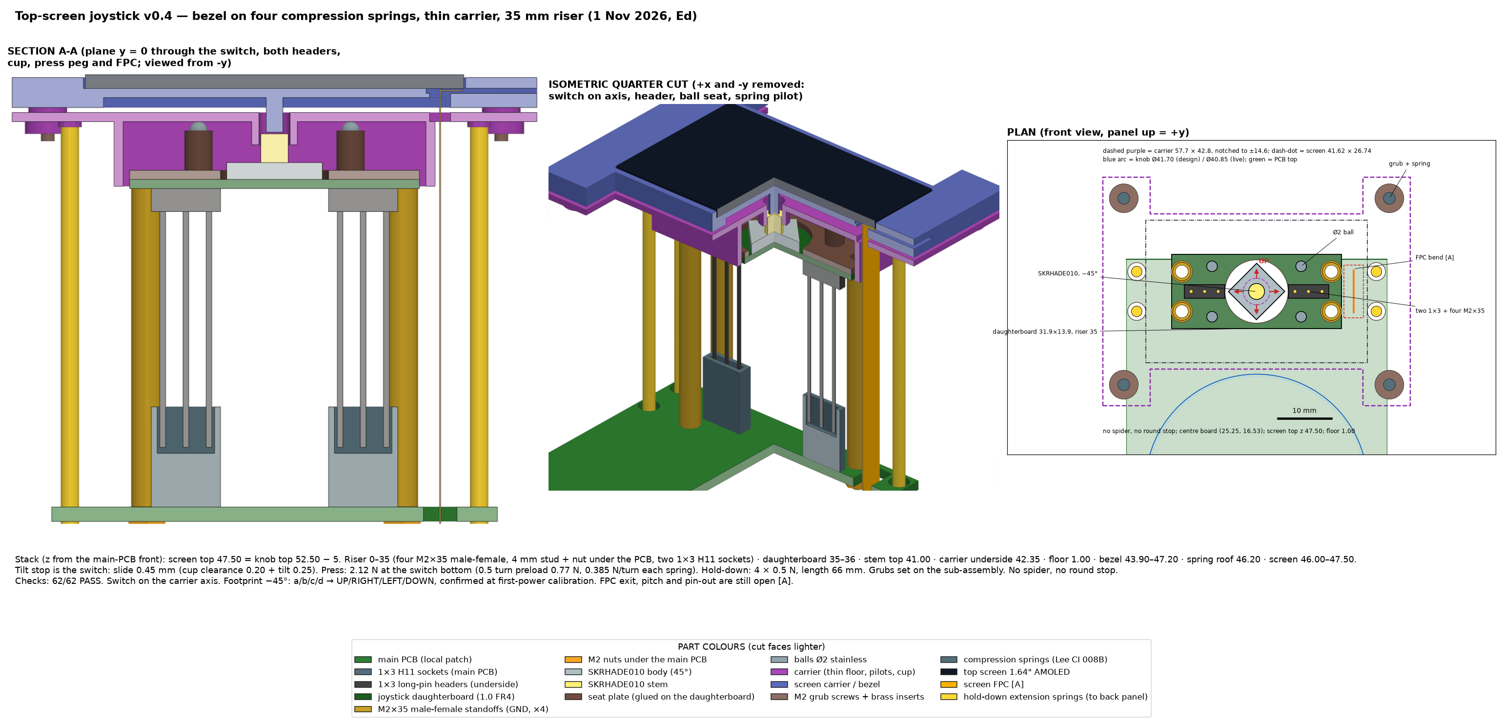
cad/assemblies/joystick-v0.4/joystick-v0.4.png
