EdgerEquals/knob-hardware/cad/assemblies/joystick-v0.4/views/exploded.png

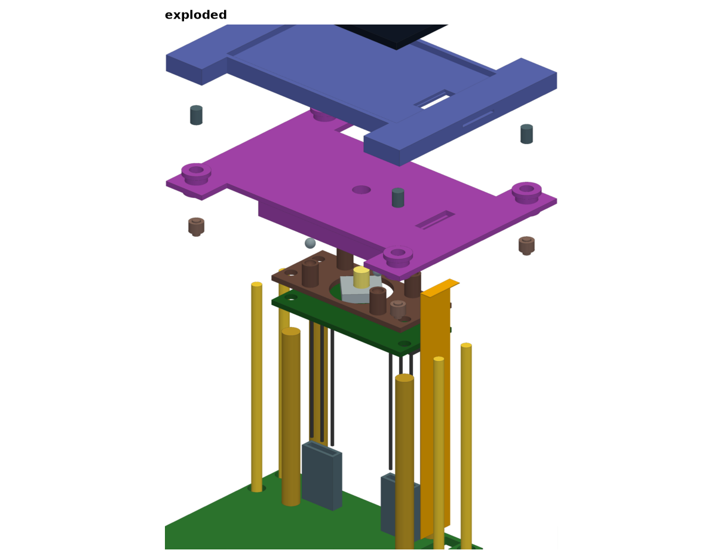
cad/assemblies/joystick-v0.4/views/exploded.png
