EdgerEquals/knob-hardware/cad/assemblies/joystick-v0.4/views/iso-above.png

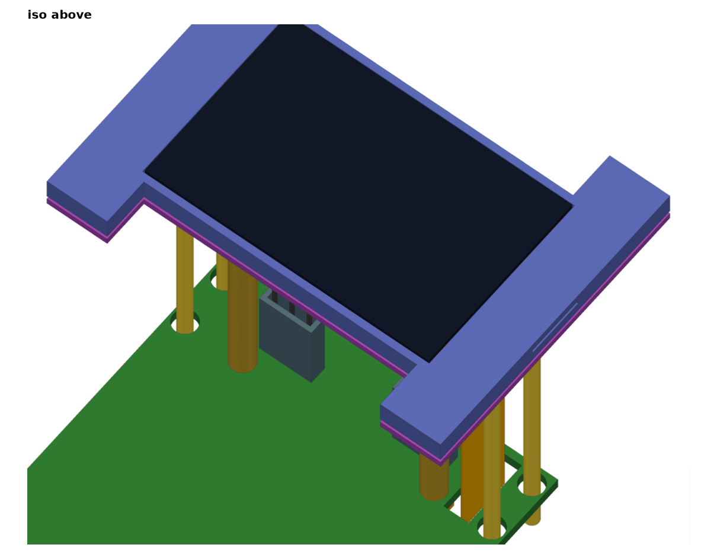
cad/assemblies/joystick-v0.4/views/iso-above.png
