EdgerEquals/knob-hardware/cad/assemblies/joystick-v0.4/views/iso-below.png

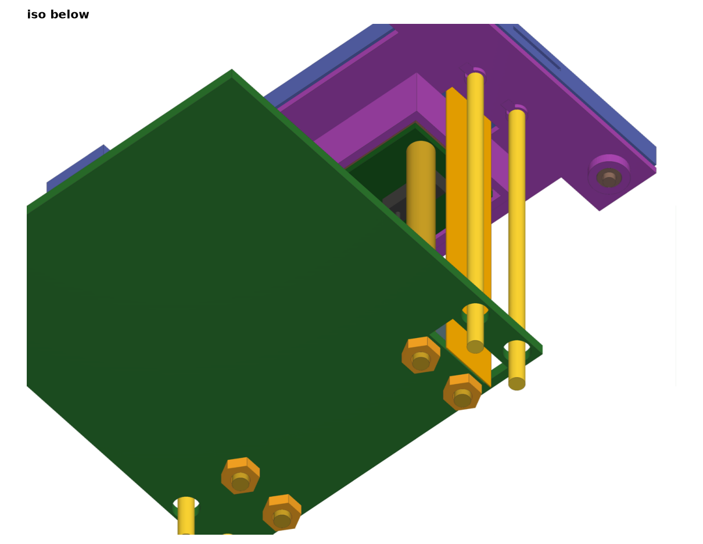
cad/assemblies/joystick-v0.4/views/iso-below.png
