EdgerEquals/knob-hardware/cad/assemblies/joystick-v0.4/views/quarter-cut.png

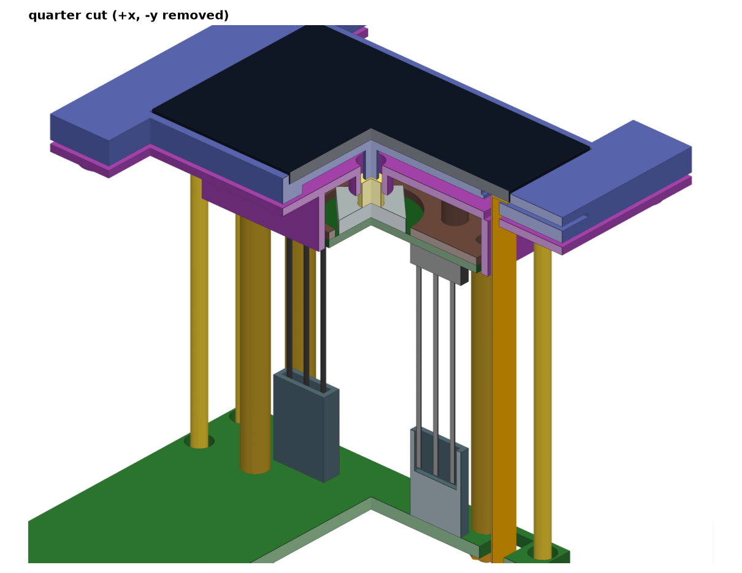
cad/assemblies/joystick-v0.4/views/quarter-cut.png
