EdgerEquals/knob-hardware/cad/assemblies/joystick-v0.4/views/section-x.png

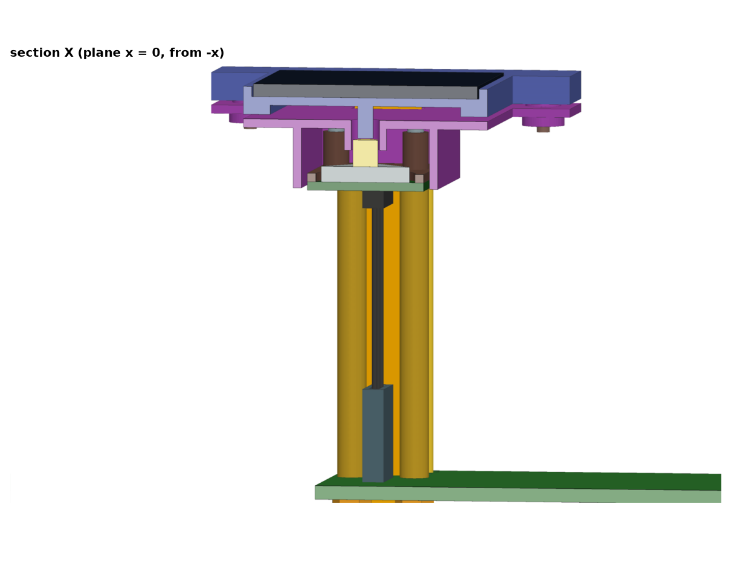
cad/assemblies/joystick-v0.4/views/section-x.png
