EdgerEquals/knob-hardware/cad/assemblies/joystick-v0.4/views/section-y.png

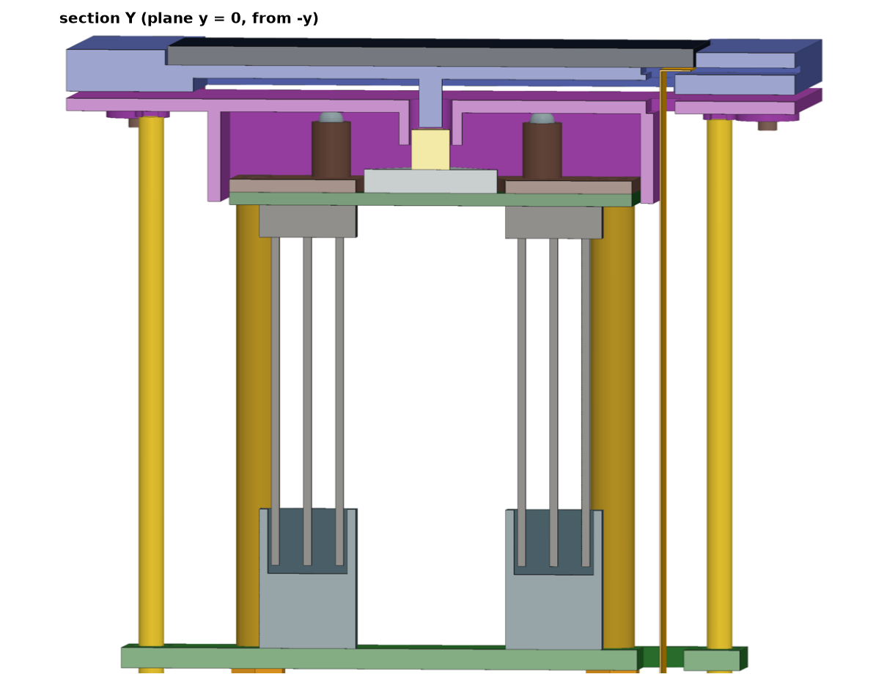
cad/assemblies/joystick-v0.4/views/section-y.png
