EdgerEquals/knob-hardware/cad/assemblies/knob-stack-v0.16/knob-stack-v0.16-clean-opposite.png

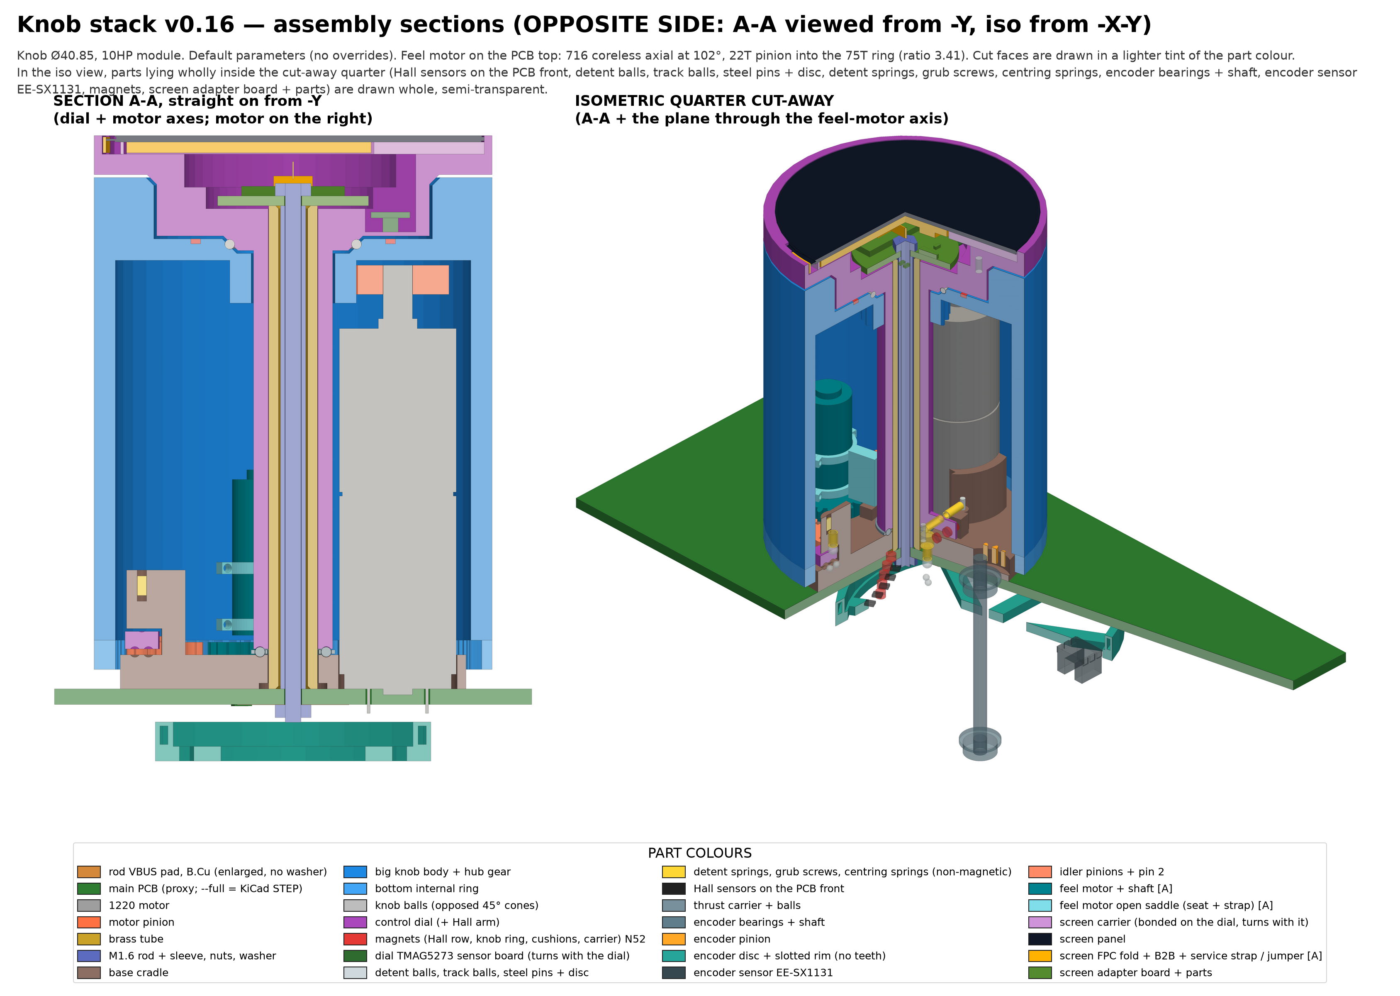
cad/assemblies/knob-stack-v0.16/knob-stack-v0.16-clean-opposite.png
