EdgerEquals/knob-hardware/cad/assemblies/knob-stack-v0.16/knob-stack-v0.16-plan.png

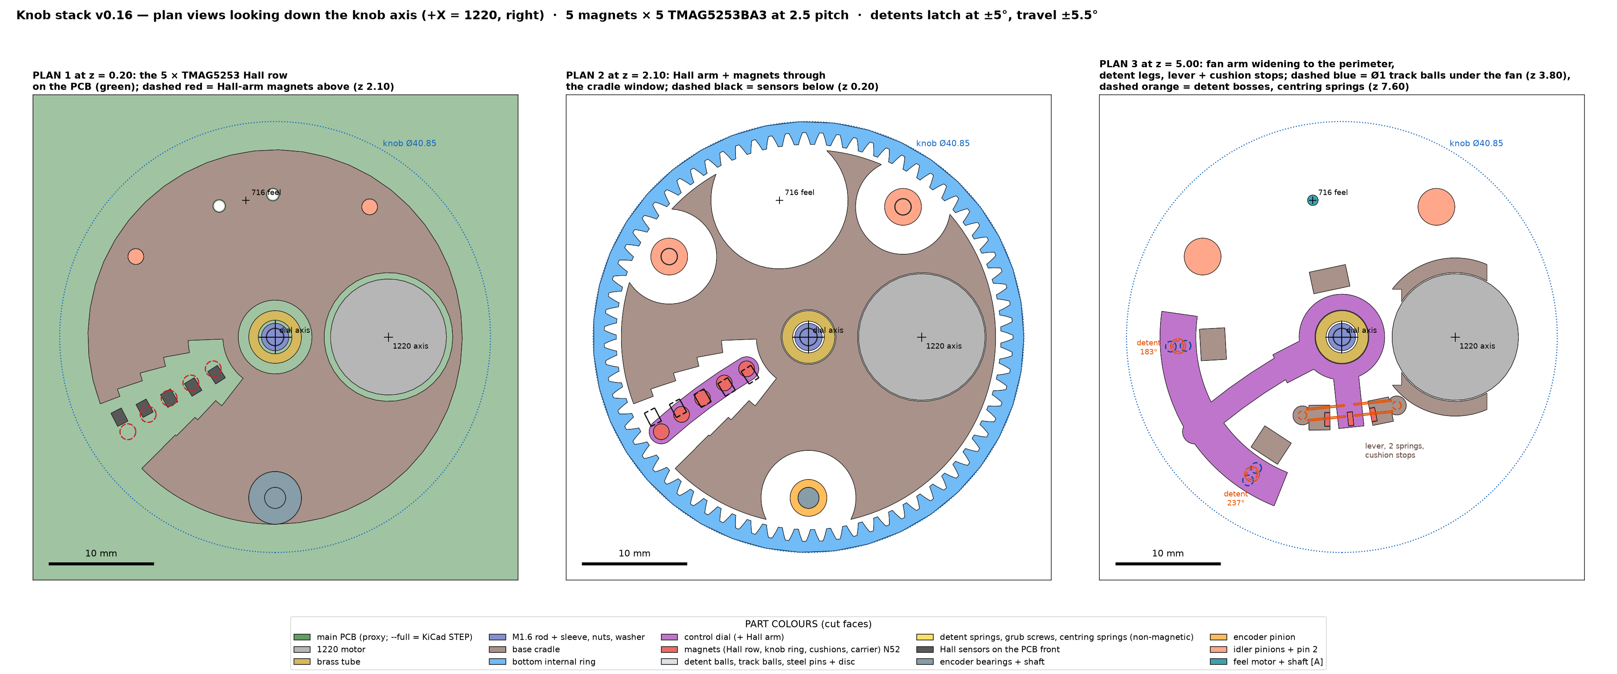
cad/assemblies/knob-stack-v0.16/knob-stack-v0.16-plan.png
