EdgerEquals/knob-hardware/cad/assemblies/knob-stack-v0.16b/knob-stack-v0.16b-plan.png

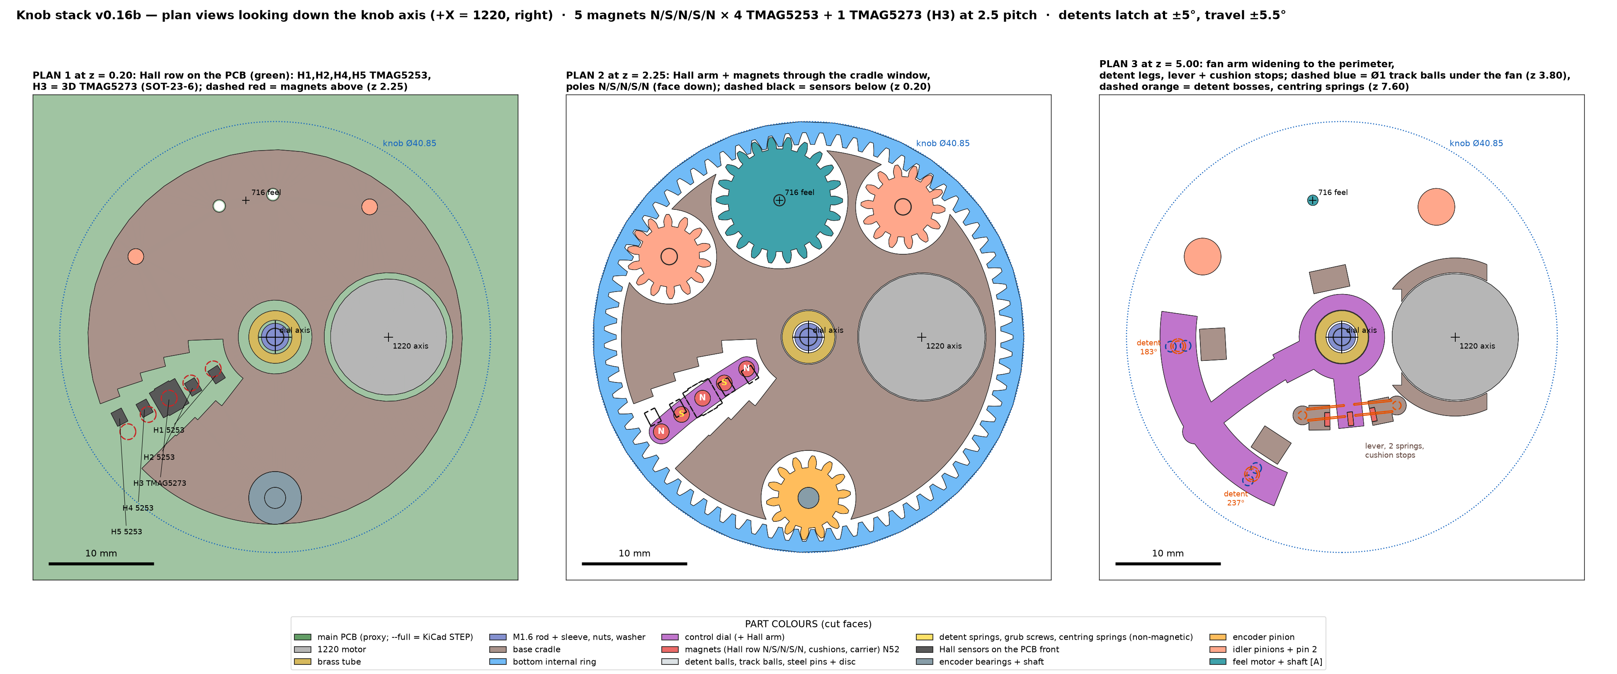
cad/assemblies/knob-stack-v0.16b/knob-stack-v0.16b-plan.png
