EdgerEquals/knob-hardware/cad/shafts/fixed-hollow-shaft-6mm/shaft-6mm-assembled-drawing.png

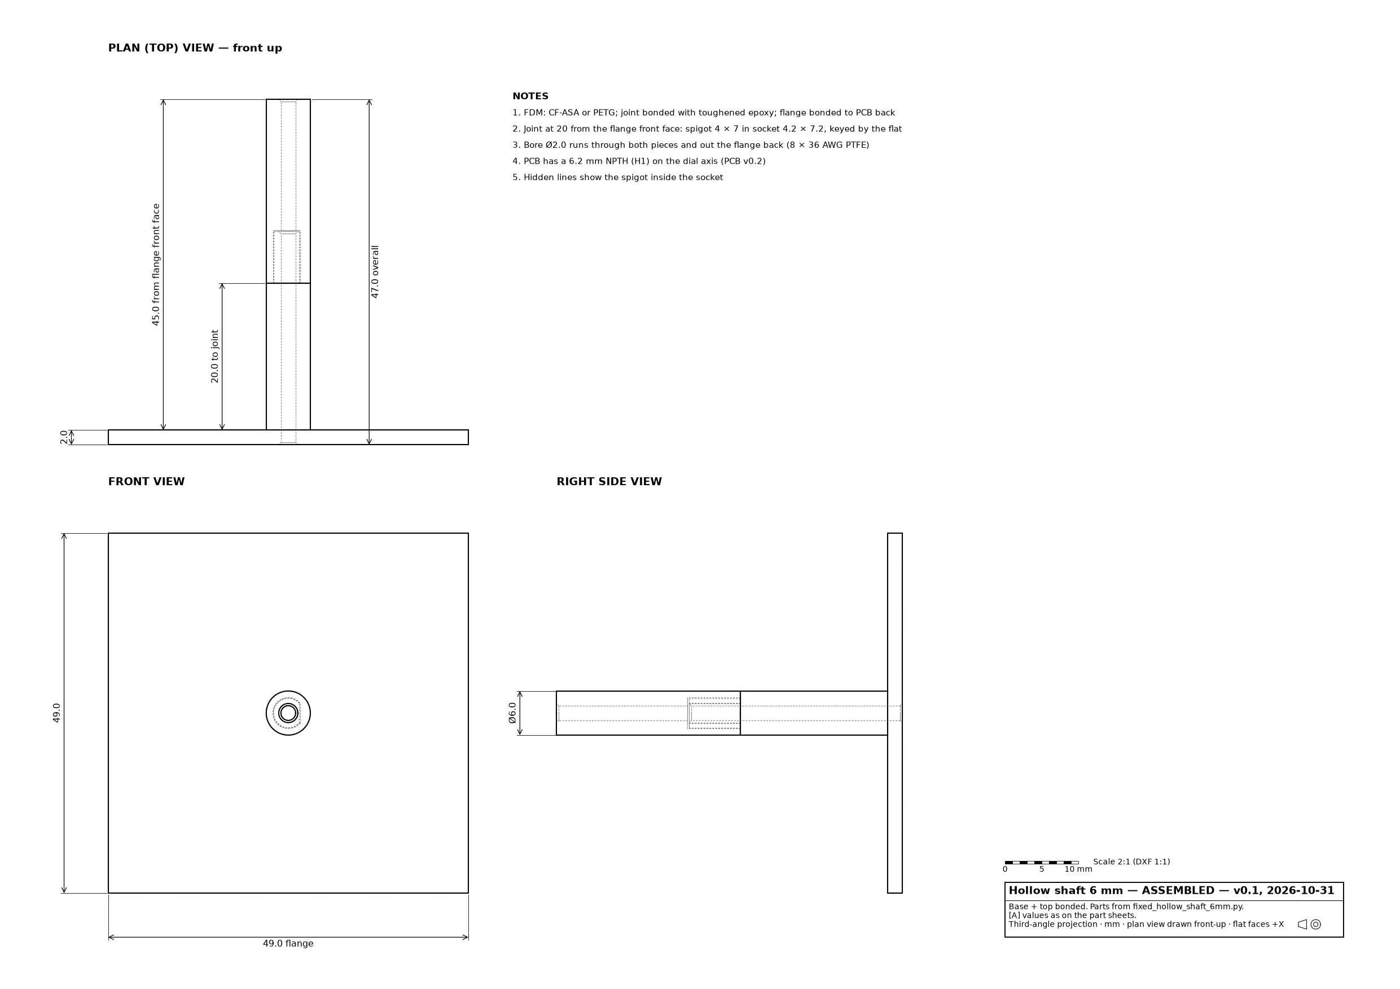
cad/shafts/fixed-hollow-shaft-6mm/shaft-6mm-assembled-drawing.png
