EdgerEquals/knob-hardware/(list of files, drawings)

Other design files:
cad/knob-param/knobparam/electronics/kicad/knob-main-pcb/pcb_proxy.json
