EdgerEquals/knob-hardware/cad/knob-param/knobparam/electronics/kicad/joystick-daughterboard/joystick-daughterboard.kicad_pcb

## KiCad design cad/knob-param/knobparam/electronics/kicad/joystick-daughterboard/joystick-daughterboard.kicad_pcb (2026-11-01)

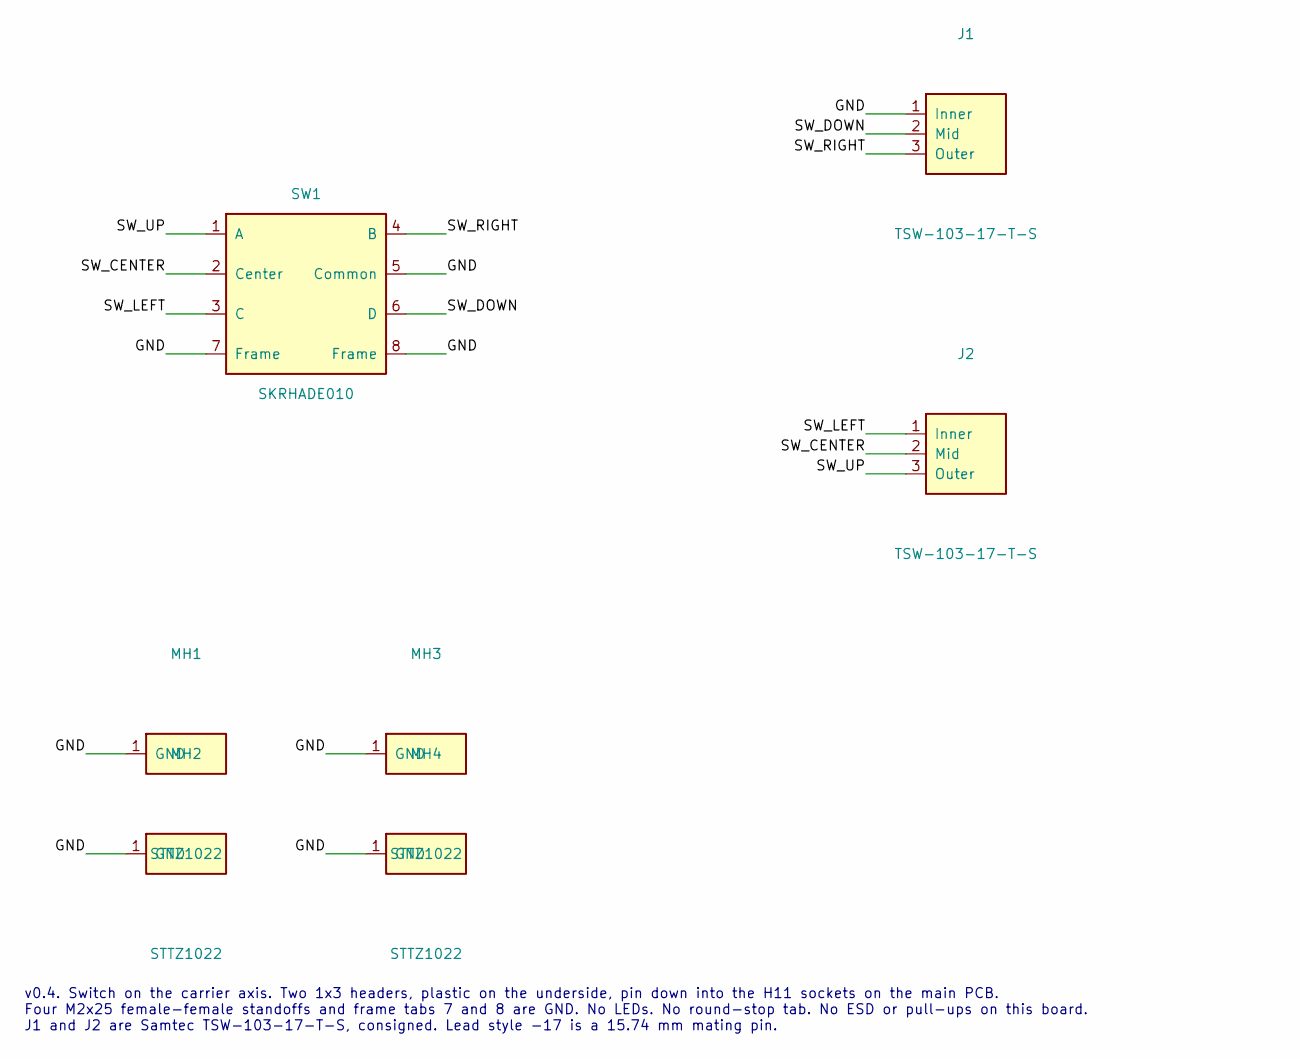
[picture p64: schematic joystick-daughterboard.kicad_sch, Top-screen joystick daughterboard]

Parts:
J1, J2: TSW-103-17-T-S; PinHeader_1x03_P2.54mm_Vertical_Long; MPN TSW-103-17-T-S
MH1, MH2, MH3, MH4: STTZ1022; Mount_M2x35_Standoff; MPN STTZ1022; LCSC C50378470
SW1: SKRHADE010; Alps_SKRHADE010; MPN SKRHADE010; LCSC C202415

Connections:
/GND: J1.1 (Inner), MH1.1, MH2.1, MH3.1, MH4.1, SW1.5 (Common), SW1.7 (Frame), SW1.8 (Frame)
/SW_CENTER: J2.2 (Mid), SW1.2 (Center)
/SW_DOWN: J1.2 (Mid), SW1.6 (D)
/SW_LEFT: J2.1 (Inner), SW1.3 (C)
/SW_RIGHT: J1.3 (Outer), SW1.4 (B)
/SW_UP: J2.3 (Outer), SW1.1 (A)

Notes on the sheet:
v0.4. Switch on the carrier axis. Two 1x3 headers, plastic on the underside, pin down into the H11 sockets on the main PCB. Four M2x25 female-female standoffs and frame tabs 7 and 8 are GND. No LEDs. No round-stop tab. No ESD or pull-ups on this board. J1 and J2 are Samtec TSW-103-17-T-S, consigned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

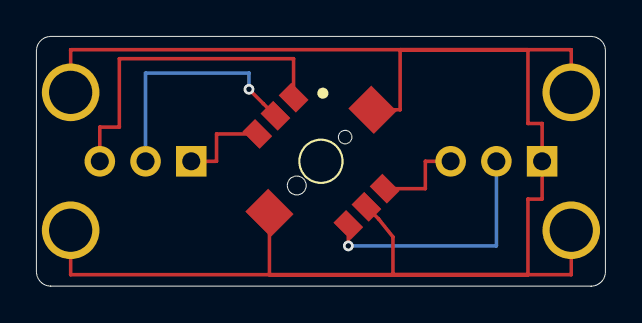
[picture p65: board joystick-daughterboard.kicad_pcb from above]

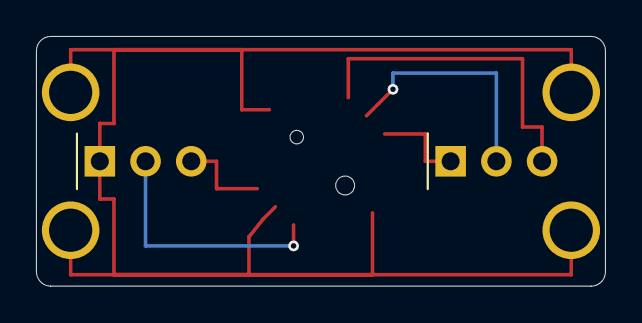
[picture p66: board joystick-daughterboard.kicad_pcb from below]

Board: 2 copper layers, 31.6 x 13.9 mm, 7 parts (2 on the bottom side), 6 nets.
