EdgerEquals/knob-hardware/cad/knob-param/knobparam/electronics/kicad/knob-main-pcb/kicad/knob-main-pcb.kicad_pcb

## KiCad design cad/knob-param/knobparam/electronics/kicad/knob-main-pcb/kicad/knob-main-pcb.kicad_pcb (2026-11-01)

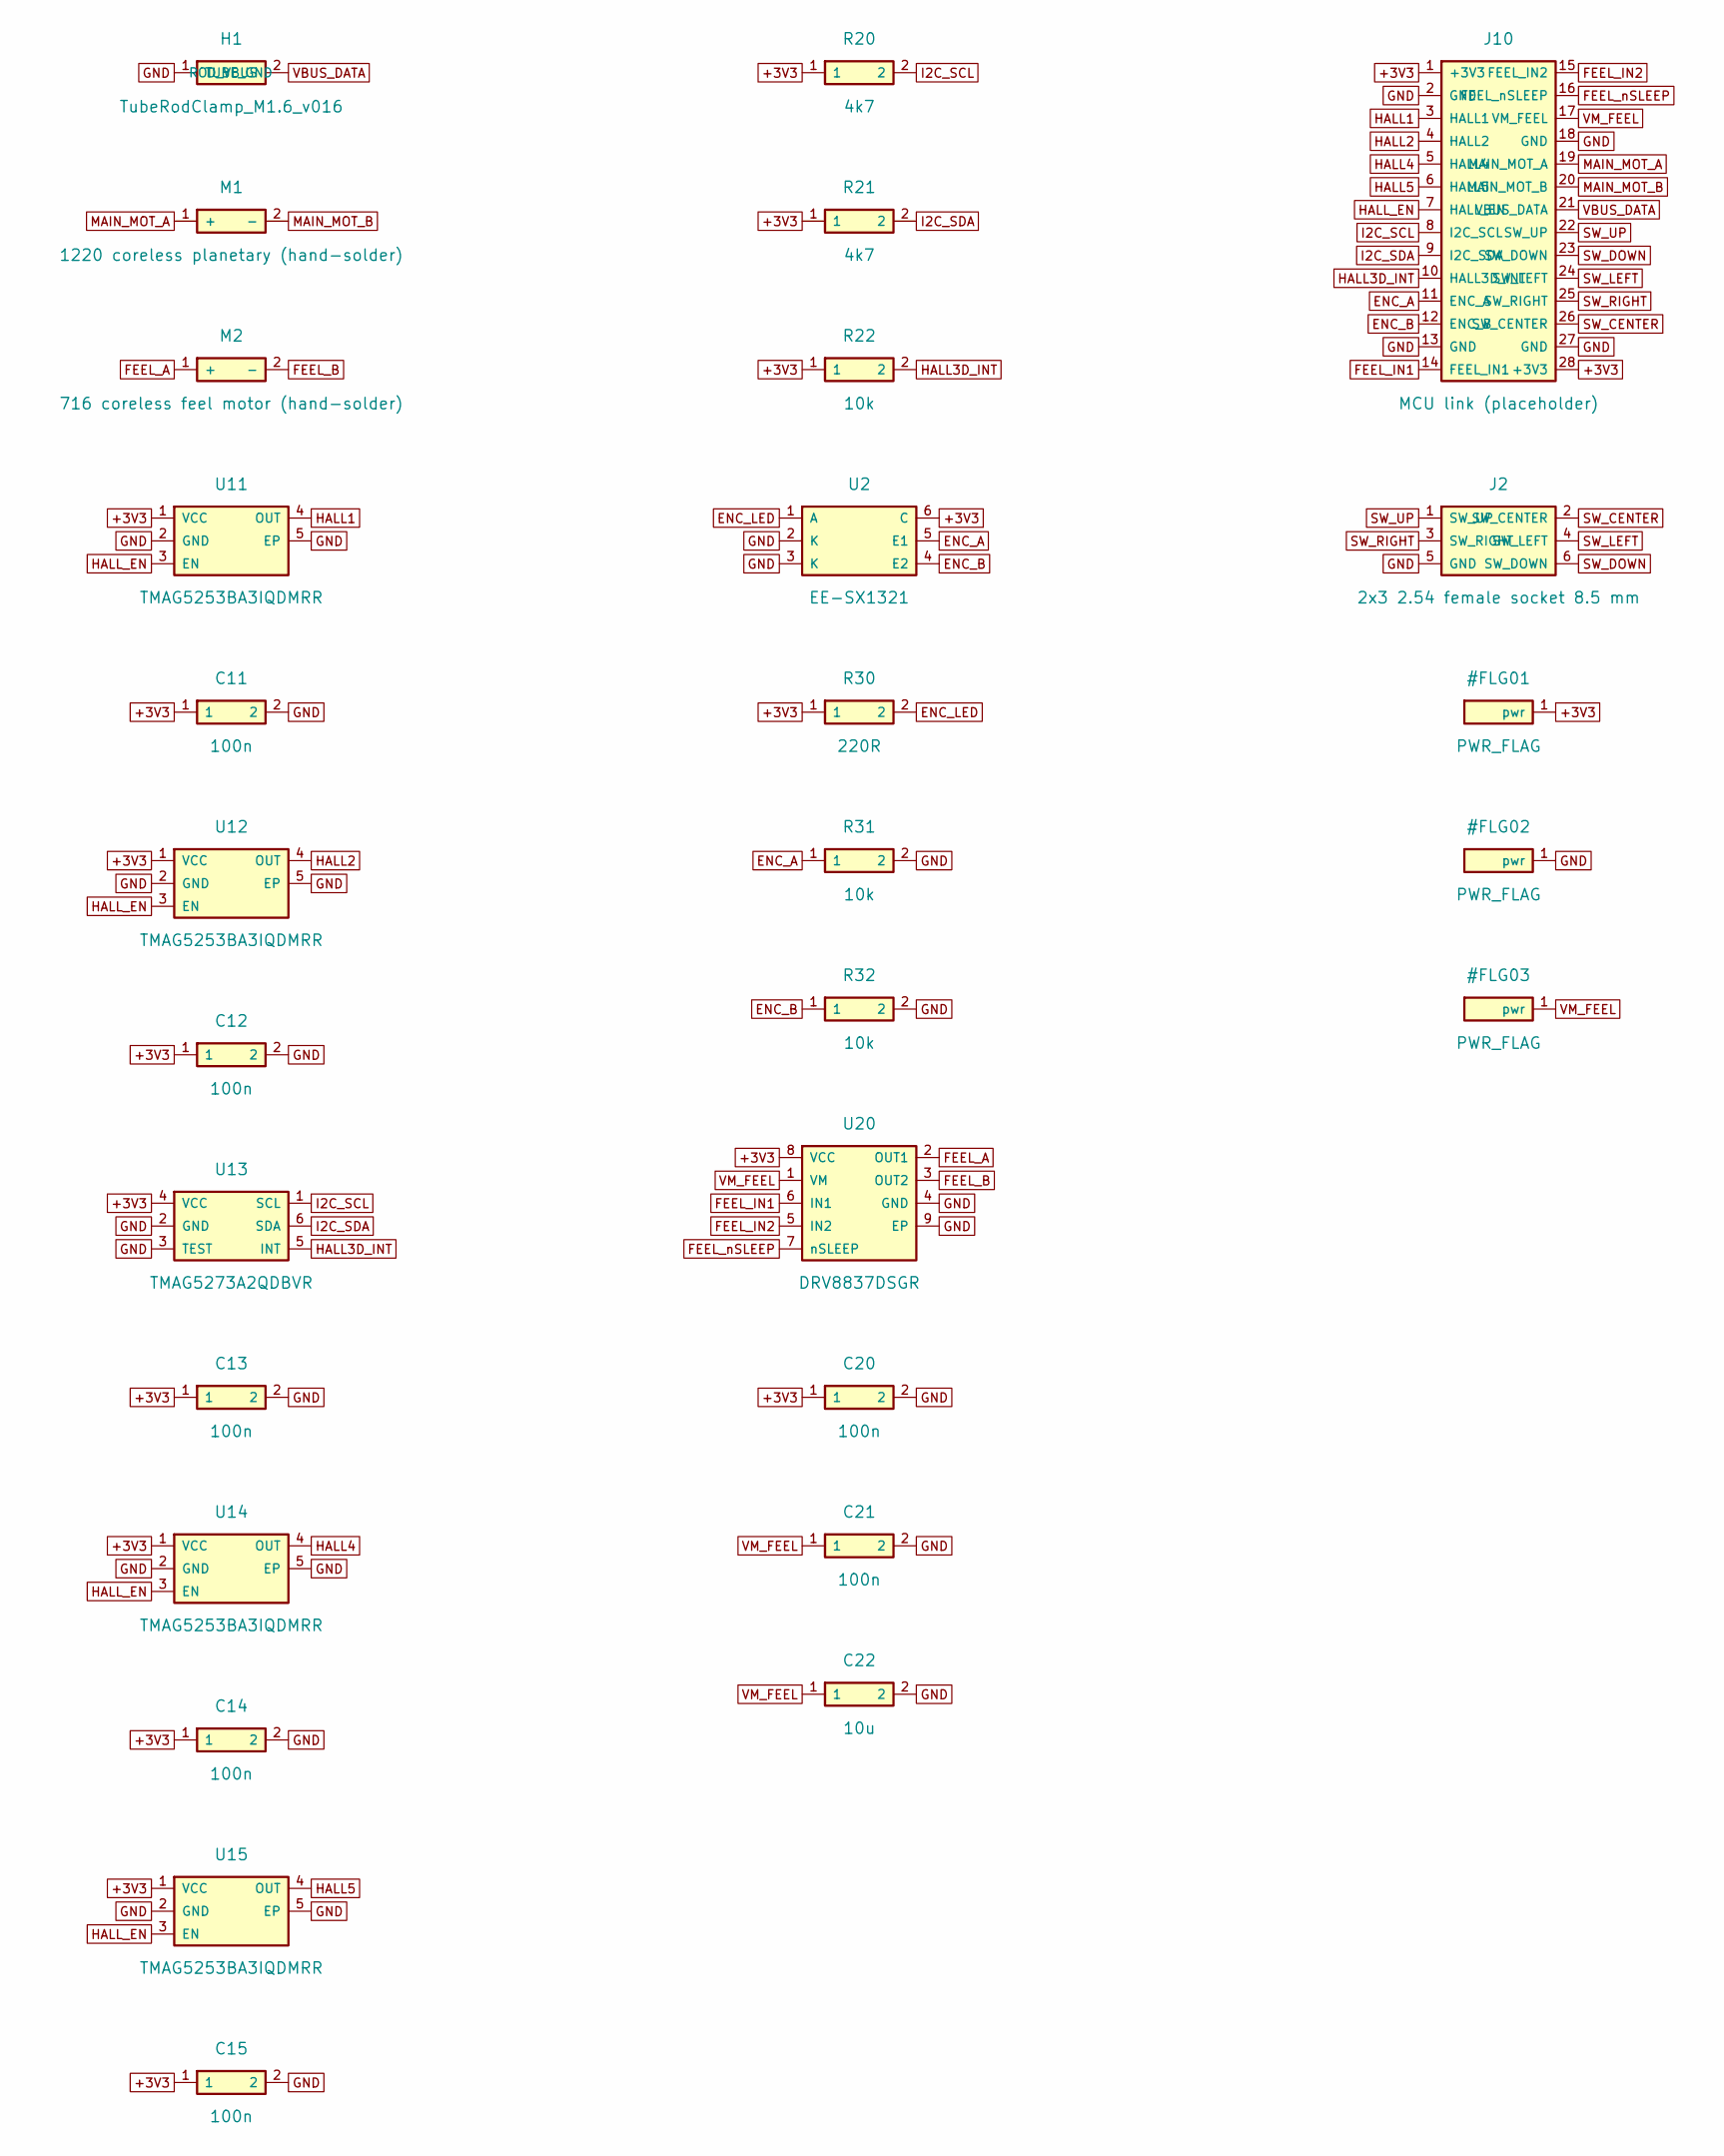
[picture p67: schematic knob-main-pcb.kicad_sch, Knob main PCB v0.11]

Parts:
C11, C12, C13, C14, C15, C20, C21: 100n; C_0402; MPN CL05B104KO5NNNC; LCSC C1525
C22: 10u; C_0603; MPN CL10A106KP8NNNC; LCSC C19702
H1: TubeRodClamp_M1.6_v016; TubeRodClamp_Main_M1.6_v016
J2: 2x3 2.54 female socket 8.5 mm; PinSocket_2x03_P2.54_Vertical_8.5mm; MPN FG-PM2.54-2-03P-H8.5; LCSC C42391433
J10: MCU link (placeholder); Pads_2x14_P2.00_SMD
M1: 1220 coreless planetary (hand-solder); Motor_1220_Tabs_Relief
M2: 716 coreless feel motor (hand-solder); FeelMotor_716_LeadPads
R20, R21: 4k7; R_0402; MPN 0402WGF4701TCE; LCSC C25900
R22, R31, R32: 10k; R_0402; MPN RC0402FR-0710KL; LCSC C60490
R30: 220R; R_0402; MPN 0402WGF2200TCE; LCSC C25091
U2: EE-SX1321; Omron_EE-SX1321; MPN EE-SX1321; LCSC C469128
U11, U12, U14, U15: TMAG5253BA3IQDMRR; X2SON-4_TMAG5253; MPN TMAG5253BA3IQDMRR; LCSC C22401868
U13: TMAG5273A2QDBVR; SOT-23-6_TMAG5273_Tight; MPN TMAG5273A2QDBVR; LCSC C3715882
U20: DRV8837DSGR; WSON-8_2x2_DRV8837; MPN DRV8837DSGR; LCSC C39159

Connections:
+3V3: C11.1, C12.1, C13.1, C14.1, C15.1, C20.1, J10.1 (+3V3), J10.28 (+3V3), R20.1, R21.1, R22.1, R30.1, U2.6 (C), U11.1 (VCC), U12.1 (VCC), U13.4 (VCC), U14.1 (VCC), U15.1 (VCC), U20.8 (VCC)
ENC_A: J10.11 (ENC_A), R31.1, U2.5 (E1)
ENC_B: J10.12 (ENC_B), R32.1, U2.4 (E2)
ENC_LED: R30.2, U2.1 (A)
FEEL_A: M2.1 (+), U20.2 (OUT1)
FEEL_B: M2.2 (-), U20.3 (OUT2)
FEEL_IN1: J10.14 (FEEL_IN1), U20.6 (IN1)
FEEL_IN2: J10.15 (FEEL_IN2), U20.5 (IN2)
FEEL_nSLEEP: J10.16 (FEEL_nSLEEP), U20.7 (nSLEEP)
GND: C11.2, C12.2, C13.2, C14.2, C15.2, C20.2, C21.2, C22.2, H1.1 (TUBE_GND), J2.5 (GND), J10.2 (GND), J10.13 (GND), J10.18 (GND), J10.27 (GND), R31.2, R32.2, U2.2 (K), U2.3 (K), U11.2 (GND), U11.5 (EP), U12.2 (GND), U12.5 (EP), U13.2 (GND), U13.3 (TEST), U14.2 (GND), U14.5 (EP), U15.2 (GND), U15.5 (EP), U20.4 (GND), U20.9 (EP)
HALL1: J10.3 (HALL1), U11.4 (OUT)
HALL2: J10.4 (HALL2), U12.4 (OUT)
HALL3D_INT: J10.10 (HALL3D_INT), R22.2, U13.5 (INT)
HALL4: J10.5 (HALL4), U14.4 (OUT)
HALL5: J10.6 (HALL5), U15.4 (OUT)
HALL_EN: J10.7 (HALL_EN), U11.3 (EN), U12.3 (EN), U14.3 (EN), U15.3 (EN)
I2C_SCL: J10.8 (I2C_SCL), R20.2, U13.1 (SCL)
I2C_SDA: J10.9 (I2C_SDA), R21.2, U13.6 (SDA)
MAIN_MOT_A: J10.19 (MAIN_MOT_A), M1.1 (+)
MAIN_MOT_B: J10.20 (MAIN_MOT_B), M1.2 (-)
SW_CENTER: J2.2 (SW_CENTER), J10.26 (SW_CENTER)
SW_DOWN: J2.6 (SW_DOWN), J10.23 (SW_DOWN)
SW_LEFT: J2.4 (SW_LEFT), J10.24 (SW_LEFT)
SW_RIGHT: J2.3 (SW_RIGHT), J10.25 (SW_RIGHT)
SW_UP: J2.1 (SW_UP), J10.22 (SW_UP)
VBUS_DATA: H1.2 (ROD_VBUS), J10.21 (VBUS_DATA)
VM_FEEL: C21.1, C22.1, J10.17 (VM_FEEL), U20.1 (VM)

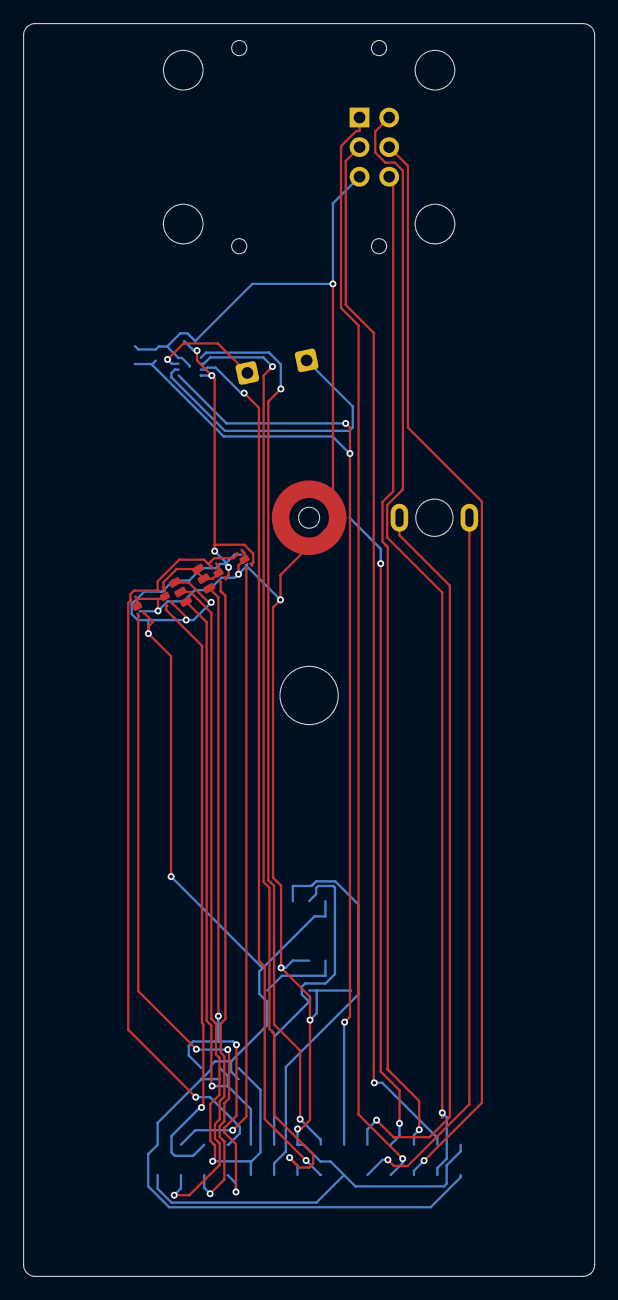
[picture p68: board knob-main-pcb.kicad_pcb from above]

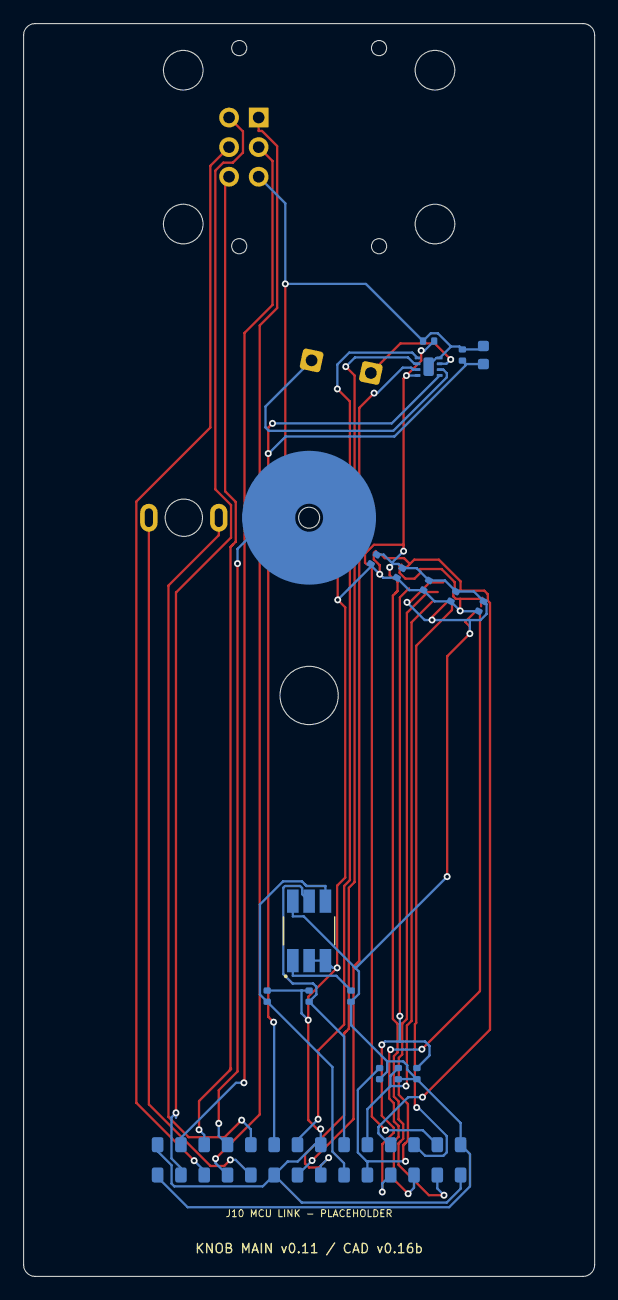
[picture p69: board knob-main-pcb.kicad_pcb from below]

Board: 2 copper layers, 49.0 x 107.5 mm, 28 parts (18 on the bottom side), 27 nets.

Other parts of the board:
H2: Bearing_F682ZZ_Press_NPTH_5.0mm
MH1: TopScreenJoystick_Stack_v016
