EdgerEquals/knob-hardware/cad/knob-param/knobparam/electronics/kicad/screen-adapter/kicad/screen-adapter.kicad_pcb

## KiCad design cad/knob-param/knobparam/electronics/kicad/screen-adapter/kicad/screen-adapter.kicad_pcb (2026-11-01)

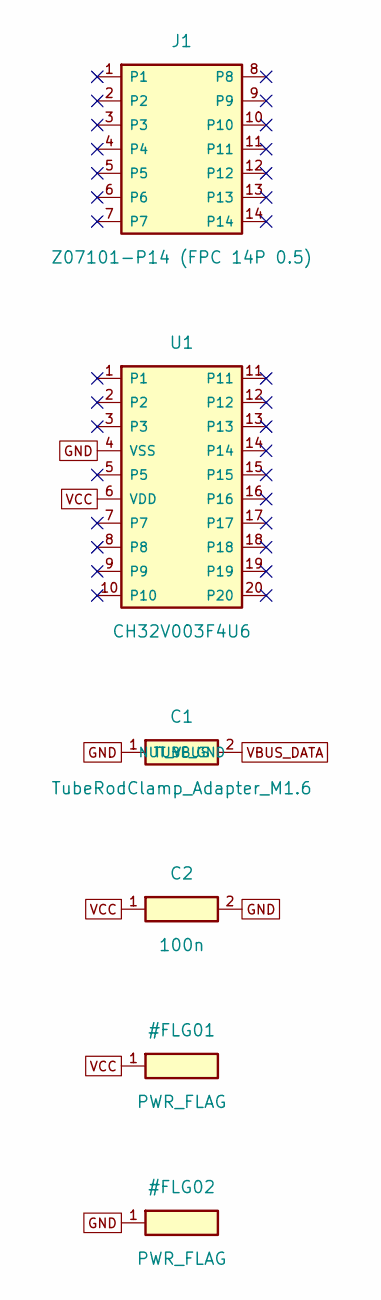
[picture p70: schematic screen-adapter.kicad_sch, Screen adapter v0.4]

Parts:
C1: TubeRodClamp_Adapter_M1.6
C2: 100n; C_0402; MPN CL05B104KO5NNNC; LCSC C1525
J1: Z07101-P14 (FPC 14P 0.5); FPC_14P_0.5mm_Top; MPN Z07101-P14
U1: CH32V003F4U6; QFN-20_3x3_P0.4_CH32V003; MPN CH32V003F4U6; LCSC C5299908

Connections:
GND: C1.1 (TUBE_GND), C2.2, U1.4 (VSS)
VBUS_DATA: C1.2 (NUT_VBUS)
VCC: C2.1, U1.6 (VDD)

Board: 2 copper layers, 4 parts (0 on the bottom side), 2 nets, no tracks yet.
