EdgerEquals/knob-hardware/cad/knob-param/knobparam/assembly/params.py

"""Assembly-agent own params (not geometry of any sub-assembly): output version, cross-check inputs, report densities."""
P = dict(
    # ---- 1220 motor [M] ----
    tab_solder=0.1,   # [A] solder fillet past the motor tab tip on the PCB back
    # ---- v0.15: screen turns with the dial ----
    version="v0.16b",   # output -> assemblies/knob-stack-<version>/
    rho=dict(glass=2.5e-3, pol=1.2e-3, tape=1.0e-3, petg=1.27e-3, ndfeb=7.5e-3, steel=7.85e-3, fpc_g=0.35),   # [A] g/mm3; FPC+B2B mass g
)
