EdgerEquals/knob-hardware/(commit log)

2026-10-31 Initial CAD library: 1220 motor, main PCB (KiCad), brass shaft, knob v0.1, assembly v0.3
    [bottom-ring-gear.dxf, bottom-ring-gear.step, brass-tube-5x3.dxf, brass-tube-5x3.step, fixed-hollow-shaft-4mm-onepiece.dxf, fixed-hollow-shaft-4mm-onepiece.step, fixed-hollow-shaft-4mm.dxf, fixed-hollow-shaft-4mm.step]
2026-10-31 Screen parts: 0.71in round TFT (GC9D01), KiCad screen adapter board, screen holder, brass shaft v0.2 (derived length), screen-stack together sheet; README rows
    [screen-stack-together.dxf, screen-stack-together.step]
2026-10-31 Assembly v0.4: all current parts (PCB v0.3, 1220 motor, brass shaft v0.2, knob v0.1 + bush, screen holder, GC9D01 TFT, adapter board) with pairwise clash check; knob v0.1 sheets re-rendered (tube fla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
    [bottom-ring-gear.dxf, bottom-ring-gear.step, internal-ring-gear.dxf, internal-ring-gear.step, knob-cap-hub.dxf, knob-cap-hub.step, knob-stack-v0.4.dxf, knob-stack-v0.4.step]
2026-10-31 Knob v0.2 (skirt round the offset motor, 90T bottom internal ring), encoder take-off v0.1 (2x F682ZZ, 2 mm shaft, 14T pinion, 94T big gear behind PCB), PCB v0.4 (H2 bearing hole), assembly v0.5 with 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
    [bottom-internal-ring.dxf, bottom-internal-ring.step, encoder-bearing-f682zz.dxf, encoder-bearing-f682zz.step, encoder-big-gear.dxf, encoder-big-gear.step, encoder-pinion.dxf, encoder-pinion.step]
2026-10-31 Assembly v0.5 rev B: front view replaced by full section A-A (dial + motor axes), hatched per part, A-A cutting line on side view; knob v0.2 notes name the encoder pinion
    [bottom-internal-ring.dxf, bottom-internal-ring.step, knob-cap-skirt.dxf, knob-cap-skirt.step, knob-stack-v0.5.dxf, knob-stack-v0.5.step, knob-v0.2-together.dxf, knob-v0.2-together.step]
2026-10-31 Bezel v0.1 (PETG, PTFE 10x8 journal), knob v0.3 (PTFE liner, hub bore 10), encoder take-off v0.2 + PCB v0.5 (H2 bearing from the back), assembly v0.6 with section A-A and clash check
    [bezel.dxf, bezel.step, encoder-bearing-f682zz.dxf, encoder-bearing-f682zz.step, encoder-big-gear.dxf, encoder-big-gear.step, encoder-pinion.dxf, encoder-pinion.step]
2026-10-31 Bezel renamed bezel knob; bezel knob v0.2 (Ø48 ring flush with the glass, ±10° [A]); assembly v0.7 with section A-A + clash check; isometric half-section renders for v0.6 and v0.7
    [bezel-knob.dxf, bezel-knob.step, bezel.dxf, bezel.step, knob-stack-v0.6-half-section.step, knob-stack-v0.7-half-section.step, knob-stack-v0.7.dxf, knob-stack-v0.7.step]
2026-10-31 Assembly v0.7 rev B: z-up sheet layout (top view top-left, section A-A as front, side view rotated 90°); sheet.py default layout z-up, existing scripts pinned to layout=panel
    [bezel-knob.dxf, bezel-knob.step, knob-stack-v0.7.dxf, knob-stack-v0.7.step]
2026-10-31 Knob stack v0.8: base cradle v0.3 on the PCB front (replaces the back flange), control dial v0.3, big knob v0.4, screen holder v0.2, encoder v0.3 (bearing through cradle into PCB as dowel), PCB v0.6 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
    [base-cradle.dxf, base-cradle.step, bezel-knob.dxf, bezel-knob.step, bezel.dxf, bezel.step, bottom-internal-ring.dxf, bottom-internal-ring.step]
2026-10-31 Knob stack v0.9: big knob v0.5 (688ZZ on the dial tube, raised rim), control dial v0.4 (4 mm lip, snap-off fix) + magnet placeholder, base cradle v0.4 (3.5 plate), encoder v0.4 + 2 idler pinions, dat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
    [base-cradle.dxf, base-cradle.step, brass-tube-5x3.dxf, brass-tube-5x3.step, control-dial.dxf, control-dial.step, encoder-takeoff-together.dxf, encoder-takeoff-together.step]
2026-10-31 Knob stack v0.10: big knob v0.6 (rim removed, top 4.3 below the glass; MR128ZZ 8x12x3.5 in a Ø15 hub), control dial v0.5 (4 mm lip out to Ø48 on top of the knob, 0.3 gap; magnet pocket in the lip und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
    [control-dial.dxf, control-dial.step, knob-body.dxf, knob-body.step, knob-stack-v0.10-half-section.step, knob-stack-v0.10.dxf, knob-stack-v0.10.step, knob-v0.6-together.dxf]
2026-10-31 v0.11: motor offset 11 with 12T->32T external hub gear (68T ring removed), knob OD 42, 78T bottom ring, dial tube extended to cradle with 12x1mm thrust bearing, EE-SX1131 sensor on B.Cu with 119-wind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
    [base-cradle.dxf, base-cradle.step, control-dial.dxf, control-dial.step, encoder-big-gear-slotted-rim.dxf, encoder-big-gear-slotted-rim.step, encoder-sensor-ee-sx1131.dxf, encoder-sensor-ee-sx1131.step]
2026-10-31 param-dev: sub-assembly-split parametric model (cad/knob-param), v0.15 baseline
    - knobparam/{main_knob,control_dial,base_drive,under_pcb,electronics}: own params, IMPORTS/EXPORTS,
    parts, local checks; scope enforced by the harness (ScopeError), static cross-sub import lint
    - knobparam/assembly: INTERFACE params, merge, cross-checks + clashes, render, report, Hall dynamics
    - build.py (--sub/--render/--full/--contract/...), report.py, setup.sh, requirements.txt
    - AGENTS.md / CONTRIBUTING.md: one cloud agent per sub-assembly, PRs into param-dev
    - cad/assemblies/knob-stack-v0.15: sections PNG, check.json (32/34 PASS), report-v0.15.txt/.json
    Reproduces v0.15 exactly (derive, geometry, checks, c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
    [knob-main-pcb.dxf, knob-main-pcb.kicad_pcb, knob-main-pcb.step, screen-adapter-with-envelopes.step, screen-adapter.dxf, screen-adapter.kicad_pcb, screen-adapter.step]
2026-11-01 v0.15d: race on 45° chamfer (38xØ1, PCD 13.01), simplified hub corner, min sun gear 24T / pinion 19T, --clean render, adapter_cup param
2026-11-01 v0.16: move the 716 feel motor onto the PCB top, inside the cradle
    Axial at 102° (bisector of idler 1 and idler 2), 22T pinion meshing the 73T bottom ring, so torque still reaches the knob without the under-PCB depth. Knob stays Ø39.5. The geared-depth FAIL is gone; the dial lip wall remains the only failure.
    [build.py, interface.py, params.py]
2026-11-01 knob-param v0.16: min knob Ø40.85 (0.8 lip, closed ring), no adapter cup, carrier cartridge, Hall fan arm 2.5 pitch, spring-ball detents + Ø1 ball track, tangential centring springs, magnet cushions,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
2026-11-01 knob-param v0.16b: remove knob-ring/dial TMAG5273 relative sensor (rel_sensor=False), Hall row H3 = 3D TMAG5273A2 (SOT-23-6, magnets up 0.15 to z 1.75), Hall magnets N/S/N/S/N (hv_pol) in the field m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
2026-11-01 joystick v0.1: SKRHADE010 daughterboard (KiCad, ERC/DRC clean) + joystick-param sub-assembly (20/20 PASS), docs
    [joystick-daughterboard.kicad_pcb, joystick-daughterboard.kicad_sch, joystick-daughterboard.step]
2026-11-01 KiCad v0.16b: main PCB v0.10 (Hall row 4x TMAG5253 + TMAG5273A2, rod pad Ø11.48, 716 lead pads + DRV8837, joystick v0.1 J2 socket/holes/slot/keep-out, J10 MCU-link placeholder; routed, ERC/DRC clean)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
    [knob-main-pcb-v0.10-bom.csv, knob-main-pcb.kicad_pcb, knob-main-pcb.kicad_sch, knob-main-pcb.step, pcb_proxy.json, screen-adapter-v0.4-bom.csv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]
2026-11-01 Main PCB v0.11: U2 Omron EE-SX1131 (discontinued) -> EE-SX1321 (LCSC C469128; new datasheet footprint, pins 1 A / 2+3 K / 4 E2 / 5 E1 / 6 C, R30 220R), J2 = FG FG-PM2.54-2-03P-H8.5 (C42391433), 10k -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
    [knob-main-pcb-v0.11-bom.csv, knob-main-pcb.kicad_pcb, knob-main-pcb.kicad_sch, knob-main-pcb.step, pcb_proxy.json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]
2026-11-01 joystick v0.2: DO0164FMST05 carrier, 11 mm riser, round stop
    Screen top sits 5 mm under the knob top (z 47.5). The carrier grows to
    43.62 x 28.74 and shifts out so a Ø41.7 knob still clears by 0.55 mm at
    full slide. The 11 mm hanxia socket matches M2x11 brass standoffs; the
    carrier floor takes the rest of the stack. A round stop gives the same
    0.40 mm travel on the diagonals. Frame tabs and the standoffs are GND.
    Daughterboard ERC/DRC/parity 0, fab pack ready. 32/32 joystick checks
    pass, 0 clashes. Main PCB KiCad is not edited; the new hole, slot,
    socket and standoff positions are listed in docs/top-screen-joystick.md.
    [joystick-daughterboard-v0.2-bom.csv, joystick-daughterboard.kicad_pcb, joystick-daughterboard.kicad_sch, joystick-daughterboard.step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]
2026-11-01 joystick v0.3: thin carrier, centred switch, 35 mm riser
    Drop the 26 mm carrier floor and the printed base. Raise the daughterboard
    on four M2x35 standoffs and two 1x3 headers so the SKRHADE010 sits on the
    carrier axis, just under a 2 mm shell. A glued plate carries the ball seats
    and the round stop. Screen-well wall is 1.0 mm. ERC/DRC 0, 44/44 checks.
    [joystick-daughterboard-v0.2-bom.csv, joystick-daughterboard-v0.3-bom.csv, joystick-daughterboard.kicad_pcb, joystick-daughterboard.kicad_sch, joystick-daughterboard.step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]
2026-11-01 joystick v0.4: bezel on compression springs, grub preload on the sub-assembly
    Remove the nylon spider, plunger and round stop. The switch is the only
    stop. Four Lee CI 008B springs and M2 grubs sit between the carrier and a
    separate screen carrier; preload is set before the stack goes together.
    Hold-down springs stay. Clearances follow the PCBWay process tolerances.
    [joystick-daughterboard-v0.4-bom.csv, joystick-daughterboard.kicad_pcb, joystick-daughterboard.kicad_sch, joystick-daughterboard.step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]
2026-11-01 joystick v0.4: DTTZ3033 male-female standoff, nut under the PCB
    C50377216 (STTZ2032, female-female) is out of stock. The riser is now
    XHHD DTTZ3033, H3xM2x35+4, LCSC C50377642, held by an ISO 4032 M2 nut
    on the 4 mm stud. The stud leaves 2.40 mm under the 1.6 mm board.
    [joystick-daughterboard-v0.4-bom.csv, joystick-daughterboard.kicad_pcb, joystick-daughterboard.kicad_sch, joystick-daughterboard.step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]
2026-11-01 joystick v0.4: thin bezel on a faceplate, balls out, hold-downs inboard
    The bezel is a 1.2 mm lip on a 2.5 mm UTR-8100 faceplate proxy. The
    carrier and the rest of the stack sit below it and drop through the
    hole. Ball seats move to the plate corners. The yellow tubes outside
    the lip were the hold-down springs; they now sit under the bezel.
2026-11-01 joystick v0.4: shallow cups above and below each ball
    The ball was perched on a flat post. Each seat is now a spherical cup in
    the post and a matching cup in the carrier. Radius and depth are sized
    so the 0.45 mm slide stays 0.20 mm short of the rim.
    [params.py]
2026-11-01 joystick v0.4: rear spring anchor and side-entry cross pins
    The four hold-downs no longer reach the back panel. They end just
    behind the main PCB on a glued rear anchor, two pins along X, each
    through one pair of hooks. Force stays 0.5 N.
    [params.py]
2026-11-01 joystick v0.4: derive the riser from knob_proud
    The faceplate front is the knob top minus knob_proud (18 mm until
    assembly publishes the key). The standoff body follows that face.
    DTTZ3033's 35 mm body is 11.55 mm too long; the derived riser is 23.45 mm.
    [params.py]
2026-11-01 joystick v0.4: 25 mm brass riser and a shorter header pin
    The riser is the in-stock XHHD STTZ1022 female-female M2x25, held by
    ISO 4762 socket screws. knob_proud comes out at 16.45 mm. The Samtec
    pin is lead style -17 so the tip stays above the main PCB.
    [joystick-daughterboard-v0.4-bom.csv, joystick-daughterboard.kicad_pcb, joystick-daughterboard.kicad_sch, joystick-daughterboard.step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]
